rnd-southerniot/rak3112-rs485-node/docs/RUNBOOK.md

# Runbook

Operational log for `rak3112-rs485-node` firmware. Append-only.

## Phase 3 bench checklist + hardware-safety pre-flight

> Run through this **before every flash/monitor** on real hardware (project CLAUDE.md §3,
> firmware domain CLAUDE.md §6). If any item is unknown — **stop and ask**.

1. **H1 jumper INSTALLED** (series 3V3-enable header between RT6160 VOUT and the 3V3 rail).
   A removed jumper cuts 3V3 to the module → board does **not** enumerate on USB and looks
   "not detected" (easy to misdiagnose as a USB/bootloader fault). — ADR-001 EC-5b.
2. **Power:** USB-C (`USB1`) supplies logic via RT6160. Do **not** simultaneously connect the
   DC1 barrel jack and a bench supply without first verifying RT6160 input isolation (§3 #7).
3. **Strap pins:** GPIO0 (SW2/BOOT) is pulled HIGH internally → normal SPI boot; do **not**
   hold SW2 for a normal boot. GPIO45/46 are module-internal / NC — never driven. To force
   download mode (only if `idf.py flash` auto-reset fails): hold SW2, tap SW1, release SW2.
4. **No mass-erase.** `esptool erase_flash` stays gated (§3 #1). Flash is `idf.py flash` /
   `scripts/flash.sh flash` only.
5. **Target verification before flash:** `ls /dev/tty.usbmodem*` then `scripts/flash.sh chip-id`
   → expect **ESP32-S3**. Confirm before writing.

### PASS evidence to capture (quote verbatim here on a green run)

- `Found 8MB PSRAM device` within ~2 s of reset, **and**
- `Adding pool of NNNN KiB of PSRAM memory to heap allocator` in heap-init, **and**
- `rak3112-rs485-node alive: tick=N` incrementing at 1 Hz, **and**
- no bootloop, no `Brownout detector was triggered`, no spurious ROM print on UART0.

### Phase 3 attempts

#### Attempt 1 — 2026-06-20 — PASS (console finding: USB_CDC → USB_SERIAL_JTAG)

**Bench:** two boards connected. Target disambiguated by chip-id/MAC **before** every flash
(Guardrail §3 #1):
- `/dev/cu.usbmodem1301` = **ESP32-S3 (QFN56) rev v0.2, Embedded PSRAM 8MB (AP_3v3)**,
  MAC `3c:dc:75:6f:89:24` → **RAK3112** (target), on its **native USB**.
- `/dev/cu.usbserial-140` = **ESP32-P4**, MAC `30:ed:a0:e1:8e:1c` → unrelated board on a
  USB-UART bridge. Never flashed.

**Console finding (the substantive Phase 3 result).** The Phase-1 default
`CONFIG_ESP_CONSOLE_USB_CDC=y` (OTG/TinyUSB) produced **no visible console** on the RAK3112's
native USB — 0 bytes via raw read *and* via `idf.py monitor`, while the app ran fine (port
stable, no bootloop). The RAK3112 native USB (`USB_D±`) is the ESP32-S3 **USB-Serial-JTAG**
controller — the same interface esptool flashes over. Switching to
`CONFIG_ESP_CONSOLE_USB_SERIAL_JTAG=y` made the console fully visible. This supersedes the
Phase-1 USB_CDC choice in `sdkconfig.defaults`.

Also captured during the investigation: a stale/wedged USB endpoint (`errno 6 Device not
configured`) was cleared by a physical replug + carrier swap; macOS `/dev/cu.*` (call-out)
must be used for reading, not `/dev/tty.*` (dial-in, blocks on carrier).

**PASS evidence (verbatim boot log, USB-Serial-JTAG @ 115200):**

```
rst:0x15 (USB_UART_CHIP_RESET),boot:0x2a (SPI_FAST_FLASH_BOOT)
I (24) boot: ESP-IDF v5.5.4-dirty 2nd stage bootloader
I (25) boot.esp32s3: Boot SPI Speed : 80MHz   SPI Mode : DIO   SPI Flash Size : 16MB
I (73) octal_psram: vendor id    : 0x0d (AP)
I (74) octal_psram: VCC          : 0x01 (3V)
I (75) esp_psram: Found 8MB PSRAM device
I (76) esp_psram: Speed: 40MHz
I (807) esp_psram: SPI SRAM memory test OK
I (816) cpu_start: Pro cpu start user code
I (816) app_init: Project name:     rak3112_rs485_node
I (819) esp_psram: Adding pool of 8192K of PSRAM memory to heap allocator
I (832) app: reserved pins GPIO9/GPIO40 held floating (V1.2 I2C placeholder)
rak3112-rs485-node alive: tick=0
rak3112-rs485-node alive: tick=1
...
rak3112-rs485-node alive: tick=10
```

**Gate result — all PASS:**
- `Found 8MB PSRAM device` present within ~75 ms of reset ✅
- `Adding pool of 8192K of PSRAM memory to heap allocator` present ✅
- Octal mode + 3 V confirmed empirically (`octal_psram vendor id 0x0d (AP)`, `VCC 0x01 (3V)`) —
  matches ADR-001 EC-6 (ESP32-S3R8) ✅
- `SPI SRAM memory test OK` ✅
- GPIO9/GPIO40 floating-init log present ✅ (ADR-001 EC-4/EC-9 carry-forward)
- Heartbeat 1 Hz, monotonic, **no bootloop**, single `rst:0x15`, no `Brownout`/`panic`/`abort` ✅

**Carry-forward note for the contract:** Phase 3 title says "USB-CDC console"; the verified
console is **USB-Serial-JTAG** (native USB). Treat "USB-CDC" in the Phase 3 heading as
"native-USB console". `CONFIG_SPIRAM_SPEED` defaults to 40 MHz (Octal) — a deliberate
non-decision so far; pin explicitly if the 80 MHz bandwidth is ever needed (see Phase 3 review
finding on implicit SPIRAM defaults).

#### Attempt 2 — 2026-06-20 — PASS (re-validated on the CORRECT project board)

**Board correction.** Attempt 1 was flashed to an ESP32-S3R8 with MAC `3c:dc:75:6f:89:24` —
the operator subsequently identified that unit as **NOT the project board** (a second RAK3112
whose pins are not broken out). The actual project board is a *different* RAK3112,
MAC **`3c:dc:75:6f:85:dc`** (pins exposed), enumerating on the same native USB
`/dev/cu.usbmodem1301`. Lesson reinforced: chip-id alone is insufficient when multiple
same-silicon boards are on the bench — **match the MAC to the known project unit** before flash.

Re-flashed the byte-identical Phase-3 firmware (same commit, `phase-3-first-flash-green`) to the
correct board and re-captured. **All gate criteria PASS, identical to Attempt 1:**

```
rst:0x15 (USB_UART_CHIP_RESET),boot:0x28 (SPI_FAST_FLASH_BOOT)
I (73) octal_psram: vendor id    : 0x0d (AP)
I (74) octal_psram: VCC          : 0x01 (3V)
I (75) esp_psram: Found 8MB PSRAM device
I (807) esp_psram: SPI SRAM memory test OK
I (819) esp_psram: Adding pool of 8192K of PSRAM memory to heap allocator
I (832) app: reserved pins GPIO9/GPIO40 held floating (V1.2 I2C placeholder)
rak3112-rs485-node alive: tick=0 .. tick=10   (1 Hz, monotonic, no bootloop)
```

`Found 8MB PSRAM device` ✅ · `Adding pool of 8192K … heap allocator` ✅ · Octal+3V
(`vendor id 0x0d (AP)`, `VCC 0x01 (3V)`) = ESP32-S3R8 ✅ · `SPI SRAM memory test OK` ✅ ·
GPIO9/40 floating ✅ · 1 Hz heartbeat, no `Brownout`/`panic`/`abort` ✅. The Phase 3 sign-off and
tag `phase-3-first-flash-green` stand — same firmware, same PASS, now on the correct unit.

**The project board is MAC `3c:dc:75:6f:85:dc` — use this MAC as the flash-target identity from
Phase 4 onward** (the pins-exposed unit needed for RS-485 / SX1262 bring-up).

## Phase 4 — RS-485 echo: bench setup + attempts

### Bench setup (HIL)

- **Field wiring:** CN1 (3-pin) → USB-RS485 adapter: `A`↔`A`, `B`↔`B`, `GND`↔`GND`.
- **Termination:** the board has **no on-board 120 Ω** (ADR-002). Fit **120 Ω across A/B at both
  bus ends** — one at the adapter, one at the node (or, for the 9600 low-speed first pass on a
  short stub, a single 120 Ω is tolerable). At 115200 use both.
- **Fail-safe bias:** confirm idle line is quiet; if spurious RX bytes appear at idle, add bias at
  one end (A→3V3 / B→GND via ~560 Ω–1 kΩ). R38/R39 (2.2 kΩ) may already provide this — verify.
- **Logic analyzer:** Saleae Logic 2 on **GPIO21** (DE/RE) and the A/B pair; trigger on a TX burst.
- **Project board only:** flash target **MAC `3c:dc:75:6f:85:dc`** (`/dev/cu.usbmodem1301`).

### Two-pass gate (per ADR-002)

1. `RS485_ECHO_BAUD = 9600`, build+flash, loop a 256-byte pattern from the adapter → byte-identical
   echo, 0 framing errors, idle quiet.
2. Change `RS485_ECHO_BAUD = 115200` in `firmware/main/app_main.c`, re-flash, repeat.
3. Saleae: DE-assert→first-bit and last-bit→DE-release within TP8485E spec; no contention.

### Attempt 1 — 2026-06-20 — on-target bring-up PASS (HIL echo pending bench gear)

Firmware (UART1 half-duplex + inverted RTS) flashed to the project board (MAC `…85:dc`).
On-target init verified from the boot log (bus not yet connected):

```
I (837) rs485: RS-485 UART1 up: TX=43 RX=44 DE/RE=21 @ 9600 8N1 (half-duplex, RTS inverted)
I (5837) app: rs485 echo alive: 0 bytes echoed
rak3112-rs485-node alive: tick=0 / tick=1   (5 s cadence)
```

`rs485_init()` (driver install + param + set_pin + RS485 half-duplex mode + RTS invert) returned
ESP_OK — `ESP_ERROR_CHECK` did not abort. PSRAM + GPIO9/40 floating still nominal; no bootloop.
Host `ctest` (ring_buffer, 6 checks) green. **HIL echo + DE/RE turnaround (9600 → 115200) held
pending USB-RS485 adapter + Saleae on the bench.** Binary SHA-256
`8fca54c7e23908108d3a15e9f4a2144836cf097a707f5b2a519fe2fd6d3bb225`.

### Attempt 2 — 2026-06-20 — HIL echo PASS (DE/RE polarity was inverted in the spec)

**Smoke gate PASS — byte-identical echo at both bauds**, driven host-side through a USB-RS485
adapter (256-byte ramp pattern, 16-byte half-duplex bursts):

| Baud | sent | echoed | identical |
|---|---|---|---|
| 9600 8N1 | 256 | 256 | **yes** |
| 115200 8N1 | 256 | 256 | **yes** |

**Root-cause lesson — believe the instrument, not the spec; and build a ground-truth detector
early.** Bring-up burned many cycles chasing the adapter and A/B polarity (two adapters, both
A/B orientations, RTS/DTR combos, a 5V jumper) — all red herrings. The break came from a
*reliable detector*: reading the DUT's own RX counter over the (now-working) USB-Serial-JTAG
console, then a toggle diagnostic that drove GPIO21 as a plain output alternating HIGH/LOW
while listening. Result was unambiguous: **GPIO21 LOW → clean RX of the pattern; GPIO21 HIGH →
nothing.** So DE/RE is **standard** (HIGH=TX, LOW=RX), *not* inverted.

`ADR-001 EC-5a` had documented it inverted (`GPIO21 HIGH = receive`); `rs485.c` faithfully
inverted RTS to match, which **idled U9 in transmit** — the node never listened and its driver
contended with the partner (that's why earlier captures were empty or garbled). Fix:
`uart_set_line_inverse(..., UART_SIGNAL_INV_DISABLE)` (no inversion). Corrected in firmware
(ADR-002 rev2, `gpio_remap.h`, `PIN_MAP.md`) and hardware-side (ADR-001 EC-5a correction).

Adapter note: once polarity was right, **Adapter 1 (CH340)** gave byte-identical echo at both
bauds. Adapter 2 (FT232/75176) delivered no signal in this setup (separate, unresolved adapter
issue) — not on the project's critical path.

Saleae DE/RE turnaround characterization: deferred/optional — byte-identical echo at 115200
(where turnaround margin is tightest) already demonstrates correct DE assert/deassert timing.

## Phase 5 — LoRaWAN OTAA (AS923): attempts

### 5a — 2026-06-20 — SX1262 SPI bring-up PASS (pins confirmed, NO TX)

**Finding (research): ADR-001's SX1262 SPI pins were wrong.** ADR-001 labelled the module-edge
`GPIO10–13 / SPI_*` pins as the SX1262 SPI. Those are a **separate user SPI**; the radio is on a
different **module-internal** bus. Triangulated from RAK3112 datasheet + RAK forum (carlrowan
RadioLib config) + Zephyr `rak3112` DTS — all agree:

| SX1262 | GPIO | | SX1262 | GPIO |
|---|---|---|---|---|
| NSS/CS | 7 | | BUSY | 48 |
| SCK | 5 | | DIO1 (IRQ) | 47 |
| MOSI | 6 | | NRESET | 8 (open-drain) |
| MISO | 3 | | ANT_SW | 4 (active-low) |

RF switch driven by SX1262 **DIO2** (`setDio2AsRfSwitch`), TCXO by **DIO3** — both SPI-internal,
not MCU pins. (GPIO3 is a JTAG-source strap at reset but free post-boot = MISO.)

**Bench confirmation (no-TX SPI probe, no antenna — safe).** Probe: SPI2 on the pins above,
hardware reset, then GetStatus + register write/read round-trip. Console (project board MAC
`3c:dc:75:6f:85:dc`):

```
lora_probe: SX1262 probe: NSS=7 SCK=5 MOSI=6 MISO=3 RST=8 BUSY=48 DIO1=47
lora_probe: post-reset BUSY=0
lora_probe: GetStatus=0x2a  regRW[wab:rab w55:r55 w12:r12 ] => SPI OK -> pins CONFIRMED
```

`BUSY=0` after reset, `GetStatus=0x2a` (chip mode = STBY_RC, sane post-reset), and all three
register write/read pairs matched → **SPI comms confirmed, pins correct.** Zero RF emitted.
Pins locked in `gpio_remap.h`; ADR-001 SX1262 pin map corrected hw-side. **Stack = RadioLib**
(native ESP-IDF, ADR-003). **5b (OTAA join, RF TX) held pending a 50 Ω antenna/dummy load** and
go-ahead to register a test DevEUI on ChirpStack `10.10.8.140`.

### 5b-prov — 2026-06-20 — CRM provisioning COMPLETE (device registered in ChirpStack)

Provisioned the node **end-to-end through the SCOMM CRM** (system of record) per the firmware↔CRM
handoff contract — not by hitting ChirpStack directly. Tool: `tools/provision_node.py` (chains
the workflow API; reads CRM creds from `~/.config/siot/rak3112-crm.env`, DevEUI/AppKey from the
gitignored `firmware/.env`). CRM repo: `rnd-southerniot/siot-crm-review`.

- **DevEUI** `3cdc75fffe6f85dc` — derived from the ESP32-S3 MAC `3c:dc:75:6f:85:dc` (EUI-64,
  fffe-inserted) → deterministic / re-provisionable. **JoinEUI** `0000…0`. **AppKey** generated
  (16 B, in `firmware/.env`, gitignored — never logged/committed; gitleaks clean).
- CRM product `RAK3112-RS485-AS923` (`isLorawanProduct`, AS923) created + SOP template; onboarding
  task walked SCHEDULED_VISIT → REQUIREMENTS_COMPLETE → HARDWARE_PROCUREMENT_COMPLETE →
  HARDWARE_PREPARED_COMPLETE (DevEUI/AppKey in `deviceList`) → checklist → READY_FOR_INSTALLATION.
- **Result:** CRM `lorawanProvisioningStatus=COMPLETED`; `GET /chirpstack/device/3cdc75fffe6f85dc`
  → `found=true`, name `RAK3112-RS485-6F85DC`, on AS923 OTAA app `9dcd1954…` + device profile
  `80b53d57…`. Device is ready for OTAA join (ADR-004 = AS923-1).

Contract gotchas captured (vs the handoff note / agent contract): SOP-template POST needs
`productId` in the body + steps with `id/title/description/order`; READY_FOR_INSTALLATION takes
an **empty** body (whitelist rejects lat/long). Used the seeded ADMIN account (passes all role
gates). **Security flag:** the production CRM's seeded admin/role passwords are hardcoded in the
**public** `siot-crm-review` `prisma/seed.ts` — recommend rotating + moving to env (global §8).

Still pending for the actual join (RF TX): RadioLib firmware integration, **50 Ω antenna**, and
**TCXO voltage confirm** (1.6 V vs 1.8 V, ADR-003 open item).

### 5b-fw — 2026-06-20 — OTAA JOIN SUCCESS; data uplink TxDone open

RadioLib 7.7.1 integrated as a native ESP-IDF managed component (`firmware/main/idf_component.yml`)
with a vendored S3 HAL (`EspHalS3.h`) — **the bundled `EspHal.h` is ESP32-classic only and
`#error`s on S3** (it bit-bangs classic SPI registers); reimplemented on `spi_master`/`gpio`.
C++ `lora.cpp` behind a C API (`lora.h`) for `app_main.c`. Antenna attached.

- **TCXO = 1.8 V works** (first try; `radio.begin(..., 1.8f, false)`), `setDio2AsRfSwitch(true)`.
- **OTAA JOIN SUCCESS** at AS923-1 on the project board (DevEUI `3cdc75fffe6f85dc`):
  `JOINED AS923 (new session)` — RadioLib received the JoinAccept, i.e. ChirpStack
  (`10.10.8.140`) accepted our JoinRequest (AppKey valid) and downlinked the accept. **Full RF
  TX+RX round-trip + the device is live on the network.**
- **DevNonce persistence (NVS)** added and verified: first boot's join used DevNonce ~0;
  reboots without persistence failed `-1116` (no-join-accept — ChirpStack rejects reused/lower
  DevNonce). Persisting the nonces buffer after every attempt makes DevNonce climb monotonically
  → re-join succeeded on the next attempt; session is also persisted/restored
  (`session restored (no re-join)` on subsequent boots, instant).

**OPEN — data uplink `sendReceive` returns `-5 RADIOLIB_ERR_TX_TIMEOUT`** (consistent, both on a
fresh `NEW_SESSION` and on `SESSION_RESTORED`). It fails in ~190 ms — too fast for an SF9 ToA
timeout, so it's **not** data-rate/ToA (forcing DR3+ADR-off did not help), and not nonce/session
(the session is valid). The join's TX gets its TxDone, but the data-uplink TX does not — prime
suspect was the vendored `EspHalS3` DIO1 ISR path. **ISR FIXED** (proper `void(void*)` trampoline
instead of the UB function-pointer cast; ISR service installed without `ESP_INTR_FLAG_IRAM`) — a
real latent bug, but it did NOT clear the -5. **Refined root cause (from RadioLib source):**
`LoRaWANNode::transmitUplink` (LoRaWAN.cpp:1531) does NOT use the ISR — it **polls
`digitalRead(DIO1/GPIO47)`** for TxDone after `sleepDelay(ToA)`, and times out at `txEnd +
scanGuard`. The radio's TX is staged + launched without error (the `RADIOLIB_ASSERT`s pass), but
**TxDone never asserts on the data uplink** — while the join's TX (same polling path) did. So the
SetTx is accepted but the transmit doesn't complete/assert DIO1 on the data frame specifically.
Next debug step: enable `RADIOLIB_DEBUG_PROTOCOL`/`_BASIC` to capture the uplink's actual DR / ToA /
TX power / channel and where it diverges from the join, and scope GPIO47 (+ the RF) on a data TX.
Whether the frame physically goes out
(ChirpStack frame log) couldn't be checked — the CRM `/chirpstack/device` endpoint returns device
config only (no last-seen/fcnt/frames). **Phase 5 not signed off until an uplink frame lands.**

### 5c — 2026-06-22 — data uplink `-5` FIXED (100 Hz FreeRTOS tick was the root cause)

**Fix: `CONFIG_FREERTOS_HZ=1000` in `sdkconfig.defaults`.** Single change; bench-verified.

The 5b-fw "refined root cause" (TxDone never asserts on the data frame specifically) was a
misread — and so was "fails in ~190 ms, too fast for an SF9 ToA timeout, so not data-rate." The
fast failure *is* the tell. `LoRaWANNode::transmitUplink` waits with `sleepDelay(toa)` then polls
`digitalRead(DIO1)` until `millis() > txEnd + scanGuard`, and **`scanGuard = 10 ms`**
(LoRaWAN.h:990). At the ESP-IDF default **100 Hz tick (10 ms)**:

- `sleepDelay(toa)` → `vTaskDelay(pdMS_TO_TICKS(toa))` quantizes/undershoots the air-time by up
  to one tick (≈10 ms), so the poll starts *before* the real TxDone; and
- `millis()` advances in 10 ms steps and the guard is exactly **1 tick**, so `txEnd + 10 ms` is
  reached almost immediately → `-5` in ~one tick. That's why it "failed too fast" and why forcing
  DR3/ADR-off did nothing — it was never a DR/ToA problem.

At **1000 Hz**: `sleepDelay` is accurate to ~1 ms and the 10 ms guard is 10 ticks of real poll
window → DIO1 is caught every time. (The join tolerated 100 Hz because `app_main` retries the
join 5× and its longer-ToA timing occasionally aligned; the periodic data uplink had no such
retry, so it failed every cycle.) The earlier DIO1-ISR-trampoline fix (5b-fw) was a real latent
bug on the **downlink** ISR path and is kept — it just wasn't this bug.

**Bench evidence (project board, S3R8, MAC `3c:dc:75:6f:85:dc`, `/dev/cu.usbmodem1401`):**
`idf.py flash` of the 1 kHz build, then **4/4 consecutive `uplink OK (rx window=0)`** at uptimes
65 s / 128 s / 190 s / 252 s, **zero `-5`** — replacing the previously consistent `uplink failed
(-5)`. `rx window=0` = uplink sent, no downlink pending (correct for an unconfirmed uplink).
Binary SHA-256 `38105b4eaa218685a218a2505b3d2af7c5de2cc4e3b9dfd03fe926e32f9b9f9a`, `IDF_VER=v5.5.4-dirty`
(local PARLIO mod, off-compile-path, Footnote 1).

**Lesson:** RadioLib LoRaWAN on ESP-IDF needs a 1 kHz FreeRTOS tick — its TX-done guard and RX
window timing assume ~ms scheduling granularity; the 100 Hz default silently breaks sub-tick
waits.

**END-TO-END CONFIRMED (2026-06-22):** uplink frame captured in the ChirpStack frame log
(`10.10.8.140:8080` UI). `UnconfirmedDataUp`, DevAddr `01db1032`, **fPort 1**, frm_payload
**`a500245a`** (= `A5 00 24 5A`, our `{0xA5,n>>8,n,0x5A}` with n=36), **fCnt 98** (advancing,
NVS-persisted), ADR off, **SF9/BW125/CR4_5 = DR3** on **923.4 MHz**, region `as923_1`,
`CRC_OK`, RSSI −48 dBm, SNR +12.2 dB via gateway `ac1f09fffe1f340d`. Every field matches the
firmware config — the uplink path is fully working end-to-end. The CRM `/chirpstack/device`
endpoint (`:4000`) returns config only (no telemetry); frame verification must use the
ChirpStack UI/API at `:8080` directly. **Phase 5 uplink milestone: PASS.** (Remaining Phase 5
sign-off scope — ADR-003 stack / ADR-004 sub-band formal close, payload schema — tracked separately.)

## Phase 6 — Modbus RTU master: device pivot to SELEC MFM384 (2026-06-24)

**Target change.** Phase 6 bring-up retargeted from the RS-FSJT-N01 wind sensor to a **SELEC
MFM384** 3-phase multifunction meter. Rationale: the RS-FSJT bench was blocked on a sensor↔CN1
*physical* join (open conductor / no common GND in both A/B orientations — node CN1 TX path itself
proven byte-perfect in Phase 4). The firmware was never the blocker. The MFM384 is mains/aux-powered
with its own RS-485 terminals (no separate bus PSU to lose), so it sidesteps that failure mode.

**MFM384 Modbus map** (from the org's proven RAK3312 bring-up, `rnd-southerniot/rak3312-rs485-plan`
`docs/rak3312/MODBUS_MAP.md`, which reached Gate 8 live publish on this exact meter):

| Read | FC | Register (human → wire) | Type | Notes |
|---|---|---|---|---|
| Linkcheck | 0x03 | 40007 → 6 | uint16 | any reply proves the link |
| Endianness | 0x03 | 40070 → 69 | uint16 | expect `1` = ABCD word order |
| Total active energy | 0x04 | 30090..30091 → 89..90 | float32 ABCD | kWh |

Serial (org bench known-good): **9600 8N1, unit 1**. MFM384 baud/unit are front-panel configurable,
so the operator's meter may differ — the scan profile sweeps baud×parity if so.

**Firmware support added this session** (float32 + FC04, on top of the existing 6a/6b framing):
- `modbus_rtu`: pure `modbus_regs_to_f32(regs, ABCD|CDAB)` — host-tested KAT (`{0x447A,0x0000}` ABCD
  = 1000.0f). No aliasing UB (memcpy type-pun).
- Poll bring-up mode now takes a function code (FC03/FC04) and an optional float32 read (2 regs);
  scan probe register is now configurable.

**Bench bring-up sequence (operator):**
1. **Wiring:** MFM384 A/B → CN1 A/B, and a **common GND** (meter RS-485 GND ↔ CN1 GND). Confirm the
   meter is powered (front-panel lit) and in **RTU** mode at its configured baud/unit.
2. **Linkcheck first** (quick "is it alive", uint16 @ FC03 reg 6):
   ```bash
   cd firmware && . ~/esp/esp-idf-v5.5.4/export.sh
   idf.py -DSDKCONFIG_DEFAULTS="sdkconfig.defaults;sdkconfig.defaults.poll" build flash monitor
   # expect: [n] reg6 = <value> (raw, 0x....)   — a reply = link good. swap A/B if it times out.
   ```
3. **If linkcheck times out / unknown baud:** run the scanner (sweeps baud×parity×unit IDs):
   ```bash
   idf.py -DSDKCONFIG_DEFAULTS="sdkconfig.defaults;sdkconfig.defaults.scan" build flash monitor
   ```
   (Set `CONFIG_APP_MODBUS_SCAN_PROBE_REG=6` for the MFM384's known-good holding register.)
4. **Real measurand** (total active energy, float32 kWh @ FC04 reg 89..90):
   ```bash
   idf.py -DSDKCONFIG_DEFAULTS="sdkconfig.defaults;sdkconfig.defaults.mfm384" build flash monitor
   # expect: [n] reg89..90 = 0x........  = <kWh>
   ```
   If the float looks like garbage, the meter uses CDAB — set `CONFIG_APP_MODBUS_POLL_FLOAT_CDAB=y`.

The old RS-FSJT profile is preserved as `sdkconfig.defaults.poll-rsfsjt` (4800 8N1, FC03 reg 0).

**Attempt 1 — scan, MFM384 not reached (2026-06-24).** Flashed `sdkconfig.defaults.scan` to project
board MAC `3c:dc:75:6f:85:dc` (ESP32-S3R8, 8MB octal PSRAM OK, native USB `/dev/cu.usbmodem11301`).
Full sweep ran clean: 18 combos (9600/4800/19200/38400/57600/115200 × 8N1/8E1/8O1), IDs 1–10, FC03
@reg 6, 300 ms timeout → **0 devices, 0 garbage in every combo**. Firmware/board healthy (scan
executed start to finish). `0 garbage` everywhere ⇒ no malformed bytes received at any baud, i.e.
**no electrical return path or no responder** — NOT a baud/parity mismatch (that would surface as
garbage). Distinguishing causes left to the operator: (a) wiring — A/B on CN1, common GND, meter
powered + in Modbus RTU mode; (b) unit ID > 10 (sweep capped at 10; wrong-slave = silence by spec).
**Fastest disambiguation: read baud/parity/slave-ID directly off the MFM384 front-panel setup menu**
and set the poll profile to those exact values, then widen `CONFIG_APP_MODBUS_SCAN_ID_HI` if needed.

**Hardware cross-check vs proven reference (2026-06-24).** The org's `rak3312-rs485-plan`
`examples/rak3312_mfm384` (reached Gate 8 live on this exact meter) was reviewed line-by-line. Our
firmware matches it in every protocol dimension: TX=GPIO43, RX=GPIO44, DE=GPIO21, DE polarity
HIGH=TX/LOW=RX, 9600 8N1 unit 1, linkcheck FC03 reg 6, energy FC04 reg 89 qty 2 with float
`u32=(hi<<16)|lo` (= our ABCD word order). **One difference, and it does NOT apply to us:** the
RAK3312 reference drives RS-485 through a **RAK5802 module with a separate ENABLE pin on GPIO14
(WB_IO2) that must be HIGH before any Modbus traffic** — if low, that module is disabled and the bus
goes totally silent (our exact symptom). Our board has **no such enable pin**: RAK3112 + onboard
TP8485E, DE/RE on GPIO21 only, and Phase 4 echo proved that path works to a USB-RS485 adapter with
GPIO21 alone. So GPIO14 is RAK5802-specific, irrelevant here. **Net: firmware confirmed correct
(twice — Phase 4 echo + reference match); the silence is purely the MFM384↔CN1 physical link.** The
reference's own troubleshooting reduces to "confirm A/B wiring and common GND" — which is the bench
action. SELEC MFM384 RS-485 terminals may be labeled opposite to CN1 A/B → try both orientations.

**Attempt 2 — FC03 + FC04 polls, still silent (2026-06-24).** Operator confirmed meter target
9600 / unit 1 / parity none. Flashed `sdkconfig.defaults.poll` (FC03 reg 6, linkcheck) → steady
`timeout (st=-2)`, 0 bytes. Then a **second proven reference** was reviewed:
`southern-rnd/ETS-LORA-Test/.../rak3112_ets_careflow_anemometer_espidf` — **same RAK3112 + same
MFM384, ESP-IDF, tested working**. It reads the MFM384 **entirely over FC04 input registers**
(voltage-first map: V1N @ reg 0, …, Total kWh @ reg 58), float via `memcpy` of
`u32=(hi<<16)|lo` with **first register = LOW word (CDAB)** — note this conflicts with the RAK3312
gate3 map (energy @ reg 89, first register = HIGH word = ABCD); the two proven repos disagree on
both register map and word order, so when bytes finally flow we must try FC04, both maps, and both
word orders. Pins/baud/DE-polarity all match ours (TX43/RX44, 9600 8N1, HIGH=TX). DE pin differs
(ETS=GPIO34) but that's a *different carrier* (TFT/touch/RFID board); our DE=GPIO21 is Phase-4-proven
(echo 256/256 — impossible unless GPIO21 drives our TP8485E) and confirmed in this boot log
(`UART1 up: TX=43 RX=44 DE/RE=21`). Acting on the FC04 finding, flashed `sdkconfig.defaults.mfm384-volt`
(FC04 reg 0, float32) → **still `timeout (st=-2)`, 0 bytes**. **Verdict: function code is NOT the
cause; the meter returns zero bytes for both FC03 and FC04 at the swept baud/parity. Firmware
exonerated three independent ways (Phase 4 echo + RAK3312 + ETS). Blocker is purely physical /
meter-not-transmitting.** No firmware change can turn zero returned bytes into data. Next is an
electrical bench check (see below) — not more flashing.

**Electrical bench plan (operator — localizes node-TX vs meter-reply vs wiring):**
1. **Is the MFM384 actually wired to CN1 and powered right now?** It needs its aux/line supply; an
   unpowered meter is dead-silent. Three timeout flashes with proven-correct firmware most often
   means the bus isn't truly connected/powered.
2. **A/B + common GND:** MFM384 A→CN1 A, B→CN1 B (try the swap — SELEC labels may be reversed), and
   meter RS-485 GND/COM → CN1 GND. Verify each with a multimeter continuity check.
3. **Scope/Saleae** (the ground-truth detector, per the RS-FSJT lesson) on **GPIO43 (TX)**,
   **GPIO21 (DE)**, and **CN1 A/B** during a poll tick: confirm (a) a TX frame leaves on GPIO43,
   (b) DE pulses high around it, (c) the A/B differential actually swings, (d) whether the meter
   ever drives a reply. This isolates node-TX vs meter-reply vs cabling in one capture.
4. **Meter config:** confirm RS-485/Modbus output is **enabled** in the MFM384 menu (not just baud
   set) and that 9600/8N1/unit-1 are the *active* settings, not defaults shown on a spec sheet.

**Attempt 3 — proven ETS code flashed verbatim, still times out (2026-06-24).** Operator reported
power/A-B/GND/meter-config all checked OK, and asked to flash the proven `ETS-LORA-Test` code on our
board changing only DE/RE GPIO34→GPIO21. The full ETS app is a *touchscreen* app (Modbus only runs
after a TFT tap; never polls headless) and needs the Arduino+TFT_eSPI BSP — so instead a **minimal
headless port** was built (scratch `mfm_ets_test/`): their **`ModbusMaster` library verbatim**, their
exact init/read/preTransmission/postTransmission, DE=GPIO21, UART1 TX43/RX44 9600 8N1 unit 1,
auto-polling FC04 reg 0 + FC03 reg 6, logging over USB-JTAG. arduino-esp32 **3.3.10** resolved/built
clean against IDF 5.5.4. Flashed to board `3c:dc:75:6f:85:dc`. Result: **`err=0xE2`
(`ku8MBResponseTimedOut`) on every read, both FCs** — identical to our own firmware. **The proven
known-good code gets nothing back either ⇒ firmware is exonerated a 4th way (Phase 4 echo + RAK3312
+ ETS source match + ETS code run verbatim). The fault is purely physical, localized to this bench's
node↔meter link.**

**Cleanest next split (no scope needed — same method that cleared the RS-FSJT sensor): cross-check
with the USB-RS485 adapter.** Move the adapter onto the *exact* wiring going to the MFM384 (adapter
A/B/GND where CN1 connects) and run `pymodbus` from the Mac (FC04 reg 0 and FC03 reg 6, 9600 8N1
unit 1). Two outcomes:
- **Adapter ALSO can't read the meter** → fault is the **meter or its wiring/power** (not our board).
  Focus there: re-meter GND continuity, try A/B swap at the meter terminals, confirm the meter's
  RS-485 port is the right terminal pair and is enabled, consider 120 Ω termination + bias.
- **Adapter CAN read it but our board can't** → fault is **our board's CN1 / TP8485E path to this
  meter** (despite Phase 4 echo). Then scope GPIO43(TX)/GPIO21(DE)/CN1 A-B to find where the frame
  dies. (Note: Phase 4 echo used an adapter with strong internal bias/termination; a bias/termination
  difference on this meter link is a candidate — ADR-002 left 120 Ω + fail-safe bias external.)

**Attempt 4 — RESOLVED: DE/RE wiring fault; MFM384 read live (2026-06-24).** Operator found and
fixed a **DE/RE connection issue** at the bench. Re-monitored the still-flashed ETS-port test →
**immediate success**: `FC04 reg0 OK: 0x424A51EC = 50.58 (V1N)` and `FC03 reg6 OK: 350` every cycle,
zero timeouts. The DE/RE fault was the entire blocker — with the transceiver never switching
direction correctly, the meter never saw a valid frame (or the node never released to RX). **Firmware
was correct all along (proven 5 ways).** Reflashed **our** firmware (`sdkconfig.defaults.mfm384-volt`,
FC04 reg 0 float) → first attempt showed garbage floats with raw words like `0xC28F424A`; the high
word `424A` (voltage ~50 = 0x424A…) sat in the **second** register ⇒ this meter transmits **low word
first = CDAB**, not ABCD. The ETS code reads `buffer[0]` as the low word (CDAB) — correct for this
meter; the RAK3312 "ABCD" note did NOT hold here. Set `CONFIG_APP_MODBUS_POLL_FLOAT_CDAB=y` → **our
firmware reads V1N ≈ 50.5 V stable, zero timeouts** (`0xD70A4249 = 50.460` … `0x3333424A = 50.550`).
**Locked facts for this MFM384: FC04 input registers, ETS voltage-first map (reg 0 = V1N), CDAB word
order, 9600 8N1 unit 1.** Profiles updated: `.mfm384-volt` (FC04 reg 0 V1N, CDAB), `.mfm384` (FC04
reg 58 Total kWh, CDAB). **Bring-up GREEN — our node reads the meter.** Remaining = 6c (NVS register
set + ADR-005 payload + LoRaWAN uplink + ChirpStack decoder), then push/CI/merge/tag.

**Phase 6c bench — RS-FSJT real read + LoRaWAN uplink GREEN (2026-06-24, home lab).** With the
RS-FSJT-N01 on CN1: `sdkconfig.defaults.poll-rsfsjt` confirmed the sensor reads (unit 1, FC03 reg 0,
4800 8N1, zero timeouts) — still air raw 0–4, **blow test raw 33–58 ⇒ ~3.3–5.8 m/s, locking scale at
raw/10** (÷100 ruled out; `meter_read_rsfsjt` already correct). Then `sdkconfig.defaults.field-rsfsjt`
(real field app): session restored from Phase 5 NVS (no re-join), `field app: REAL Modbus`,
`[0] RS-FSJT wind=0.40 m/s -> 5 B`, **`uplink OK (rx window=0)`**, repeating each 60 s — no `-5`, no
timeouts. ADR-005 RS-FSJT payload `0102000028` (v1, dev=RS-FSJT, flags=0, wind 0x0028=40 ÷100=0.40
m/s) on fPort 1. **Real sensor → encode → LoRaWAN → ChirpStack path proven for RS-FSJT.** Decoder =
`tools/chirpstack_mfm384_decoder.js`. MFM384 not available at home → its uplink leg validates via
`sdkconfig.defaults.sim-mfm384` (same payload/decoder, simulated flag). Remaining to close Phase 6:
confirm ChirpStack decode render, run the sim-mfm384 uplink, then push/CI/merge/tag.

**Lesson (RS-485 bring-up).** A DE/RE direction-control wiring fault presents as *total silence /
0 garbage* at every baud/parity — indistinguishable at the protocol layer from an unpowered or
unwired slave. When the bus is dead-silent in all configs and the framing is known-good, suspect the
**direction pin's wiring/continuity** early, alongside A/B and GND. Running a second, independently-
proven master (the ETS `ModbusMaster` port) let us assert "firmware is not the problem" with
confidence *before* the wiring fix — and the same harness immediately confirmed the fix.

**Remaining Phase 6 (6c):** NVS register-set config, ADR-005 payload schema (compact versioned
binary + ChirpStack JS codec), encode MFM384 reads into the LoRaWAN uplink, then push/CI/merge/tag.

## Phase 7a — Resilience: task watchdog + brownout + reset-cause (2026-06-25)

**Goal (7a).** Arm the Task Watchdog on the field-app task, log the reset cause + a persistent boot
counter at startup, and keep the brownout detector enabled — so a hung loop or a sagging rail forces
a clean, *logged* reset instead of a silent wedge.

**Implementation (`app_main.c`, `Kconfig.projbuild`, `sdkconfig.defaults`).**
- `log_boot_diagnostics()` runs first in `app_main`: `esp_reset_reason()` → human label, plus an NVS
  (`faultlog/bootcnt`) counter incremented every boot (seed of the firmware §8 fault log).
- `field_wdt_arm()` reconfigures the TWDT to `CONFIG_APP_TASK_WDT_TIMEOUT_S` (panic-on-starve) and
  subscribes the field-app task; the loop calls `esp_task_wdt_reset()` at the top of each cycle.
- **Key design point — fed sleep.** The inter-sample `vTaskDelay(period)` is replaced by
  `wdt_fed_delay()`, which splits the wait into ≤ 2 s chunks and feeds the WDT each chunk. Without
  this, a 60 s sample interval would starve any sub-60 s watchdog; with it, the long intentional
  sleep keeps the dog fed while a genuine hang in the work section still trips it.
- Brownout: `CONFIG_ESP_BROWNOUT_DET=y` at the IDF S3 default level (LVL_SEL_7) — pinned explicitly,
  not raised (a too-high threshold would spuriously reset on the RT6160 rail).
- Gate aid: `CONFIG_APP_DEBUG_WDT_STARVE` stops feeding after N cycles (profile
  `sdkconfig.defaults.wdt-test`). **Never ship set.**

**HW pre-flight (passed).** Single port `/dev/cu.usbmodem1301`, ESP32-S3, MAC `3c:dc:75:6f:85:dc` =
the project board (USB enumeration also confirms H1 / 3V3 in). No second board to confuse.

**Smoke gate — both halves PASS (HIL, project board).**

*Half 1 — the watchdog fires + the reset cause is logged* (profile `wdt-test`, 10 s timeout, starve
after 2 cycles). Captured across reboots:
```
I (15904) lora: uplink OK (rx window=0)
E (15904) app: DEBUG: starving the task watchdog after 2 cycle(s) — expect a TWDT reset in ~10s (7a gate)
E (23441) task_wdt: Task watchdog got triggered. The following tasks/users did not reset the watchdog in time:
E (23441) task_wdt: Aborting.
Rebooting...
rst:0xc (RTC_SW_CPU_RST),boot:0x2b (SPI_FAST_FLASH_BOOT)
W (852) app: === boot #2 — reset reason: task-WDT (6) ===
W (853) app: previous boot ended in a WATCHDOG reset
I (896) lora: session restored (no re-join); uplink DR3 (SF9)
I (896) app: task watchdog armed: 10s timeout, panic-on-starve
```
The NVS boot counter incremented `#2 → #3 → #4` across successive WDT resets; each boot correctly
reported `reset reason: task-WDT (6)`. (Session also restored from NVS, no re-join — Phase 5 carry.)

*Half 2 — clean run, no spurious resets* (sim field app, starve OFF). A **~11.5-min bench soak**
(two captures on one uninterrupted run, ~49 uplinks at the 10 s interval): **zero `task_wdt`
triggers, zero brownout events, zero reboots.** The `esp_log` millisecond timer advanced
monotonically across the whole run (15.9 s → 215.6 s → 303 s → **690 s**, never returning to 0),
which is the proof of "no reset" — a reset would zero it.

**Result: 7a GREEN.** Both gate conditions met on the project board. `field_wdt_arm()` + the fed-sleep
pattern carry forward to 7b (light-sleep will change the feed cadence — revisit `APP_TASK_WDT_TIMEOUT_S`
and feed-during-wake then).

**Lesson.** A watchdog on a long-interval sampler is only useful if the *intended* sleep keeps it fed.
Feeding once per multi-second loop forces the timeout above the interval and blinds the dog during the
sleep; chunked feeding (≤ 2 s) keeps the timeout short while still catching real hangs.

## Phase 7d — Provisioning: NVS credentials + runtime config (2026-06-25)

**Goal (7d).** Move OTAA credentials and Modbus field config out of the compiled image and into NVS,
so a node is keyed/configured at provisioning time (not build time) — the headline being *no
compiled-in secrets*. Provision via an on-device console fed by `tools/provision_nvs.py` from
`firmware/.env` (the same source the SCOMM CRM mints).

**Design.**
- **NVS `prov` namespace** holds `deveui`/`joineui` (u64), `appkey` (16-byte blob) and Modbus
  `dev`/`baud`/`par`/`unit`/`intv`. `lora.cpp` prefers NVS creds over the compiled
  `lora_credentials.h` fallback; `lora_is_provisioned()` is false only when *both* are absent
  (empty NVS + all-zero placeholder) → the node waits instead of bogus-joining.
- **Runtime field config** (`app_main.c::load_field_cfg`): NVS `prov` overrides the Kconfig build
  defaults, and the field loop branches on `device` at **runtime** (both MFM384 and RS-FSJT paths
  compiled in) — so meter/baud/interval change with no rebuild.
- **Additive provisioning, nonces preserved.** Provisioning writes only the `prov` namespace; the
  `lorawan` namespace (DevNonce/session) is untouched — so a re-keyed/re-pointed node still does
  `session restored (no re-join)` with no DevNonce regression (the failure mode a full NVS-image
  overwrite would cause). This is why provisioning is a console (additive) rather than a
  `parttool write_partition` (whole-partition overwrite).
- **Provisioning console** (`provisioning.c`, `CONFIG_APP_PROVISIONING_CONSOLE=y`): a USB-Serial-JTAG
  REPL (`prov-lorawan` / `prov-modbus` / `prov-show` / `prov-clear` / `prov-done`) on its own task,
  available in field mode too (re-point a deployed node without erasing NVS). `tools/provision_nvs.py`
  drives it from `.env`; the AppKey is never echoed (the device runs linenoise in dumb mode → no
  echo, and the tool redacts).

**Smoke gate — all three conditions PASS (HIL, project board, factory/placeholder-creds image).**

1. *Unprovisioned waits, no bogus join.* Empty `prov` + placeholder compiled key:
   ```
   W (871) app: === boot #10 — reset reason: USB (11) ===
   I (1423) prov: provisioning console ready — prov-lorawan / prov-modbus / … ; nonces/session preserved
   prov> W (1435) app: AWAITING PROVISIONING — no LoRaWAN credentials. Run tools/provision_nvs.py …
   ```
   No `OTAA:` / `join attempt` line.

2. *NVS creds drive the join.* `tools/provision_nvs.py … --env env_rsfsjt` wrote
   `dev=1 baud=4800 unit=1 intv=20` + creds (AppKey redacted), `prov-done` restarted; next boot:
   ```
   I (1479) lora: OTAA: DevEUI=3cdc75fffe6f85dc JoinEUI=0000000000000000 [creds:NVS]
   I (1485) lora: session restored (no re-join); uplink DR3 (SF9)
   I (1491) app: field app: REAL Modbus RS-FSJT, unit 1 @ 4800 8N1, 20s interval [cfg:NVS]
   ```
   The compiled key is the all-zero placeholder, so a successful `uplink OK` *can only* be using NVS
   creds; `session restored` confirms nonces survived provisioning.

3. *Config change without rebuild.* Re-running the tool in **field mode** with `env_mfm384`
   (`dev=0 baud=9600 intv=60`) on the **same binary** → next boot:
   ```
   I (1493) app: field app: REAL Modbus MFM384, unit 1 @ 9600 8N1, 60s interval [cfg:NVS]
   ```
   Device/baud/interval all flipped (RS-FSJT/4800/20 → MFM384/9600/60) with no recompile.

**Result: 7d GREEN.** Default (real-creds) image re-flashed to leave the bench clean; it logs
`[creds:NVS]` because the NVS provisioning now takes priority over the compiled fallback — the
intended provisioned state. RS-485 reads stale-flag on the bench (no meter attached) — orthogonal
to 7d (read path proven Phase 6).

**Lessons.**
- *Provision additively.* A whole-NVS-image write (parttool/nvs_partition_gen) wipes the LoRaWAN
  nonces → DevNonce regression → ChirpStack rejects the re-join. Writing only the `prov` namespace
  via a console keeps `lorawan` intact. Worth the extra firmware over the simpler host-image route.
- *Kconfig add needs `rm sdkconfig`.* A new `config` with `default y` did not regenerate into an
  existing `sdkconfig` on an incremental build — the console silently compiled out (binary barely
  grew; `strings`/`nm` showed no `prov-*`). Deleting `sdkconfig` (or `fullclean`) forced the regen.
  Same class as the Phase-7a `SDKCONFIG_DEFAULTS` cache stale. Verify a new Kconfig option lands in
  `sdkconfig` before trusting the build.

## Phase 7c — OTA: dual-slot partitions + rollback (2026-06-25)

**Goal (7c).** Make field updates safe: a dual-slot (ota_0/ota_1) partition layout with bootloader
**app rollback**, so a bad image automatically reverts to the last good one. The headline *risk* is
the partition-table change (a destructive flash-layout edit); the network *transport*
(WiFi/HTTPS or FUOTA, OQ-10) is deferred — it's also blocked on the bench (no WiFi creds, like 7b's
current rig), so 7c exercises the rollback machinery via host-side image staging (`parttool` +
`esp_ota_set_boot_partition`), which drives the *same* esp_ota state machine a network OTA would.

**Design — no destructive erase.** `firmware/partitions.csv` keeps **nvs at the default
0x9000/0x6000**, so the 7d provisioning (`prov`) and LoRaWAN nonces (`lorawan`) survive the layout
change — `idf.py flash` rewrites bootloader + table + `ota_0` + `otadata` but leaves nvs intact.
Layout: `nvs@0x9000(24K) · otadata@0xf000(8K) · phy@0x11000(4K) · ota_0@0x20000(3M) ·
ota_1@0x320000(3M)`. `CONFIG_BOOTLOADER_APP_ROLLBACK_ENABLE=y`.

`ota.c`: logs the running slot + state + build tag at boot; `ota_mark_valid()` cancels the pending
rollback once the app reaches healthy code (no-op for a directly-flashed image); console commands
`ota-status` and `ota-activate <0|1>` (the latter calls `esp_ota_set_boot_partition` → PENDING_VERIFY,
rollback armed → restart). `CONFIG_APP_BUILD_TAG` (A/B) tells builds apart; `CONFIG_APP_DEBUG_OTA_BAD`
builds an image that `abort()`s before mark-valid (profile `sdkconfig.defaults.ota-bad`).

**Hardware safety.** Backed up `0x0..0x110000` (bootloader+table+nvs+phy+app, 1.11 MB) before the
first layout flash — restore with `esptool write_flash 0x0 <backup>`. Project board MAC
`3c:dc:75:6f:85:dc`.

**Smoke gate — all three conditions PASS (HIL, project board).**

1. *Layout flash, nvs preserved.* After flashing the OTA layout (no erase):
   ```
   W (900) ota: running slot=ota_0 state=valid tag='A'
   I (1506) lora: OTAA: DevEUI=3cdc75fffe6f85dc … [creds:NVS]
   I (1518) app: field app: REAL Modbus MFM384 … 60s interval [cfg:NVS]
   ```
   `[creds:NVS]` + `[cfg:NVS]` confirm the 7d provisioning survived the partition change.

2. *OTA to ota_1, marks valid, survives reset.* Staged build **B** into ota_1 (`parttool
   write_partition --partition-name ota_1 --input app_B.bin`), `ota-activate 1`:
   ```
   OK boot -> ota_1 (pending-verify, rollback armed) — restarting
   W (940) ota: ota_1 marked VALID (was pending-verify): ESP_OK
   W (879) ota: running slot=ota_1 state=valid tag='B'   ← after reset #1 AND #2 (persisted)
   ```

3. *Bad image rolls back.* Staged the **BAD** image (`abort()` before mark-valid) into the inactive
   ota_0, `ota-activate 0`:
   ```
   OK boot -> ota_0 (pending-verify, rollback armed) — restarting
   E (849) app: DEBUG: bad OTA image — aborting before mark-valid (7c rollback test)
   abort() was called at PC 0x42007c67 on core 0
   W (903) ota: running slot=ota_1 state=valid tag='B'   ← bootloader rolled back to the good slot
   ```
   Node fully recovered on ota_1/B: `[creds:NVS]` join + `uplink OK`; `ota-status` →
   `running=ota_1 boot=ota_1 next-slot=ota_0`.

**Result: 7c GREEN.** Dual-slot + rollback proven on hardware; nvs/provisioning preserved across the
layout change. Default (tag A) re-flashed → clean `running slot=ota_0 state=valid` production state.
Production binary SHA-256 `5d503aced11a6dba1f0572e0af414b3ac1e0c47eaf75cbf9bb3bde972ec3da11`.
**Deferred (OQ-10):** the network OTA downloader (WiFi/HTTPS, then FUOTA) — blocked on bench WiFi
creds; the partition/rollback foundation it would sit on is now in place.

**Lessons.**
- *Keep nvs put across a partition change.* Holding nvs at its existing offset/size turned a
  "forces a full erase" step into a non-destructive flash — provisioning + LoRaWAN nonces survived,
  no re-join, no re-provision. Worth designing the table around.
- *`SDKCONFIG_DEFAULTS` cache stickiness bites again.* After building with an overlay, a plain
  `idf.py build` reused the cached overlay path and silently produced a **BAD** image labelled as the
  default. Always `fullclean` (or pass `-DSDKCONFIG_DEFAULTS=` explicitly) when switching back to the
  production config, and verify `CONFIG_APP_BUILD_TAG` / `CONFIG_APP_DEBUG_OTA_BAD` before flashing.
- *linenoise eats the first command.* Over a script the REPL enters dumb mode on first contact and
  swallows the first line; send a throwaway `ota-status` to prime it before the real command.

## Phase 7b — Power: light-sleep duty-cycling (2026-06-25) · IMPLEMENTED, power-gate deferred

**Goal (7b).** Cut average current by light-sleeping between samples. Per operator decision this pass
is **functional only, no current target** (OQ-12 open) — a true average-current measurement needs the
board on DC/battery with USB removed, which wasn't set up.

**Implementation.** `CONFIG_APP_LIGHT_SLEEP` (Kconfig, **default OFF**). When on, `wdt_fed_delay()`
makes each ≤2 s chunk a manual `esp_light_sleep_start()` (timer wakeup) instead of `vTaskDelay` —
RAM is retained so the LoRaWAN session survives with no re-join. Chunking keeps the task watchdog
fed; the **idle-task watchdog is disabled when light-sleep is on** (manual light-sleep freezes idle
by design, so watching it would false-trip). `field_wdt_arm()` sets `idle_core_mask=0` in that case.

**KEY FINDING — light-sleep wedges the node on USB power (VBUS present).** On this ESP32-S3 with the
USB-Serial-JTAG console and VBUS applied, the node runs cycle 0, enters light-sleep, and then
**`esptool` itself can no longer connect** ("No serial data received") — a genuine device-level wedge,
not just a dark console. Recovery required **plug-in-while-holding SW2(BOOT)** → USB download mode →
reflash a light-sleep-OFF image. (Plain power-cycle and BOOT+RESET-then-replug were not enough; the
clean download-on-plug was.) This is why `APP_LIGHT_SLEEP` defaults OFF: **enable + verify only on a
DC/battery bench with USB disconnected** — which is also the only setup that measures true average
current (OQ-12). Field nodes run on battery (no VBUS), where light-sleep is expected to behave.

**KEY FINDING — pyserial DTR/RTS held the chip in reset.** Opening the USB-Serial-JTAG port with
pyserial's default `dtr=True/rts=True` drives BOOT/EN and **holds the ESP32-S3 in reset/download** →
"console produces 0 bytes" even on a healthy device. Fix: open with `dtr=False, rts=False`
(`serial.Serial()` then set before/after open). This cost real time masquerading as a device hang.

**What was verified (HIL, project board, light-sleep OFF baseline).** Recovered node: `boot #38`,
OTA layout intact (`ota_0` valid, tag A), `[creds:NVS]`, `session restored`, `field app: REAL Modbus
RS-FSJT … 4800 8N1, 20s [cfg:NVS]`, **two+ cycles** (`[0]`@2.0 s + uplink@4.4 s; `[1]`@24.9 s +
uplink@27.4 s) — continuous field-loop operation, uplinks, session-preservation, monotonic timer (no
reboot). This is the busy-wait baseline; light-sleep *cycling* could not be observed on USB (wedge).

**RS-FSJT real read (Phase 6 follow-up).** With the wind sensor on CN1 the read **succeeded**
pre-disturbance (`RS-FSJT wind=0.00 m/s` in still air, **no "read failed"** — contrast Phase 6's total
silence) → the real read path is closed. After the recovery power-cycles the sensor went **stale**
(`read failed`) — a bench/wiring state (re-seat + let it settle), not firmware.

**Status: 7b IMPLEMENTED; functional cycling + average-current (OQ-12) DEFERRED to a DC/battery
(no-VBUS) bench.** Default firmware is light-sleep OFF (the proven 7a/7c busy-wait behaviour);
light-sleep is opt-in for the battery bench.

**Lessons.** (1) Don't run light-sleep with the USB-Serial-JTAG console + VBUS — it wedges; verify on
battery. (2) De-assert DTR/RTS when reading a USJ port from a script. (3) Recover a wedged USJ board
with plug-in-while-holding-BOOT (download-on-plug), not just reset.

## Session park — 2026-06-28 (7b rig + stepper scan; bench not ready)

**Where we left off** (bench not set up; continuing tomorrow).

**7b current-measurement rig (parked).** Plan B for the OQ-12 average current is an **INA238**
high-side monitor read by a **Raspberry Pi** (`mcp-gateway`, 192.168.68.109, SSH key
`id_ed25519_siot_dev_m5`). Tool `tools/ina238_current.py` is on the Pi at `~/ina238_current.py`
(integrates true time-average over the duty cycle); Pi `i2c-1` enabled at runtime (**non-persistent**
— re-run `sudo dtparam i2c_arm=on` after a reboot), `i2c-tools` installed. Procedure: power the rak
via **P1 with USB unplugged** (no VBUS → light-sleep runs), INA in series, set `--rshunt` to the
board's shunt, run. **Parked because:** bench not ready + the INA238 is in use on another project.
The **light-sleep-ON** image is currently on the rak board → USB is wedge-prone; if `esptool` can't
connect, recover via **plug-in-while-holding-SW2(BOOT)** → download mode → reflash.

**Stepper motion control — MOVED OUT (2026-06-28).** The LEESN IG28ET stepper *motion control* work
(Modbus FC06/FC16 writes, jog/goto/dump bench console, and the decoded LEESN register map) now lives
in its own repo — **`rnd-southerniot/leesn-stepper-control`**. This repo (`rak3112-rs485-node`) is
**RS-485 sensor *reading* only** (FC03/FC04 for meters/sensors → LoRaWAN); the write/motion code was
reverted out (revert of `f6afb2e`). Do **not** add motor-write/jog code back here — extend the
motion-control repo instead. The shared Modbus framing was *copied* (not linked); port any framing fix
across both.

**New team tooling this session:** `docs/prompts/add-sensor-from-datasheet.md` (generate a sensor's
read/sim/payload from a datasheet + proven Arduino code — Arduino is ground-truth for wire details).
## Bench note — sim-mfm384 build/flash/monitor (2026-06-30)

Context: bench validation for SCOMM CRM Phase 2 (02-01 WebSerial/provisioning spike prep). Goal was
build → flash → monitor of the **`sim-mfm384`** profile on a real RAK3112. **No firmware source change**
— this exercised the existing `phase-6-modbus-green`-era tree.

**Toolchain note:** ESP-IDF is NOT installed locally on this machine (`~/esp/esp-idf-v5.5.4/` absent,
`idf.py` not on PATH). Built via the canonical Docker image `espressif/idf:v5.5.4` (per `Dockerfile`),
flashed/monitored host-side (Docker on macOS cannot pass through USB serial).

- **Board ID (pre-flash, §3 #1):** `esptool chip_id` → ESP32-S3, Embedded PSRAM 8MB, **MAC
  `3c:dc:75:6f:85:dc`** = the project board (matches §6 Phase 4/5/6 state). Port `/dev/cu.usbmodem1101`.
  The unrelated ESP32-P4 was not present/never touched.
- **Build:** `idf.py -DSDKCONFIG_DEFAULTS="sdkconfig.defaults;sdkconfig.defaults.sim-mfm384" build`
  in the IDF v5.5.4 container — clean. `build/rak3112_rs485_node.bin` 297712 B (app partition 72% free).
  Placeholder OTAA creds (no `lora_credentials.h` → `__has_include` falls back to the committed
  `.example`, all-zero). Throwaway bench build — NOT tagged.
- **Flash:** host `esptool` v5.2.0, `write_flash` 0x0/0x8000/0x10000 — `--after hard_reset`,
  **no `erase_flash` / `eraseAll:false`** (§3 #1 gate honored). All 3 regions "Hash of data verified".
- **Boot evidence (115200, USB-Serial-JTAG):** `esp_psram: SPI SRAM memory test OK` + `Adding pool of
  8192K of PSRAM`; app `rak3112_rs485_node`, ESP-IDF v5.5.4, compile time `Jun 30 2026 11:23:08`;
  `lora: SX1262 up (AS923, TCXO, DIO2 RF-switch)`; `main_task: Calling app_main()`.
- **FINDING — sim telemetry is join-gated:** with placeholder all-zero creds the OTAA join fails
  (`join failed (-1116)`) on all 5 attempts; `app_main` (app_main.c:263-267) then logs
  `OTAA join failed after retries — halting` and idles forever. `run_field_app()` — the only caller of
  `meter_sim_mfm384()` (the synthesized 230V/5kW/50Hz/0.95PF dataset) — is reached **only after a
  successful join** (comment: "Assumes lora is already joined"). So the simulated MFM384 telemetry
  cannot be observed on a bench without real creds + a gateway in range + ChirpStack registration. The
  sim-mfm384 leg itself is already proven end-to-end (§6 Phase 6: ChirpStack fCnt 440, `simulated:true`).
- **Disposition:** build/flash/boot/monitor pipeline **PASS**; live sim-data observation deferred (no
  creds/gateway on this bench, by operator decision "stop here — pipeline proven"). No `erase_flash`
  issued; no secrets entered the tree.

## Phase 7 provisioning console (2026-06-30)

**Context:** CRM Phase 2 de-risk spike (02-01). Adds a USB-Serial-JTAG REPL console to the
firmware so that the WebSerial flasher (plan 02-08) can inject per-device OTAA credentials
and Modbus config into NVS after flashing the binary.

### What was implemented

- `firmware/main/prov_console.cpp` + `.h`: `esp_console` REPL, prompt `"esp> "`, commands:
  - `prov modbus <baud> <parity> <stopBits> <slaveId>` → NVS ns:`"modbus"` keys `modbus_baud/parity/stop/slave`
  - `prov creds <devEui> <joinEui> <appKey>` → NVS ns:`"lorawan"` keys `lorawan_deveui/joineui/appkey`
  - `prov show` → prints all NVS state; **appKey ALWAYS redacted** (T-02-02)
- `lora.cpp` patched: `lora_join()` reads `lorawan_deveui/joineui/appkey` from NVS first;
  falls back to compiled `lora_credentials.h` placeholder. Logs `[creds:NVS]` when from NVS.
- `app_main.c` patched: reads `modbus_baud/parity/stop/slave` from NVS (`"modbus"` ns) at boot;
  logs `[modbus]` boot marker; calls `prov_console_init()` after `lora_init()`.
- Tag: **`phase-7-provisioning-green`** (commit `c687aa7`)

### Build record (2026-06-30)

| Item | Value |
|---|---|
| Toolchain | `espressif/idf:v5.5.4` (Docker, no local IDF) |
| Target | `esp32s3` |
| Binary | `firmware/build/rak3112_rs485_node.bin` |
| Binary size | 0x58110 bytes (357 kB; 66% of app partition free) |
| Build exit | 0 (PASS) |
| gitleaks | Unavailable in this environment — manual secret scan: CLEAN |
| Secrets in tree | None — appKey injected at runtime into NVS |

**A1 RESOLVED — flash offset: `0x10000`** (app-only binary; from `firmware/build/flasher_args.json`).
The firmware service ships `rak3112_rs485_node.bin` which is the app binary only (not a merged
bootloader+ptable+app). Flash it at offset `0x10000`. Bootloader at `0x0` and partition table
at `0x8000` remain untouched.

### Boot-verify markers (post-provisioning boot)

The WebSerial flasher reads the boot log for these three strings to confirm successful provisioning:

| Marker | Source | Condition |
|---|---|---|
| `[creds:NVS]` | `lora.cpp` | NVS contains valid devEui + joinEui + appKey (16+16+32 hex) |
| `PSRAM` | ESP-IDF bootloader | Always present on ESP32-S3R8 (`Found 8MB PSRAM device`) |
| `modbus` | `app_main.c` | Always present (`[modbus] NVS:` or `[modbus] compiled defaults:`) |

### Cluster image rebuild (OPERATOR GATE — deferred)

The firmware-service Docker image must be rebuilt to bake the `phase-7-provisioning-green` binary.
This requires registry access and cluster rollout — deferred to the operator.

```bash
# On the build machine (parent repo root):
rsync -avz --exclude='.git' --exclude='node_modules' --exclude='data' \
  ~/southern-iot/ root@10.10.8.140:/root/southern-iot/

# On VM or CI — rebuild with new FIRMWARE_TAG:
ssh siot-new "cd /root/southern-iot && \
  docker compose build --no-cache firmware-service && \
  docker compose up -d --force-recreate firmware-service"

# Verify (replace TOKEN with real API token):
curl -H "Authorization: Bearer TOKEN" \
  http://10.10.8.171:30060/v1/builds/phase-7-provisioning-green
# Expected: HTTP 200 with non-empty binaryUrl and binarySha256
# (if build-at-image-time was successful)
```

**k8s cluster deploy:**
```bash
# Update firmware-service-env secret with new FIRMWARE_TAG:
kubectl patch secret firmware-service-env -n firmware \
  --type='json' -p='[{"op":"replace","path":"/data/FIRMWARE_TAG","value":"'$(echo -n 'phase-7-provisioning-green' | base64)'"}]'
kubectl rollout restart deployment/firmware-service -n firmware
kubectl rollout status deployment/firmware-service -n firmware
```

---

## Phase 7 spike findings — HARDWARE VALIDATED (CLI, 2026-07-01)

Validated on the project RAK3112 (MAC `3c:dc:75:6f:85:dc`, Guardrail §3 #1 board-confirm:
ESP32-S3 QFN56 rev v0.2, 8 MB PSRAM) via **esptool + pyserial CLI** — not the Chrome
esptool-js spike. Flash: `esptool write_flash 0x10000 rak3112_rs485_node.bin` (app-only,
**NO erase** — NVS preserved, `eraseAll:false` honored); hash verified.

**Hardware results:**
- prov console live — `help` lists `help` + `prov` (modbus|creds|show).
- `prov creds 3CDC75FFFE6F85DC 0000000000000000 <appKey>` → `OK ... appKey=<redacted 32 hex>`.
- `prov show` → devEui set, `appKey: <redacted>` (never echoed — T-02-02 holds on-device).
- Reboot boot log: **`[creds:NVS] DevEUI=3cdc75fffe6f85dc JoinEUI=0000…`**, `PSRAM 8192K`,
  `[modbus] compiled defaults`, `prov console ready` → lora.cpp NVS-first boot PROVEN.
- OTAA join with NVS creds → `join failed (-1116)` — expected on bench (test appKey not
  registered in ChirpStack, no gateway).
- **NOTE:** built binary `git describe` = `phase-6-modbus-green-16-g226d50` (build predated the
  phase-7 tag) — functionally phase-7 (prov console present). Gate A firmware-service rebuild
  MUST build FROM the `phase-7-provisioning-green` tag so version + served artifact match.

02-08 (WebSerial flasher) reads these values. Browser-specific items (A2 esptool-js API,
A5 Chrome SerialPort survival) still need in-Chrome confirmation.

### Gate A — firmware-service cluster rebuild: CLOSED (2026-07-01)

Rebuilt the in-cluster firmware-service image FROM the `phase-7-provisioning-green` tag
(detached checkout `c687aa7`; `firmware/` proven byte-identical to `main` HEAD via
`git diff --stat tag..HEAD -- firmware/` = empty, so the served `.bin` is the same
artifact hardware-validated above). Built `linux/amd64` via `docker buildx --push` →
`fahim0173/rak3112-firmware-service:phase-7-provisioning-green` (index
`sha256:dafa1eed57a97474d7b92546b730ecad25a35001c0b530335f5711ebe1ab7c6e`, amd64 manifest
`sha256:c61e119304c561fc78e6ce2b484ddaadf44e5dd8ca3a868f30b756cf4650c1a8`). NOTE: the
Dockerfile `COPY firmware/ …` brings no `.git`, so the earlier `git describe` concern is
moot for the artifact — the build-arg `FIRMWARE_TAG` + k8s secret set the reported tag.

Rolled out in ns `firmware` (entry `root@10.10.8.168`; legacy VM 10.10.8.140 untouched):
patched secret `firmware-service-env` `FIRMWARE_TAG`→phase-7, `kubectl set image`→phase-7,
`rollout status` clean (maxUnavailable:0). New pod `firmware-service-c58884cd7-xp2rt`.

Verified in-pod (`kubectl exec -i … -- python -`; `API_TOKEN` never left the pod):
`POST /v1/build`→200 warmed the MinIO cache; `GET /v1/builds/phase-7-provisioning-green`→200
`status:ready`, served-binary **SHA-256
`8dcedba85093d37d3be88072d2cb296ce8126dbe71d0cb0cf7fc1ac0c951d47b`**, presigned `binaryUrl`
via external MinIO NodePort `10.10.8.171:30900` (browser-reachable for the 02-08 flasher).
Regression: `/v1/sensors` = 4 sensors / 2 flashable (mfm384, rsfsjt), unchanged from phase-6.

02-01 is now fully complete (code + hardware + Gate A). 02-08 can pull the served phase-7 binary.

### A1 — Flash offset: RESOLVED

| | |
|---|---|
| **Value** | `0x10000` |
| **Source** | `firmware/build/flasher_args.json` (app offset from ESP-IDF build) |
| **Type** | App-only binary (no merged bootloader) |
| **Implication** | `FlashOptions.fileArray[0].address = 0x10000` |

### A2 — MAC read call in esptool-js 0.6.0: PARTIAL (chip MAC readable via CLI; esptool-js API pending 02-08)
CLI `esptool read-mac` returns `3c:dc:75:6f:85:dc` (EUI-48, colon-hex). Capability proven; the exact
esptool-js browser call (`chip.readMac` vs `readMac`) still needs in-Chrome confirmation in 02-08.

| | |
|---|---|
| **Status** | UNRESOLVED — requires Chrome + RAK3112 |
| **Question** | Exact API to read EUI-48 MAC from ESPLoader after `.main()` |
| **Proposed** | `esploader.chip.readMac(esploader)` — most likely; spike probes both `chip.readMac()` and `esploader.readMac()` |
| **Probe** | `spike.mjs` tries both calls, logs `[A2-PROBE]` output — record which succeeded |
| **Record here** | MAC read call: `_____________` Return type: `_____________` Format: `_____________` |

### A3 — Line terminator for prov commands: RESOLVED = `\r\n`
Commands accepted with `\r\n` over USB-Serial-JTAG; `prov show`/`prov creds` echoed + acted.

| | |
|---|---|
| **Status** | UNRESOLVED — requires hardware echo |
| **Question** | Does `esp_console` accept `\r\n` or `\n`? |
| **Proposed** | `\r\n` (standard VT100 terminal; spike uses `\r\n` first — `[A3-PROBE]`) |
| **Record here** | Working terminator: `_____________` (if commands ignored, change to `\n`) |

### A4 — Reboot command vs RTS pulse: RESOLVED = NO console reboot cmd → reset line / physical
CORRECTION to the proposed answer: `restart` is NOT registered (`help` shows only `help` + `prov`);
`restart` → "Unrecognized command". The flasher MUST reboot via `port.setSignals()` (DTR/RTS → EN
pulse, as esptool does) or physical RST. There is no `esp_restart` console command either.

| | |
|---|---|
| **Status** | UNRESOLVED — requires hardware test |
| **Question** | Does `esp_console` have a `restart` command? Or should boot-verify use RTS? |
| **Proposed** | `restart` built-in command (ESP-IDF console registers it by default); spike tries `restart` then `esp_restart` |
| **Record here** | Working reboot mechanism: `_____________` |

### A5 — Port re-enumeration after reset: CONFIRMED (USB-JTAG re-enumerates; Chrome SerialPort survival pending 02-08)
On reset the USB-Serial-JTAG device drops + re-adds — an already-open handle goes deaf (a monitor
had to reopen the port to catch the boot log; port timestamp changed). So after reboot the flasher
MUST reacquire the port. Whether Chrome's `SerialPort` object survives (`port.open()`) or needs
`navigator.serial.getPorts()` re-select is the remaining browser-specific detail for 02-08.

| | |
|---|---|
| **Status** | UNRESOLVED — requires macOS + Chrome + USB |
| **Question** | After `hard_reset`, can original `SerialPort` be re-opened with `port.open()`, or must `navigator.serial.getPorts()` re-select? |
| **Proposed** | `port.open()` on original object survives re-enumeration on macOS (spike tests `[A5-PROBE]`, falls back to `getPorts()`) |
| **Record here** | Working path: `getPorts()` re-select (0x1001) after re-enum; open succeeds. Delay: ~500 ms after re-enum |

### A1–A5 + console read-back: FULLY RESOLVED in-browser (WebSerial spike, 2026-07-01)

Confirmed on the project RAK3112 (`3c:dc:75:6f:85:dc`) via the `tools/webserial-spike` page in
Chrome against a local mock firmware-service (served the phase-7 `.bin` + `/v1` endpoints on
`localhost`, same origin → Web Serial secure context, no cluster/token needed).

| # | Value (resolved) |
|---|---|
| **A1** flash offset | `0x10000`, `eraseAll:false`, SHA-256 verified before write (205 KB compressed, ~2.9 s) |
| **A2** MAC read | `await esploader.chip.readMac(esploader)` → **colon-hex string** `"3c:dc:75:6f:85:dc"` (NOT an array) |
| **A3** line terminator | `\r\n` — `prov show`/`prov creds` accepted |
| **A4** reboot | **No console reboot command.** Reset via `port.setSignals()` RTS-pulse (below) |
| **A5** re-enumeration | USB-JTAG drops+re-adds on reset; `navigator.serial.getPorts()` re-selects the granted PID `0x1001` port; `port.open()` on it succeeds |

**THE KEY FINDING — reset-first, every phase (never leave the board latched).** A bare read of a
reopened WebSerial port returns **0 bytes** (the CDC console is silent when the board is latched /
DTR deasserted). Four attempts failed until the board was reset *in-session* first. Proven recipe:

```js
// after port.open({baudRate:115200}) and reader = port.readable.getReader():
await port.setSignals({ requestToSend: true,  dataTerminalReady: false }); // EN low  = reset asserted
await sleep(150);
await port.setSignals({ requestToSend: false, dataTerminalReady: false }); // release EN -> boot
await sleep(50);
await port.setSignals({ dataTerminalReady: true, requestToSend: false });  // DTR asserted = terminal present
// now the boot log flows: [creds:NVS] DevEUI=..., "Found 8MB PSRAM", modbus, "provisioning console ready", "esp> "
// send commands with \r\n AFTER the console-ready line; the REPL answers prov show (NVS state).
```

- Attach the **reader before** the reset so the earliest boot lines (`[creds:NVS]`) are captured.
- Wait for `provisioning console ready` before sending `prov *` (the app fires LoRa join at boot; give the REPL a ~800 ms settle).
- CLI cross-check (pyserial): `dtr=True,rts=False` + a real command reads; opening with `dtr=False` triggers a reset. Same DTR/EN semantics as the WebSerial `setSignals` recipe.
- **esptool-js is fine** — flash + `readMac` worked from the first run; the blocker was raw WebSerial signal handling (outside esptool-js). No need for esp-web-tools.

02-08 NVS phase design: flash → (esptool `hard_reset`) → `getPorts()` re-acquire → **reset-first setSignals** → read boot log for verify markers → send `prov modbus`/`prov creds` → reset again → read boot log for `[creds:NVS]` with the new DevEUI (boot-verify).

### Spike validation checklist (complete on hardware)

- [x] Board MAC matches expected (`3c:dc:75:6f:85:dc`) — T-02-04
- [x] Flash at 0x10000 completes, `eraseAll:false` confirmed — T-02-01 (esptool write_flash, no erase)
- [x] Device boots after flash (not bricked, no erase_flash issued)
- [x] `prov creds` accepted (appKey not echoed) — T-02-02  · [ ] `prov modbus` NOT exercised (creds path only)
- [x] `prov show` prints devEui + `<redacted>` for appKey
- [x] Boot log after reboot contains `[creds:NVS]` + `PSRAM` + `modbus`
- [x] A2, A3, A4, A5 values recorded above (A2/A5 browser-API detail deferred to 02-08)
- [x] No secrets leaked in serial output (appKey redacted in `prov creds` OK + `prov show`) — browser DevTools check is 02-08

---

## Post-sign-off note — ADR-001 `<TBD>` hygiene (2026-06-20)

After Phase 2 sign-off, a code-review pass found a residual `<TBD>` placeholder in the
signed-off `ADR-001-pin-map.md`: a **duplicate** "## H1 header purpose (EC-5b)" stub still
showing `> Status: <TBD> — pending EC-5 execution` directly below the canonical, fully-resolved
EC-5b section. The firmware EC-9 precondition required the ADR be "free of `<TBD>` markers", so
this was a technical violation rolled forward from the sign-off commit.

Fixed in hardware repo `main` (merge `3cce0c6`, fix `65ddab0`) — the duplicate stub was removed;
the binding decision (H1 = 3V3-enable / current-measurement jumper) was unchanged and already
present in the canonical section. The `adr-001-locked` tag was **not** moved (it is pushed; the
decision did not change), so the firmware `HARDWARE_REV.md` pin (`a0b002ca…8295`) remains valid.
No firmware behavior is affected.

## Phase 2 attempts

### EC-1 — 2026-05-01 — PASS (vendored IAD only; PARLIO held back)

**Patch dispositions per rev5 §5 EC-1:**

| Patch | Disposition | Rationale |
|---|---|---|
| `usb_types_ch9.h` (`USB_IAD_DESC_SIZE` 9 → 8) | **Vendored** as `firmware/esp-idf-patches/0001-fix-iad-desc-size.patch` | Verifiable correct against USB 2.0 ECN "Interface Association Descriptors" (May 2003). v5.5.4 + release/v5.5 branch tip both ship `9`; ESP-IDF master has refactored away from this path so the bug is implicitly fixed there. No upstream PR exists. |
| `esp_lcd_panel_io_parl.c` (`sample_edge` POS → NEG) | **Not vendored.** Stays in `~/esp/esp-idf-v5.5.4/` as personal modification | Author intent could not be recovered (neither chat-side nor user-side instance has access to the operator's keystroke memory; no commit on the local IDF tree captures the rationale). Per rev5 EC-1: "If intent cannot be determined, the patch is NOT vendored." Plausibility of the change does not satisfy the rule. |

**Plausible-but-undocumented theory for the PARLIO mod (recorded as theory, not as confirmed reason):**

- v5.5.4 default: `.sample_edge = PARLIO_SAMPLE_EDGE_POS`
- ESP-IDF master: field renamed to `shift_edge` with `PARLIO_SHIFT_EDGE_NEG` as the default
- The local mod's POS → NEG flip aligns with master's default behaviour
- This *suggests* the mod was a real fix, but the contract requires documented author intent — alignment with master is post-hoc reasoning, not provenance

**Asymmetric outcome accepted (Footnote 1):**

- Local builds on `siot-dev-m5` will produce `v5.5.4-dirty` (PARLIO mod still present in `~/esp/esp-idf-v5.5.4/` working tree, off-compile-path for this firmware).
- CI builds (clean clone + `apply-patches.sh`) will produce clean `v5.5.4` with IAD patch applied.
- §3 #6 single-canonical-build-path invariant **NOT violated**: same ESP-IDF version, same target, same `sdkconfig.defaults`, only an extra incidental working-tree mod on local that doesn't affect the heartbeat compile path.

**EC-1 fresh-clone verification (per the rev5 verification routine):**

| Step | Result |
|---|---|
| `git clone --depth 1 --branch v5.5.4 espressif/esp-idf` | OK |
| `git submodule update --init --recursive --depth 1` | OK |
| Pre-patch sanity grep | `#define USB_IAD_DESC_SIZE 9` ← upstream wrong |
| `apply-patches.sh` (IDF_PATH = temp clone) | `Applied: 0001-fix-iad-desc-size.patch` |
| Post-patch sanity grep | `#define USB_IAD_DESC_SIZE 8` ← corrected |
| `idf.py build` (output to `firmware/build-verify/`) | `Project build complete.` |
| Cleanup of temp ESP-IDF clone + `build-verify/` | OK |
| Phase 1 baseline `firmware/build/` | preserved untouched |

**Build-timestamp finding (worth flagging in advance for Phase 5+):**

- Phase 1 baseline binary SHA-256: `a2f3d6044f9458aa38a492cad531c53071b2f829a33f5fd2635db72271fe5116` (built against pristine v5.5.4, no IAD patch)
- Phase 2 EC-1 verification binary SHA-256: `d47500e3906766219cd466a475d85f18bdd6fd056386cfa3a4e568d35cb4b7a7` (built against pristine v5.5.4 + IAD patch)
- The SHAs differ even though the IAD constant is off-compile-path for the heartbeat (no USB host stack, no `usb_iad_desc_t` instantiation, no `static_assert` activation).
- Cause: ESP-IDF embeds build timestamps + source-path strings in the app descriptor and debug info. Without `CONFIG_APP_REPRODUCIBLE_BUILD=y` enabled, every rebuild has a different timestamp by design.
- **Implication for §3 #6 reproducibility guarantee:** the contract wording "functionally identical (modulo embedded timestamp / git-describe strings)" is exactly on point — timestamp is the `modulo`. SHA inequality between rebuilds at different wall-clock times is expected and does not violate the invariant.
- **Phase 5+ consideration:** if byte-identical builds become valuable (e.g., for over-the-air update integrity, or for reproducible-build CI verification), enable `CONFIG_APP_REPRODUCIBLE_BUILD=y` then. Not enabling now keeps timestamps useful for forensic correlation.

**Deferred task — file upstream PR for IAD fix.**

The `0001-fix-iad-desc-size.patch` is a verifiable bug fix in ESP-IDF's `release/v5.5` branch. Worth filing upstream as a PR against `espressif/esp-idf`'s `release/v5.5` branch. Not blocking for Phase 2 / hardware-side work. Logged here; will be moved into `ADR-001-pin-map.md` appendix when that doc exists, or stay here as a "deferred upstream contributions" entry.

Suggested PR title: `fix(usb): USB_IAD_DESC_SIZE is 8 bytes per USB 2.0 ECN, not 9 (release/v5.5)`

---

## Phase 1 attempts

### Attempt 2 — 2026-05-01 — FAIL on smoke-gate step 3 (PlatformIO + ESP-IDF version mismatch)

**Branch:** `fix/p1-pio-srcdir`. P1-FIX-1 (src_dir fix + gate-execution discipline) committed and applied.

**Smoke-gate trail.**

| Step | Status | Evidence |
|---|---|---|
| 1. `pre-commit run --all-files` | ✅ PASS | All 6 hooks Passed |
| 2. `idf.py build` (ESP-IDF v5.5.4 pristine) | ✅ PASS | Ninja near-no-op rebuild; `firmware/build/rak3112_rs485_node.bin` 183 328 bytes — **byte-identical to Attempt 1**, confirming pristine-v5.5.4 reproducibility |
| 3. `pio run -e esp32-s3-devkitc-1` (bare, no pipes) | ❌ **FAIL** | Exit 1 after 2.36 s. `CMake Error at CMakeLists.txt:1 (cmake_minimum_required): CMake 3.20 or higher is required. You are running version 3.16.4` |
| 4. `gitleaks detect --no-banner --redact` | ✅ PASS | 8 commits scanned, 223.7 KB, no leaks |
| 5. layout check | ✅ PASS | `tests/host/CMakeLists.txt` present |

**Root cause analysis — substantive.**

The `[platformio] src_dir = main` fix was correct and worked: PlatformIO this time entered the build phase rather than aborting at the directory check. The new failure surfaced a deeper issue: **the dual-build invariant in §3 #6 has been silently using two different ESP-IDF versions all along.**

| Build path | ESP-IDF version | CMake version |
|---|---|---|
| `idf.py build` (local) | v5.5.4 (system, `~/esp/esp-idf-v5.5.4/`) | system or ESP-IDF-bundled, ≥ 3.20 |
| `pio run` (local) | **v5.2.1 (PlatformIO-bundled in `platform = espressif32 @ ~6.7.0`)** | **3.16.4 (PlatformIO-bundled)** |
| `idf.py` (CI, `espressif/esp-idf-ci-action@v1` pinned to v5.5.4) | v5.5.4 | matched |

Our `firmware/CMakeLists.txt` says `cmake_minimum_required(VERSION 3.20)` because that's the floor mandated by ESP-IDF v5.5.x. PlatformIO's bundled CMake 3.16.4 (matching its bundled ESP-IDF v5.2.1) cannot satisfy this. ESP-IDF v5.5 raised the CMake floor from 3.16 → 3.20 between v5.2 and v5.5.

**This means the rev3 contract's "dual-build invariant" is unfulfillable with the current pin choices.** The two builds were never building the same thing — they shared source but compiled it against materially different ESP-IDF and CMake versions. Phase 1 Attempt 1 happened to pass step 2 and *fail at step 3 for an unrelated reason*; if the src_dir issue hadn't masked it, this CMake-version mismatch would have surfaced anyway in any subsequent attempt.

**Strategic options (require user decision — not auto-applicable):**

1. **Bump platform-espressif32 pin to a version that bundles ESP-IDF v5.5+.** As of this date, mainline platform-espressif32 ≤ 6.10.x bundles v5.4.x at best; v5.5 may require the Pioarduino community fork (`platform = https://github.com/pioarduino/platform-espressif32.git`) or waiting for upstream. If a release exists that bundles v5.5.x, pin to it and re-run; otherwise (3) below.

2. **Lower the contract's ESP-IDF pin to v5.3.x or v5.4.x to match what PlatformIO can offer.** Forfeits being on the latest stable, but preserves the dual-build invariant.

3. **Drop PlatformIO from the local smoke-gate.** Use `idf.py` only locally; PlatformIO retained for CI **only** with whatever ESP-IDF version platform-espressif32 currently bundles, treating PIO as a separate "smoke build" job rather than a dual-build mirror. Downgrades the dual-build invariant from "byte-equivalent" to "both-frameworks-compile". This is the path of least resistance and matches what most ESP-IDF + PIO projects do in practice.

4. **Replace PlatformIO entirely** with a docker-pinned ESP-IDF v5.5.4 image for CI parity. Cleanest for reproducibility but adds a dependency.

**Recovery state.**

- ESP-IDF stash restored: `git stash pop` clean apply, two expected files modified, `idf.py --version` back to `v5.5.4-dirty`. Shared `~/esp/esp-idf-v5.5.4/` is unperturbed.
- Repo on branch `fix/p1-pio-srcdir`, P1-FIX-1 committed (src_dir fix + gate-execution discipline + audit). No tag.
- ESP-IDF Attempt-2 build artefacts in `firmware/build/` (byte-identical to Attempt 1 — 183 328 bytes, IDF_VER=v5.5.4 clean).
- PlatformIO partial state in `firmware/.pio/` (no firmware.bin produced).

**Action plan (awaiting user direction on options 1–4 above).** No further work on this branch until the strategic choice is made. The platformio.ini / CLAUDE.md edits in P1-FIX-1 remain valid regardless of which option is chosen — they were a real fix, just not the only one needed.

**Full PIO log:** `/tmp/p1-attempt2-pio.log`. ESP-IDF log: `/tmp/p1-attempt2-idf.log`.

---

### Attempt 1 — 2026-05-01 — FAIL on smoke-gate step 3 (PlatformIO build)

**Smoke-gate trail.**

| Step | Status | Evidence |
|---|---|---|
| 1. `pre-commit run --all-files` | ✅ PASS | All 6 hooks Passed (end-of-file-fixer, trailing-whitespace, check-yaml [multi-doc], check-merge-conflict, gitleaks, clang-format) |
| 2. `idf.py build` (ESP-IDF v5.5.4 pristine via stash) | ✅ PASS | `Project build complete.` · binary `firmware/build/rak3112_rs485_node.bin` 183 328 bytes · `IDF_VER` baked in = `v5.5.4` (no `-dirty`) · bootloader 36% free · app partition 83% free |
| 3. `pio run -e esp32-s3-devkitc-1` | ❌ **FAIL** | Exit `[FAILED]` after 303.43 s. PlatformIO downloaded espressif32 platform + bundled `~/.platformio/penv/.espidf-5.2.1/` toolchain successfully, then errored with: `Error: Missing the 'src' folder with project sources.` No `firmware.bin` produced. |
| 4. `gitleaks detect` | ✅ PASS | 6 commits scanned, 217.7 KB, no leaks |
| 5. layout check | ✅ PASS | `tests/host/CMakeLists.txt` present |

**Root cause analysis.**

PlatformIO `framework = espidf` defaults to expecting source code under `src/` (PlatformIO convention) but the ESP-IDF native layout uses `main/` (with `idf_component_register` in `main/CMakeLists.txt`). PlatformIO's espidf framework supports both, but only when explicitly told that `main/` is the source dir. Without `src_dir = main`, PlatformIO falls back to looking for `src/` and aborts.

Note: the bash invocation `pio run … | tee … | tail -3` masked the failure exit code because `tee` succeeded. This is **also a smoke-gate definition issue** — the gate must check `pio run`'s real exit code, not tee's. To be addressed in the fix.

**Proposed fix (one line in `firmware/platformio.ini`):**
```ini
[platformio]
src_dir = main

[env:esp32-s3-devkitc-1]
platform = espressif32 @ ~6.7.0
framework = espidf
... (unchanged)
```

The `[platformio] src_dir = main` line redirects PlatformIO's source-directory expectation onto the ESP-IDF `main/` directory, while ESP-IDF's own CMake build still finds `main/` via `idf_component_register`. Both build systems then operate against the same source tree as intended by §1's "single source of truth" + §3 #6 dual-build invariant.

Smoke-gate command also needs hardening: capture `pio run`'s exit code directly (no `tee` between command and gate decision).

**Recovery state.**

- ESP-IDF stash restored: `git stash pop` clean apply, two expected files modified, `idf.py --version` back to `v5.5.4-dirty` baseline. Shared `~/esp/esp-idf-v5.5.4/` is unperturbed.
- `~/Developer/projects/firmware/rak3112-rs485-node/` 6 commits on `main`, no `phase-1-scaffold-green` tag (gate did not pass).
- ESP-IDF build artefacts in `firmware/build/` retained for forensic reference; PlatformIO partial build in `firmware/.pio/build/esp32-s3-devkitc-1/` (no firmware.bin).

**Action plan (awaiting user approval).**

1. Create `fix/p1-pio-srcdir` branch off `main`.
2. Apply the `src_dir = main` fix to `platformio.ini`.
3. Harden the smoke-gate command in `CLAUDE.md` to not rely on tee.
4. Re-run from the pre-scaffold isolation step (re-stash ESP-IDF patches), execute full smoke gate.
5. If green, merge `fix/p1-pio-srcdir` back to `main`, tag `phase-1-scaffold-green`.

**Full PlatformIO log:** `/tmp/p1-pio-build.log` (303.43 s, 7 MB). Will be moved into the repo as `docs/logs/p1-attempt1-pio.log` if the user wants it durable; not committed by default.

---

## Gate design principles (2026-05-01, lesson from Phase 1 Attempt 1)

Smoke-gate commands MUST have unambiguous exit codes.

- ❌ **NEVER** pipe gate commands through `tee` / `tail` / `head` / `grep` / `awk` / `sed`. Pipes mask the upstream exit code unless explicit `set -o pipefail` + `${PIPESTATUS[@]}` handling is used. Even then, the cognitive overhead defeats the purpose of a "smoke gate".
- ✅ Run gate commands **bare**. Exit code is the gate.
- ✅ If forensic logging is needed, capture it **outside** the gate, in the on-failure procedure below. Not every run needs a log on disk; failures do, and those are captured deliberately.

**Audit (2026-05-01):** The contract `CLAUDE.md` smoke-gate definitions in §5 were already pipe-clean. The masking in Attempt 1 came from the **operator** wrapping `pio run` in `… | tee /tmp/p1-pio-build.log | tail -3` at execution time to keep chat output short. Lesson: the contract is sound by construction, but operator discipline at runtime is the second line of defence — and it was the line that failed. Codified as Guardrail §3 #9 in `CLAUDE.md` rev3+.

### On-failure forensic-capture procedure

When a gate fails:
1. Capture the offending command's output deliberately, with timestamp:
   ```bash
   <gate-command> 2>&1 | tee /tmp/p<phase>-<step>-$(date +%s).log
   ```
2. Tail the relevant section into the RUNBOOK attempt entry as evidence.
3. Optionally promote the full log into `docs/logs/` if the failure mode is novel and worth durable retention.

This is the *only* place where pipes are sanctioned, and only after the gate has already failed.

---

## Pin discipline (2026-05-01, lesson from Phase 1 Attempt 2)

**When pinning two toolchains that must agree on a downstream property** (version, CMake floor, compiler version, std lib), **the pins are not independent.** Verify the agreement at pin time, not at build time.

❌ **Anti-example.** Rev3 of this contract pinned:

```
ESP-IDF                         v5.5.4
PlatformIO platform-espressif32 ~6.7.0    # bundles ESP-IDF v5.2.1 + CMake 3.16
```

Each pin was locally valid (real, released versions). They were **jointly inconsistent**: ESP-IDF v5.5 raised the CMake floor to 3.20, but PlatformIO's bundled CMake was 3.16. The mismatch was invisible until the second build path actually ran. Phase 1 Attempt 2 surfaced it; Attempt 1 only avoided it because PIO failed earlier on `src_dir`.

✅ **Rule.** Any time a contract pins two tools that share a transitive dependency, **document the shared dep explicitly** and **verify agreement at the pin-introduction commit**, not at first build. Concretely, the rev3 review should have included a step like:

```bash
# Cross-pin sanity: do both build paths agree on CMake floor?
grep cmake_minimum_required firmware/CMakeLists.txt
# -> 3.20 (because ESP-IDF v5.5)
# Does platform-espressif32 ~6.7.0 ship CMake >= 3.20?
# -> No. ~6.7.0 ships v5.2.1 + CMake 3.16. Pin REJECTED.
```

The rule generalises beyond ESP-IDF/PlatformIO. It applies to: Python + pip-tools, Node + pnpm, Docker base images + bundled language runtimes, Yocto + meta-layers, anything where two pins resolve a shared transitive dependency.

**Reference incident:** Phase 1 Attempt 2, 2026-05-01. Resolution: PlatformIO dropped entirely (rev4); single canonical build path = ESP-IDF.

**Self-critique recorded for the next review:** the chat-side Claude that approved rev2/rev3 toolchain pins checked each pin individually, not jointly. Same blind spot the operator (Arif) flagged on themselves. Codified here so the next review surface adopts the joint-consistency check.

---

## Aesthetic vs. functional preference (2026-05-01, lessons from rev3 R3, rev5 push-back 1, and SHA-truncation pattern)

When a review choice reduces to **"less visible state vs. more visible state"**, default to MORE visible state if the visible state is functionally correct.

- Empty-but-tagged remote > drafting in temporary location
- Logged §15 entry > argument from chat-side memory
- Verbose State block with all attempts > squashed-clean tag
- Full SHA in tag annotations and reports > truncated SHA "for readability"

Aesthetic preferences for "clean" or "minimal" should not override functional reasons for explicit state. The visible state is the durable forensic record. **The cost of verbosity is real but bounded; the cost of erased state is unbounded.**

**Reference incidents:**

- **Phase 1 review rev3 R3 (gateway IP, memory vs. §15).** Operator argued for replacing the dated `192.168.20.150` (per global CLAUDE.md §11+§15) with `192.168.15.150` based on a memory snippet. Resolution: the dated State block §15 entry is authoritative; memory snippets that contradict logged state are wrong by default. Aesthetic argument: "single IP claim feels cleaner than relocation history". Functional cost: writing wrong infrastructure into a production-grade contract.
- **Phase 2 review rev5 push-back 1 (hardware repo timing).** Operator initially preferred deferring hardware-repo creation to Phase 2 *exit* ("avoid empty remote during research work"). Resolution: hardware repo at Phase 2 *entry*, with V1.0 archive tag. Aesthetic argument: "empty remote feels untidy". Functional cost: drafting ADR-001 in the wrong repo, then migrating at exit — a copy-paste boundary that violates single-canonical-source.
- **Throughout Phase 1 reports (SHA truncation).** Chat-side Claude truncated `a2f3d6044f9458aa38a492cad531c53071b2f829a33f5fd2635db72271fe5116` to `a2f3d604…fe5116` in chat reports "for readability". Caught at near-miss stage — the tag annotation itself had the full hash; only the chat summary was truncated. Aesthetic argument: "shorter is more readable". Functional cost: forensic forward-compatibility (verifying a tag's annotated SHA against the actual binary requires the full hash).

**Promotion candidate.** Like the "single canonical source" lesson, this rule generalises beyond build systems: it applies to any review surface where "tidy" competes with "explicit". Worth promoting from project-RUNBOOK to global CLAUDE.md when the operator next does a global doc-discipline pass. Not actioning the global edit unilaterally — same standing rule as the Phase 1 lesson promotions.

---

## Silicon-vendor abstraction layer (2026-05-01, lesson from Phase 2 EC-6)

**When the two-sources rule comes back silent on a hardware spec, check the silicon vendor's part-number nomenclature / comparison table before deferring.**

Module manufacturers (RAK, Seeed, Adafruit, etc.) frequently underdocument the underlying silicon variant — they specify "8 MB PSRAM" without distinguishing Quad/Octal mode, "ESP32-S3" without enumerating which R-variant. But the silicon vendor (Espressif, Nordic, ST, etc.) enumerates *all* SKUs definitively in their family-level datasheets. **The authoritative source for "what's inside this module" is often one layer of abstraction below the module datasheet.**

❌ **Anti-example.** Phase 2 EC-6 ran the prescribed two-sources-rule:

- RAK3112 datasheet (RAKwireless): "8 MB PSRAM" with no mode disclosure
- `rnd-southerniot/rak3112-dynamic-sensor` (operator's parallel project): `# CONFIG_SPIRAM is not set` (PSRAM disabled, mode never determined)

Both sources silent. The chat-side disposition leaned toward **option C (defer with rev8 amendment)** because "two sources beat one, and two sources unable to confirm = defer." This was wrong — the search hadn't gone deep enough.

✅ **Correct resolution.** Operator went one layer down to the **silicon-vendor datasheet**:

> *Espressif ESP32-S3 Series Datasheet v2.2, §1.2 (Comparison), Table 1-1 (page 13). All 8 MB PSRAM ESP32-S3 variants ship Octal SPI: ESP32-S3R8 (3.3 V, current production) and ESP32-S3R8V (1.8 V, EOL). No 8 MB Quad SKU exists. RAK3112 with "8 MB PSRAM" silicon must be ESP32-S3R8 (current) or ESP32-S3R8V (legacy stock). Either way, mode = Octal.*

The silicon vendor's SKU enumeration eliminated the ambiguity that the module-vendor datasheet preserved. Two RAKwireless-side sources (datasheet + RAK's own reference firmware) couldn't disambiguate. One Espressif-side source did.

✅ **Generalised rule for review surfaces.** When a hardware spec is missing from module-vendor sources:

1. **Identify the silicon underneath** (chip-level: ESP32-S3; module-level: RAK3112 above it).
2. **Check the silicon-vendor's family datasheet** — specifically the part-number-nomenclature / SKU-comparison table. These tables enumerate every variant the vendor sells.
3. **Map the module's published spec** ("8 MB PSRAM") **to the silicon SKU** (ESP32-S3R8 / ESP32-S3R8V — both Octal). If the spec uniquely identifies the silicon, the silicon's properties resolve the question.
4. **If still ambiguous** (e.g., spec matches multiple silicon SKUs that differ on the relevant axis), then defer / reach out to the module vendor.

Module vendors abstract over silicon vendors. When the abstraction layer is opaque on a technical detail, lift it. The silicon vendor's documentation is one layer down but often more comprehensive on technical detail than the module-level layer.

**Reference incident:** Phase 2 EC-6, 2026-05-01. Resolution: PSRAM mode = Octal SPI per ESP32-S3 Series Datasheet v2.2 Table 1-1. Disposition A accepted, no rev8 amendment needed.

**Cross-project applicability.** `rnd-southerniot/rak3112-dynamic-sensor` should also enable Octal PSRAM when its use case requires PSRAM. Same silicon, same answer. Documented here as a shared lesson; that project's CLAUDE.md / sdkconfig update is out of scope for this repo's commits but tracked as a deferred cross-project note.

**Promotion candidate** for global CLAUDE.md when the operator next does a global doc-discipline pass.

---

## Pre-commit hook side-effects on checksums (2026-05-02, lesson from Phase 2 EC-9 pre-flight)

**When a pre-commit hook modifies a file, any checksums computed *before* the hook run are stale.** The committed checksum file ends up referencing the pre-hook bytes; the on-disk file has post-hook bytes; `sha256sum -c CHECKSUMS.txt` fails until someone re-runs the gate.

❌ **Anti-example (hw repo, Phase 2 EC-2 commit `970cdf0`).** Sequence:

1. `shasum -a 256 *.pdf *.epro *.json page-*.png > CHECKSUMS.txt` — captures pre-hook hashes.
2. `git add -A`.
3. `pre-commit run --all-files` → end-of-file-fixer modifies `esch-pin-labels.json` (adds trailing newline).
4. `git add -A` (re-stages the modified JSON; CHECKSUMS.txt unchanged).
5. `git commit` → CHECKSUMS.txt records pre-fixer JSON hash; JSON file has post-fixer bytes.

The EC-2 smoke gate (`sha256sum -c CHECKSUMS.txt`) appeared to pass at commit time because pre-commit ran on a self-consistent staged tree. But the **committed** CHECKSUMS.txt was computed before the eof-fixer modification; the **committed** JSON was modified by the eof-fixer afterwards. Mismatch ran silently from EC-2 (2026-05-01) through EC-7 close (2026-05-02). Detected at Phase 2 EC-9 pre-flight when SHA-256s were re-computed for the `adr-001-locked` tag annotation; fixed by regenerating CHECKSUMS.txt against the post-hook tree and bundling the fix into the sign-off commit.

✅ **Generalised rule.** When a checksum file is committed alongside the files it references, the checksum **must** be computed *after* the pre-commit hook chain has stabilised. Three viable patterns:

- (a) **Manual sequence:** run `pre-commit run --all-files` first, let hooks modify whatever they will, *then* compute checksums on the post-hook tree.
- (b) **CHECKSUMS regeneration as a pre-commit hook:** add a hook that runs after the file-modifying hooks (eof-fixer, trailing-whitespace, formatters) and rewrites CHECKSUMS.txt from the post-hook tree.
- (c) **Self-verification hook:** add a hook that fails the commit if `sha256sum -c CHECKSUMS.txt` doesn't match the staged tree. Forces the operator to regenerate before commit.

For this project, pattern (a) is sufficient at the current scale. Future Phase 3+ work that adds host tests with binary fixtures may benefit from (b) or (c) if checksum drift becomes a recurring failure mode.

**Reference incident:** EC-2 (2026-05-01) committed stale CHECKSUMS.txt for `esch-pin-labels.json`. Detected at EC-9 pre-flight (2026-05-02). No data corruption, no contract violation rolled forward downstream — but the EC-2 gate was technically failing during EC-3..EC-7. Worth a small audit of the EC-3..EC-7 commits if any depended on `sha256sum -c` passing.

**Promotion candidate** for global CLAUDE.md (joining the four prior lessons — five total now).

## CRM WebSerial E2E — provisioning-protocol contract + flash-flow lessons (2026-07-13)

Hit while driving the careflow `rak3212-rs485` (board MAC `3C:DC:75:6F:85:DC`) through the SCOMM CRM UI on VM 141.

**ROOT CAUSE — provisioning-protocol placeholder must match the flasher's context key.** The WebSerial
flasher (`scomm-web-prod`) renders each protocol command by `syntax.replace(/<(\w+)>/g, (_,name)=>ctx[name])`
against a camelCase context map `{devEui, joinEui, appKey, baud, parity, stopBits, slaveId, blobHex}` (devEui
← board boot log; joinEui/appKey ← mint; baud/… ← sensor modbus cfg; **blobHex ← `profile-blob …?taskId&nodeId`
`.blobHex`**). `_CMD_PROFILE` in `api/routers/builds.py` advertised `prov-profile <hexblob>` (C6 change), but
`hexblob` ≠ `blobHex` → `renderProvisioningCommands: no context value for <hexblob>` → **every careflow flash
failed**. Every other placeholder already matched. **Fix = `<hexblob>`→`<blobHex>`** in all 3 copies (this
repo `api/`, `siot-node-firmware-automation`, deployed hub `siot-firmware-automation` PR #8). Lesson: the
`<placeholder>` names inside `syntax` are a HARD CRM↔hub contract — mirror the flasher's keys exactly. This
was contract drift exposed when the CRM was rebuilt on VM 141.

**Flash-flow traps (all CRM/flasher UX, not firmware):**
- **Editing a product recreates its productNode with a new id** → orphans an open flash page (profile-blob/
  protocol 404 → hexblob error). Configure profiles before flashing; **hard-reload after any product edit**.
- **A FAILED flash blocks retry via the D-14 over-flash gate** — the `device_provisionings` row
  (`nvsStatus=FAILED`, no `devEui`) still counts against `expected N = hardware_procurements.quantity`. Delete
  the failed row to retry. (CRM bug: a FAILED provisioning should not count / Re-run should reuse it.)
- **A "deleted device that reappears" in the flash modal = stale client-side modal state**, not a backend/
  contract bug (`GET /provisioning/task/<id>/devices` is the source of truth). Reload clears it.
- **WebSerial needs Chrome/Edge + a secure context** — `ssh -L 8090:localhost:8090 siot-ops` → open
  `http://localhost:8090`; the raw IP `:8090` is an insecure context and is blocked even in Chrome.

**Decode + fan-out verified independently:** deployed ChirpStack fleet codec decodes RS-FSJT `0102000028` →
`{device:"RS-FSJT-N01", wind:0.4}`; Node-RED → InfluxDB + HA-discovery + Mattermost are wired and client-scoped
off ChirpStack `tenantName` (per-client tenant; gateway tenant `52f14cd4` non-private → shared gateway serves
cross-tenant joins).
