rnd-southerniot/rak3112-rs485-node/docs/adr/ADR-006-profile-driven-runtime.md

# ADR-006 — Profile-driven runtime (generic Modbus reader + scan-for-ID)

- **Status:** Proposed (increments 1–4 done; **3 + 4 HW-validated on real MFM384**; increment 5 gated)
- **Date:** 2026-06-24
- **Relates to:** `device-profiles/` (the profile library), ADR-005 (payload schema),
  `docs/PROVISIONING_API_CONTRACT.md` (NVS plane), `docs/CRM_FIRMWARE_AGENT_GUIDE.md`

## Context

Today each field device is a hand-written matched set in firmware (`meter_read_<dev>` +
`payload_encode_<dev>` + a compiled device-type byte). Adding a device = a firmware PR. The CRM now
serves machine-readable **device profiles** (`device-profiles/`) carrying the full register map +
scaling + ADR-005 payload mapping, minus the slave ID. To let the CRM provision **any** profiled
device with **no firmware rebuild**, the firmware must consume a profile at runtime.

## Decision

Make the field path **data-driven**: a `device_profile_t` (bus params + measurand table + payload
table) drives one **generic Modbus reader** and one **generic ADR-005 encoder**. The profile is
stored in NVS, written by the CRM (extends the Plane-B provisioning console), and the **slave ID is
auto-discovered by a bus scan at commissioning** (the profile omits it). One firmware image serves
all profiled devices.

The existing compiled readers (`meter_*.c`) stay as (a) the proven oracle for host tests and (b) a
compile-time fallback; they are not the growth path.

## Architecture

```
CRM profile (JSON)  --provision-->  NVS blob  --load-->  device_profile_t
                                                              │
   scan-for-ID (modbus_master_scan) ── unit ID ──────────────┤
                                                              ▼
   generic reader: for each measurand -> modbus_master_read -> dp_decode() -> values[]
                                                              ▼
   dp_encode_payload(profile, values, flags) -> ADR-005 frame -> lora_send
```

Numeric model (the pure core, this increment):
- `dp_decode(regs, type, word, scale, offset)` — decode `u16/i16/u32/i32/float32` with word order
  `ABCD/CDAB/BADC/DCBA` → engineering float. Generalises `modbus_regs_to_f32`.
- `dp_encode_payload(profile, values[], flags, out)` — 3-byte ADR-005 header + walk the payload
  field table (per-field `u8/i8/u16/i16/u32/i32` + scale, saturating, big-endian).

## Increment plan (gated)

| # | Scope | Gate |
|---|---|---|
| 1 ✅ | **Pure core** `components/device_profile` (`dp_decode`/`dp_encode_payload`) + host tests | done — host ctest green; KATs per type/word-order + full-frame encode matches Phase 6c MFM384 bytes |
| 2 ✅ | NVS profile blob codec (`dp_serialize`/`dp_deserialize`, versioned+CRC) + `prov-profile` console + `profile_store` (NVS) + `device-profiles/profile_to_blob.py` (CRM writer) | done — host ctest (round-trip + rejects + **C↔Python byte-identical cross-check**); on-target build green. **Bench-verify** (flash + `prov-profile <hex>` + `prov-show` survives reboot) pending with increment 3 |
| 3 ✅ | On-target generic reader (`meter_read_profile`) + app wiring (runtime auto-detect: NVS profile → generic path, else compiled) | **done — HW-validated 2026-06-24** on board `3c:dc:75:6f:85:dc`: MFM384 profile (452 B blob via `prov-profile`) drove a live read — `PROFILE-DRIVEN device_byte=0x01, 23 measurands`, V1N=54.67 V (sane, == compiled FC04/CDAB decode), 39 B frame, `uplink OK`, no stale. RS-FSJT profile authored byte-identical to the compiled path (pending sensor power). **Caveat:** the 39 B MFM384 profile frame needs its matching ChirpStack decoder (firmware decoder is the 19 B Phase-6c layout) — CRM-side decoder-from-profile is a follow-up |
| 4 ✅ | Auto-scan-for-ID (`meter_scan_for_unit`; probe configured unit first, else scan 1..`APP_FIELD_SCAN_ID_HI`, persist) | **done — HW-validated 2026-06-24**: configured unit set wrong (9) → `configured unit 9 silent — scanning bus...` → `persisted discovered unit 1` → read MFM384 (V1N 53.5 V), `uplink OK`. Probe match = CRC-valid reply OR Modbus exception |
| 5 (partial) | Validate all 4 profiles + soak. **`dp_simulate()`** (pure, host-tested) drives a **profile-driven simulator** — with `CONFIG_APP_FIELD_SIMULATE` + a provisioned profile, the field app skips the bus/scan, joins, and uplinks synthesized per-profile data (SIMULATED flag), so EEM400/DSE (no meter on hand) validate the blob→encode→fleet-decoder path over LoRaWAN. | each profile decodes sane in ChirpStack; budgets green. **Software half done** (host `dp_simulate` KAT + builds); the ChirpStack decode of a sim EEM400/DSE uplink + a soak are the bench-gated remainder |

## Consequences

- **+** New device or client = profile data, no firmware rebuild; EEM400/DSE become flashable without
  porting C. One image to test/OTA/certify.
- **−** A runtime interpreter (bounded: DSE's 21 measurands is the worst case) + an NVS blob (versioned;
  size bounded ~ a few hundred bytes). Slightly larger `.text` and per-sample cost than compiled — fine
  off the hot path.
- Schema/firmware coupling handled by a `profile_blob_version` byte; firmware rejects unknown versions.

## Risks / mitigations

- **Wrong map bricks a silent read** → the profile is validated (`validate_profiles.py`) before the CRM
  serves it; the node logs decoded values on first uplink for operator sanity-check.
- **NVS blob corruption** → versioned + CRC; fall back to the compiled default + STALE flag.
- **Bus-scan picks the wrong unit on a shared bus** → scan match rule + optional CRM-pinned unit override.
