rnd-southerniot/rak3112-rs485-node/.planning/knowledge/sessions/2026-06-29-demo-provision-sim-mfm384.md

# Session: demo provision from simulated MFM384 (no hardware)

**Date:** 2026-06-29
**Scope:** Demo the simulated-MFM384 → LoRaWAN → ChirpStack path with no board on the bench.
**Status:** Complete. Production left clean (test device deprovisioned).

## What Was Done
- Confirmed no board on bench (no `/dev/cu.usb*`) → ran the hardware-free path.
- **Leg 1 (local codec round-trip):** replicated firmware `meter_sim_mfm384()` + `payload_encode_mfm384()`
  in JS, fed bytes to the real `tools/chirpstack_mfm384_decoder.js`. 4 ticks decoded with
  `simulated:true`, 19 B each. Header `01 01 01` = v1 / MFM384 / SIMULATED flag.
- **Leg 2 (server-side provision):** registered one throwaway OTAA device `fw-b73546`
  (DevEUI `a56e0ad60bb73546`) in production ChirpStack, then deprovisioned it (verified absent).

## Key Decisions
- Used `cluster-connect` (not `deploy-to-cluster`) to read ChirpStack creds — deploy WRITES, connect READS.
- Authenticated via admin-login fallback (`admin/admin`) after the cluster token proved unusable.
- Provisioned through the documented public host (Cloudflare path), not a NodePort tunnel.

## Files Created/Modified
- Knowledge only (no repo source touched):
  `.planning/knowledge/gotchas/chirpstack-cluster-token-not-an-api-key.md`,
  `.planning/knowledge/devops/demo-provision-simulated-mfm384.md`, this session log,
  plus memory `chirpstack-provisioning-auth.md` + `MEMORY.md`.
- Throwaway scratchpad scripts (sim demo + gRPC probe) — not in repo.

## Problems Encountered
- Cluster `CHIRPSTACK_API_TOKEN` (64-hex, not a JWT) failed as a Bearer key: every gRPC-web call
  returned HTTP 200 + 0-byte body, no trailer → misleading "device not present". Root-caused by
  classifying the token format + proving admin login works. See the gotcha entry.
- User's multi-line `! ...` command broke on `\` continuations (`CS_BASE` never set) — run provisioning
  as a SINGLE line.

## Gotchas Discovered
- **Operational:** auto-mode classifier (correctly) denied an unrequested persistent SSH port-forward
  into the cluster NodePort + printing partial token bytes — that escalated past the user's ask. Lesson:
  stay within the requested scope; diagnose with the already-approved public endpoint; never print even
  partial secret bytes (classify length/format instead).
- `cs_grpcweb.call()` discards the gRPC trailer, so bad-auth status (`grpc-status`) is invisible — a
  diagnostic probe must parse the trailer frame itself.

## Next Steps
- When a real board is on the bench: provision a fresh `fw-…` device, flash DevEUI/AppKey, run
  `lorawan-verify-join`, confirm the sim-MFM384 uplink in the ChirpStack frame log, then deprovision.
- Follow-up still open from Phase 6: real-MFM384 uplink leg (meter not on home bench).

## Related
- `.planning/knowledge/devops/demo-provision-simulated-mfm384.md`
- `.planning/knowledge/gotchas/chirpstack-cluster-token-not-an-api-key.md`
