rnd-southerniot/rak3112-rs485-node/hardware/schematic/v1.1/RAK3112 + RS485 P2P Node V1.1 Schematic.pdf

# USB_D+GND

# GNDGPIO³⁸

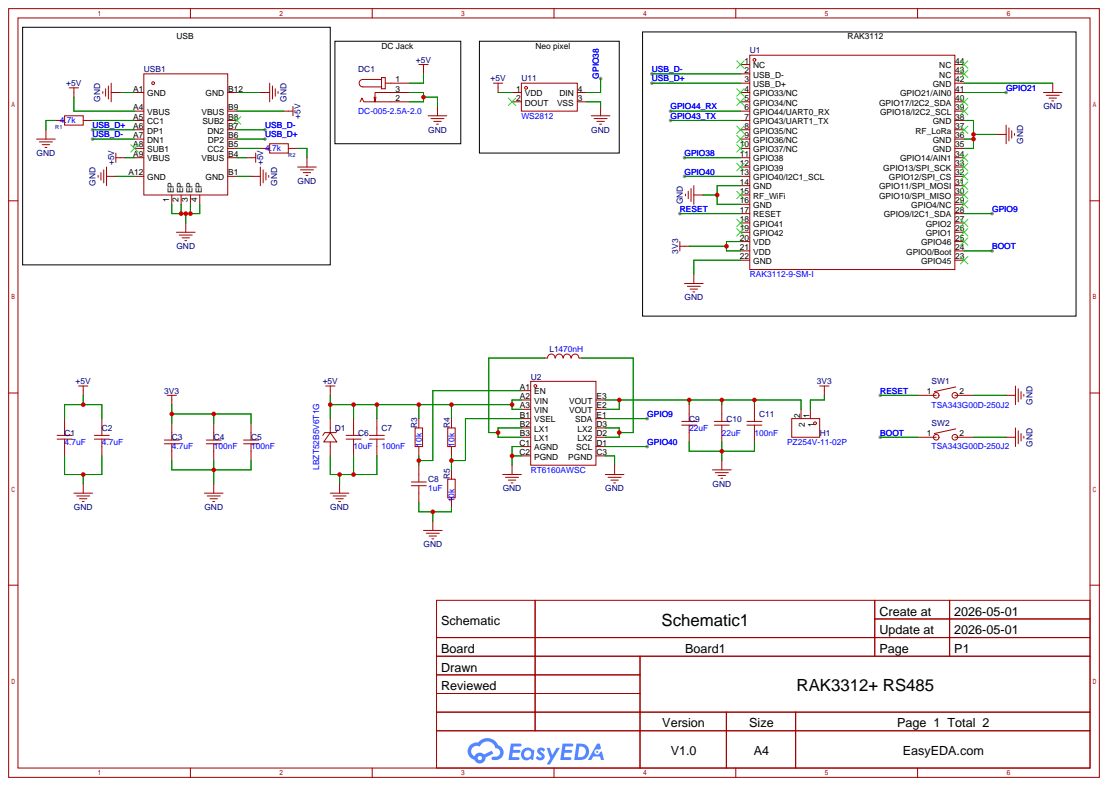
[picture p1: page 1]

Schematic | Schematic1 | Create at | 2026-05-01

Update at | 2026-05-01

Board | Board1 | Page | P1
Drawn | | RAK3312+ RS485
Reviewed

Version | Size | Page 1 Total 2
V1.0 | A4 | EasyEDA.com

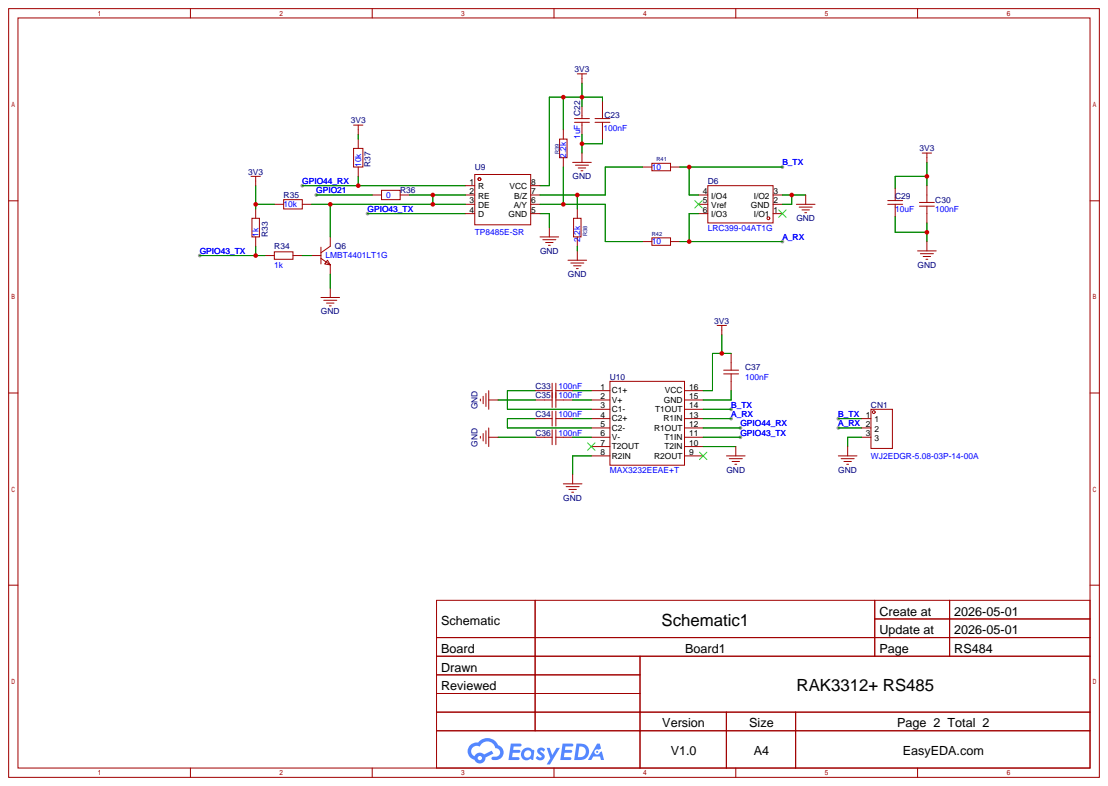
[picture p2: page 2]

Schematic | Schematic1 | Create at | 2026-05-01

Update at | 2026-05-01

Board | Board1 | Page | RS484
Drawn | | RAK3312+ RS485
Reviewed

Version | Size | Page 2 Total 2
V1.0 | A4 | EasyEDA.com
