rnd-southerniot/rak3112-rs485-node/(list of files, drawings)

Other design files:
hardware/schematic/v1.1/RAK3112 + RS485 P2P Node V1.1.epro
