rnd-southerniot/rak3112-rs485-node/firmware/main/provisioning.c

#include "provisioning.h"

#include <stdint.h>
#include <stdio.h>
#include <stdlib.h>
#include <string.h>

#include "esp_console.h"
#include "esp_log.h"
#include "esp_system.h"
#include "freertos/FreeRTOS.h"
#include "freertos/task.h"
#include "nvs.h"

#include "profile_store.h"

static const char *TAG = "prov";
#define PROV_NS "prov"

static bool parse_hex_bytes(const char *s, uint8_t *out, size_t nbytes)
{
    if (strlen(s) != nbytes * 2) {
        return false;
    }
    for (size_t i = 0; i < nbytes; ++i) {
        char b[3] = {s[2 * i], s[2 * i + 1], 0};
        char *end = NULL;
        long v = strtol(b, &end, 16);
        if (end != b + 2 || v < 0 || v > 0xff) {
            return false;
        }
        out[i] = (uint8_t)v;
    }
    return true;
}

/* prov-lorawan <deveui16hex> <joineui16hex> <appkey32hex> */
static int cmd_lorawan(int argc, char **argv)
{
    if (argc != 4 || strlen(argv[1]) != 16 || strlen(argv[2]) != 16 || strlen(argv[3]) != 32) {
        printf("ERR usage: prov-lorawan <deveui16hex> <joineui16hex> <appkey32hex>\n");
        return 1;
    }
    uint8_t appkey[16];
    if (!parse_hex_bytes(argv[3], appkey, sizeof(appkey))) {
        printf("ERR appkey not 32 hex chars\n");
        return 1;
    }
    const uint64_t de = strtoull(argv[1], NULL, 16);
    const uint64_t je = strtoull(argv[2], NULL, 16);
    nvs_handle_t h;
    if (nvs_open(PROV_NS, NVS_READWRITE, &h) != ESP_OK) {
        printf("ERR nvs open\n");
        return 1;
    }
    nvs_set_u64(h, "deveui", de);
    nvs_set_u64(h, "joineui", je);
    nvs_set_blob(h, "appkey", appkey, sizeof(appkey));
    esp_err_t err = nvs_commit(h);
    nvs_close(h);
    printf(err == ESP_OK ? "OK lorawan deveui=%016llx joineui=%016llx appkey=<redacted>\n"
                         : "ERR nvs commit\n",
           (unsigned long long)de, (unsigned long long)je);
    return err == ESP_OK ? 0 : 1;
}

/* prov-modbus <dev 0|1> <baud> <parity 0|1|2> <unit> <interval_s> */
static int cmd_modbus(int argc, char **argv)
{
    if (argc != 6) {
        printf("ERR usage: prov-modbus <dev 0=MFM384|1=RSFSJT> <baud> <par 0=N|1=E|2=O> <unit> "
               "<interval_s>\n");
        return 1;
    }
    nvs_handle_t h;
    if (nvs_open(PROV_NS, NVS_READWRITE, &h) != ESP_OK) {
        printf("ERR nvs open\n");
        return 1;
    }
    nvs_set_u8(h, "dev", (uint8_t)atoi(argv[1]));
    nvs_set_u32(h, "baud", (uint32_t)strtoul(argv[2], NULL, 10));
    nvs_set_u8(h, "par", (uint8_t)atoi(argv[3]));
    nvs_set_u8(h, "unit", (uint8_t)atoi(argv[4]));
    nvs_set_u32(h, "intv", (uint32_t)strtoul(argv[5], NULL, 10));
    esp_err_t err = nvs_commit(h);
    nvs_close(h);
    if (err != ESP_OK) {
        printf("ERR nvs commit\n");
        return 1;
    }
    printf("OK modbus dev=%s baud=%s par=%s unit=%s intv=%s\n", argv[1], argv[2], argv[3], argv[4],
           argv[5]);
    return 0;
}

/* prov-profile <hexblob> — store a dp_serialize() device-profile blob (validated before persist).
 */
static int cmd_profile(int argc, char **argv)
{
    if (argc != 2) {
        printf("ERR usage: prov-profile <hexblob>\n");
        return 1;
    }
    const size_t hexlen = strlen(argv[1]);
    if (hexlen < 2 || (hexlen % 2) != 0 || (hexlen / 2) > PROFILE_BLOB_MAX) {
        printf("ERR blob hex length %u invalid (max %u bytes)\n", (unsigned)hexlen,
               (unsigned)PROFILE_BLOB_MAX);
        return 1;
    }
    static uint8_t blob[PROFILE_BLOB_MAX];
    const size_t nbytes = hexlen / 2;
    if (!parse_hex_bytes(argv[1], blob, nbytes)) {
        printf("ERR blob not valid hex\n");
        return 1;
    }
    if (!profile_store_save(blob, nbytes)) {
        printf("ERR profile rejected (bad version/CRC/bounds) or NVS error\n");
        return 1;
    }
    printf("OK profile stored (%u B)\n", (unsigned)nbytes);
    return 0;
}

static int cmd_show(int argc, char **argv)
{
    (void)argc;
    (void)argv;
    nvs_handle_t h;
    if (nvs_open(PROV_NS, NVS_READONLY, &h) != ESP_OK) {
        printf("prov: (empty)\n");
        return 0;
    }
    uint64_t de = 0, je = 0;
    nvs_get_u64(h, "deveui", &de);
    nvs_get_u64(h, "joineui", &je);
    uint8_t ak[16];
    size_t n = sizeof(ak);
    const bool hasak = (nvs_get_blob(h, "appkey", ak, &n) == ESP_OK && n == sizeof(ak));
    uint8_t dev = 0, par = 0, unit = 0;
    uint32_t baud = 0, intv = 0;
    nvs_get_u8(h, "dev", &dev);
    nvs_get_u32(h, "baud", &baud);
    nvs_get_u8(h, "par", &par);
    nvs_get_u8(h, "unit", &unit);
    nvs_get_u32(h, "intv", &intv);
    nvs_close(h);
    uint8_t pdev = 0, pmeas = 0;
    const bool hasprofile = profile_store_present(&pdev, &pmeas);
    printf("prov: deveui=%016llx joineui=%016llx appkey=%s | dev=%u baud=%lu par=%u unit=%u "
           "intv=%lu | profile=%s",
           (unsigned long long)de, (unsigned long long)je, hasak ? "set" : "unset", (unsigned)dev,
           (unsigned long)baud, (unsigned)par, (unsigned)unit, (unsigned long)intv,
           hasprofile ? "" : "none\n");
    if (hasprofile) {
        printf("device_byte=0x%02X,%u measurands\n", (unsigned)pdev, (unsigned)pmeas);
    }
    return 0;
}

static int cmd_clear(int argc, char **argv)
{
    (void)argc;
    (void)argv;
    nvs_handle_t h;
    if (nvs_open(PROV_NS, NVS_READWRITE, &h) == ESP_OK) {
        nvs_erase_all(h);
        nvs_commit(h);
        nvs_close(h);
    }
    printf("OK cleared\n");
    return 0;
}

static int cmd_done(int argc, char **argv)
{
    (void)argc;
    (void)argv;
    printf("OK restarting into field mode\n");
    fflush(stdout);
    vTaskDelay(pdMS_TO_TICKS(200));
    esp_restart();
    return 0;
}

/* Register the prov-* commands onto the REPL created + owned by prov_console_init(). */
void provisioning_register_commands(void)
{
    const esp_console_cmd_t cmds[] = {
        {.command = "prov-lorawan",
         .help = "<deveui16> <joineui16> <appkey32> — set OTAA credentials",
         .func = cmd_lorawan},
        {.command = "prov-modbus",
         .help = "<dev 0|1> <baud> <par 0|1|2> <unit> <interval_s> — set field config",
         .func = cmd_modbus},
        {.command = "prov-profile",
         .help = "<hexblob> — store a device-profile blob (validated)",
         .func = cmd_profile},
        {.command = "prov-show",
         .help = "print current provisioning (appkey redacted)",
         .func = cmd_show},
        {.command = "prov-clear", .help = "erase the provisioning namespace", .func = cmd_clear},
        {.command = "prov-done", .help = "commit + restart into field mode", .func = cmd_done},
    };
    for (size_t i = 0; i < sizeof(cmds) / sizeof(cmds[0]); ++i) {
        ESP_ERROR_CHECK(esp_console_cmd_register(&cmds[i]));
    }
    ESP_LOGI(TAG, "prov-* commands registered (prov-lorawan/-modbus/-profile/-show/-clear/-done; "
                  "or tools/provision_nvs.py); nonces/session preserved");
}
