rnd-southerniot/rak3112-rs485-node/pi-scanner/app/main.py

"""FastAPI entrypoint — REST + WebSocket for the kiosk UI, static web/ mount.

Run: ``uvicorn app.main:app --host 127.0.0.1 --port 8080`` (a systemd unit boots this; Chromium kiosk
points at localhost). One global Orchestrator/session — a station scans one device at a time.
"""

from __future__ import annotations

import asyncio
import json
import os
from contextlib import asynccontextmanager

from fastapi import FastAPI, WebSocket, WebSocketDisconnect
from fastapi.responses import JSONResponse
from fastapi.staticfiles import StaticFiles

from .config import CONFIG
from .events import EventBus
from .orchestrator import Orchestrator

bus = EventBus()
orch = Orchestrator(bus, CONFIG)

_WEB_DIR = os.path.join(os.path.dirname(__file__), "..", "web")


@asynccontextmanager
async def lifespan(_app: "FastAPI"):
    bus.bind_loop(asyncio.get_running_loop())
    yield


app = FastAPI(title="Careflow RS-485 Scanner Station", lifespan=lifespan)


@app.middleware("http")
async def _no_cache(request, call_next):
    # The kiosk is updated in place (rsync); never let Chromium serve a stale UI from disk cache.
    resp = await call_next(request)
    resp.headers["Cache-Control"] = "no-store"
    return resp


@app.get("/api/ports")
def list_ports() -> dict:
    ports = ["mock"]
    try:
        from serial.tools import list_ports as lp

        ports += [p.device for p in lp.comports()]
    except Exception:
        pass
    return {"ports": ports}


@app.get("/api/session")
def get_session() -> dict:
    return orch.snapshot()


@app.post("/api/session/start")
async def start(body: dict) -> JSONResponse:
    port = (body or {}).get("port") or CONFIG.node_port
    try:
        orch.start_search(port)
    except RuntimeError as exc:
        return JSONResponse({"error": str(exc)}, status_code=409)
    return JSONResponse({"ok": True, "port": port}, status_code=202)


@app.post("/api/session/operator-input")
async def operator_input(body: dict) -> dict:
    return orch.update_operator_input(body or {})


@app.post("/api/session/confirm")
async def confirm() -> JSONResponse:
    try:
        orch.confirm()
    except RuntimeError as exc:
        return JSONResponse({"error": str(exc)}, status_code=409)
    return JSONResponse({"ok": True}, status_code=202)


@app.post("/api/session/retry")
async def retry() -> dict:
    orch.retry()
    return {"ok": True}


@app.post("/api/session/reset")
async def reset() -> dict:
    orch.reset()
    return {"ok": True}


_OSK_DEST = "sm.puri.OSK0"  # squeekboard's D-Bus name / object / interface
_OSK_PATH = "/sm/puri/OSK0"


@app.post("/api/kiosk/keyboard")
async def kiosk_keyboard(body: dict) -> dict:
    """Show/hide the on-screen keyboard for touch-only kiosks.

    Drives Raspberry Pi's squeekboard via D-Bus (sm.puri.OSK0.SetVisible). squeekboard types into
    the focused Chromium field through the Wayland input-method protocol and also auto-shows on focus;
    this endpoint lets the ⌨ button force it. (wvkbd was dropped: its virtual-keyboard key injection
    didn't land in the field, and its wlr-layer surface is hidden behind the kiosk window anyway.)

    ``{"toggle": true}`` flips visibility; ``{"show": bool}`` forces a state. No-op if squeekboard
    isn't running. NOTE: the systemd unit must expose the user session bus to reach it —
    ``DBUS_SESSION_BUS_ADDRESS`` / ``XDG_RUNTIME_DIR`` are set in careflow-scanner.service.
    """
    import subprocess

    body = body or {}

    def _visible() -> bool:
        r = subprocess.run(
            ["busctl", "--user", "get-property", _OSK_DEST, _OSK_PATH, _OSK_DEST, "Visible"],
            capture_output=True, text=True,
        )
        return "true" in r.stdout

    try:
        show = (not _visible()) if body.get("toggle") else bool(body.get("show", True))
        subprocess.run(
            ["busctl", "--user", "call", _OSK_DEST, _OSK_PATH, _OSK_DEST,
             "SetVisible", "b", "true" if show else "false"],
            capture_output=True,
        )
        return {"ok": True, "shown": show}
    except Exception:
        return {"ok": True, "shown": False}


@app.post("/api/kiosk/exit")
async def kiosk_exit() -> dict:
    """Close the kiosk browser -> back to the desktop (touch-friendly exit; no keyboard needed)."""
    import subprocess

    try:
        subprocess.Popen(["pkill", "-f", "chromium"])
    except Exception:
        pass
    return {"ok": True}


@app.websocket("/ws")
async def ws(sock: WebSocket) -> None:
    await sock.accept()
    q = bus.subscribe()
    # send the current snapshot so a late-joining UI is immediately consistent
    await sock.send_text(json.dumps({"type": "snapshot", "data": orch.snapshot()}))
    try:
        while True:
            ev = await q.get()
            await sock.send_text(json.dumps({"type": ev.type, "data": ev.data}))
    except WebSocketDisconnect:
        pass
    finally:
        bus.unsubscribe(q)


# Static kiosk UI last, so /api and /ws win. html=True serves index.html at /.
if os.path.isdir(_WEB_DIR):
    app.mount("/", StaticFiles(directory=_WEB_DIR, html=True), name="web")
