rnd-southerniot/rak3112-rs485-node/(commit log)

2026-05-01 chore(repo): initialize execution contract and project skeleton
    P1-01. Initial commit. Establishes:
    - CLAUDE.md (rev3): split-repo firmware contract, version-pinned toolchain
    (ESP-IDF v5.5.4, PlatformIO espressif32 ~6.7.0, gitleaks v8.30.x,
    clang-format LLVM 18, pre-commit >= 3.x), guardrails (strap-pin
    discipline, region lock, dual-build invariant), Phase 1 plan with
    pre-scaffold ESP-IDF stash for pristine v5.5.4 build, OQ-1..OQ-8.
    - README.md (entry point), HARDWARE_REV.md (cross-repo SHA pin placeholder).
    - .gitignore (ESP-IDF + PlatformIO + macOS + secrets).
    - .gitleaks.toml, .clang-format (LLVM style, IndentWidth 4, ColumnLimit 100).
    - .env.example (provisioning placeholders for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
2026-05-01 chore(hardware): import schematic v1.1 snapshot (read-only)
    P1-03. Snapshot of EasyEDA Pro project from
    ~/Developer/projects/pcb-design/rs485-node/ captured 2026-05-01:
    - RAK3112 + RS485 P2P Node V1.1 Schematic.pdf
    - RAK3112 + RS485 P2P Node V1.1.epro
    Read-only mirror. Canonical edits happen in
    rnd-southerniot/rak3112-rs485-node-hw (planned). The earlier
    ProPrj_RAK3312+...epro filename (with the RAK3312 typo) was
    superseded between Phase 0 discovery and Phase 1 scaffold.
    OQ-8 raised: schematic title "RS485 P2P Node V1.1" needs Phase 2
    clarification - LoRa P2P vs LoRaWAN. Affects Phase 5 stack choice.
    [RAK3112 + RS485 P2P Node V1.1.epro]
2026-05-01 feat(scaffold): ESP-IDF + PlatformIO baseline (heartbeat printf only)
    P1-04. Dual-build firmware skeleton:
    - firmware/CMakeLists.txt: project rak3112_rs485_node, IDF_PATH-based
    - firmware/main/CMakeLists.txt: idf_component_register, app_main.c
    - firmware/main/app_main.c: 1Hz printf heartbeat, no GPIO/peripherals
    - firmware/sdkconfig.defaults: target esp32s3, 16MB flash, PSRAM=n,
    USB-CDC console (CONFIG_ESP_CONSOLE_USB_CDC=y on Serial-JTAG peripheral
    - does not engage TinyUSB stack, so OQ-7 patches are off-compile-path)
    - firmware/platformio.ini: platform = espressif32 @ ~6.7.0,
    framework = espidf (mirrors sdkconfig.defaults), no Arduino
    framework settings, no custom partition table (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
2026-05-01 ci: GitHub Actions matrix - pre-commit, idf-build, pio-build, gitleaks, host-tests
    P1-06. Five-job CI workflow with version-pinned tools:
    - pre-commit (macOS runner, llvm@18 + pre-commit via brew/pipx)
    - idf-build (espressif/esp-idf-ci-action@v1, esp_idf_version v5.5.4,
    target esp32s3 - clones pristine v5.5.4 from upstream)
    - pio-build (Python 3.12 + platformio>=6.1.13,<7)
    - gitleaks (v8.30.1 from upstream tarball)
    - host-tests (layout-only check; ctest activation in Phase 4)
    Triggers on push to main / phase/ ** / feat/ ** / fix/ ** and PRs to main.
2026-05-01 fix(scaffold): drop PlatformIO entirely, single canonical build path (rev4)
    P1-FIX-2 (after P1-FAIL-2 strategic decision: option 3 reframed).
    Contract changes (CLAUDE.md rev3 -> rev4):
    - §0 status: rev4
    - §1: removed PlatformIO row from toolchain table; added footnote 2
    recording that PIO was considered and dropped, with rationale
    - §1 environment: removed "PlatformIO via pipx"
    - §3 #6: rewritten - "Single canonical build path" with functional-
    equivalence reproducibility guarantee (was already the contract's
    real promise; the byte-equivalent framing in earlier reviews was
    operator-introduced and not load-bearing)
    - §4 CI matrix: 4 jobs (pre-commit, idf-build, gitleaks, host-te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
2026-05-01 docs(state): Phase 1 sign-off recorded; OQ-8 closed (LoRaWAN/AS923)
    Post-sign-off contract update — no code changes, no scaffold changes.
    §7 OQ-8: CLOSED 2026-05-01. Resolution recorded: LoRaWAN, Class A,
    AS923, OTAA join to existing CRM ChirpStack at 10.10.8.140. Reasoning
    attached to the entry. OQ-3 default (RadioLib) confirmed by user at
    sign-off; formal close still tracks via ADR-003 in Phase 5. OQ-4
    (AS923 sub-band) remains open until Phase 5.
    §6 State block: Attempt 3 row updated to PASS · signed off. Full
    SHA-256 of binary now stored verbatim in the row (rev4-era truncation
    was a chat-summary artefact, not a tag-annotation defect — tag itself
    already had the full hash).
    Trai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
2026-05-01 docs(contract): rev5 — Phase 2 entry criteria locked (EC-1..EC-9)
    Replaces the rev4 Phase 2 stub in §5 with a fully-specified entry-
    criteria block. All EC-N have bare smoke gates (per Guardrail §3 #9).
    Cross-repo gates verify *the coupling*, not the other repo's content
    (per new Footnote 3).
    Rev2 -> rev5 progression:
    rev2: original draft, monorepo direction reversed mid-review
    rev3: pin bumps + R3 gateway IP correction (memory vs §15 lesson)
    rev4: PlatformIO dropped, single canonical build path
    (joint-pin inconsistency lesson)
    rev5: Phase 2 EC-1..EC-9 locked, split-repo coupling discipline
    (aesthetic vs functional preference lesson)
    Each revision resolved a re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
2026-05-01 docs(contract): rev6 — correct hardware-repo gate paths (drop "hardware/" prefix)
    Rev5 §5 EC-2..EC-9 "Smoke gate (hardware repo):" code blocks and body
    content references inadvertently carried the firmware-repo's `hardware/`
    prefix into hardware-repo gate paths. The hardware repo's actual layout
    puts `schematic/`, `adr/`, `photos/` at root — there's no `hardware/`
    top-level directory there. The prefix only exists inside the firmware
    repo, where it identifies the read-only snapshot of canonical hardware
    content (firmware §2 layout block).
    Concrete impact pre-rev6: literal execution of EC-2..EC-9 smoke gates
    would have failed at the path-existence checks because the gate strings
    referen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
2026-05-01 docs(contract): rev7 — align schematic version label V1.0 → V1.1 across the contract
    EC-2 file inspection during Phase 2 execution surfaced three separate
    version labels for the same content (filename V1.1, .esch internal
    attribute V1.0, firmware-repo Phase 1 mirror dir v1.1/). The operator
    re-exported from EasyEDA Pro on 2026-05-01 with @Version updated to
    V1.1, so the .esch internal label is now consistent. Rev5/rev6 had
    the firmware contract using `schematic/v1.0/` for Phase 2 paths,
    inconsistent with everything else.
    Rev7 aligns the contract to V1.1 across the board.
    Path / tag changes:
    - schematic/v1.0/ → schematic/v1.1/ (12 occurrences across §2, §5)
    - v1.0-archive →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
2026-05-01 feat(sdkconfig): EC-6 — enable Octal SPI PSRAM (OQ-2 resolved)
    Phase 2 EC-6 PASS. OQ-2 (PSRAM mode) closes with Octal SPI per the
    silicon-vendor datasheet (Espressif ESP32-S3 Series Datasheet v2.2
    §1.2 Table 1-1, page 13).
    sdkconfig.defaults change:
    CONFIG_SPIRAM=n -> CONFIG_SPIRAM=y
    + new: CONFIG_SPIRAM_MODE_OCT=y
    Verification:
    idf.py build exit 0
    Binary size: 190080 bytes (was 183328 with PSRAM=n; +6752 bytes
    is PSRAM init code, expected).
    Method (the part worth recording — see RUNBOOK lesson below):
    Two-sources rule (per rev6/rev7 EC-6) returned silent.
    RAK3112 datasheet: "8 MB PSRAM" with no mode disclosure.
    rnd-southerniot/rak3112-dynamic-sensor: # C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
2026-05-01 feat(coupling): EC-8b — HARDWARE_REV.md interim pin to hw-repo main tip
    Phase 2 EC-8b (publish step 10) — pin the firmware repo to the
    hardware repo's current main-tip SHA as an interim coupling.
    Pin:
    pinned_sha: 8554115b8dadee593b615d9b47baad67d8ac66d6
    pinned_tag: (interim — replaced by adr-001-locked at EC-9)
    pinned_date: 2026-05-02
    The pinned_sha (full 40-char hex, no truncation per "aesthetic vs
    functional preference" lesson) is the hw repo's main tip after the
    EC-8b publish — i.e., the commit "docs(adr): pre-populate Decision/
    Consequences/Alternatives drafts (EC-9 sign-off prep)" on hw repo.
    Format: HARDWARE_REV.md now has BOTH a machine-parseable section
    (matching t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
2026-05-01 chore(coupling+state): pin HARDWARE_REV.md to adr-001-locked + Phase 2 close
    Phase 2 EC-9 post-sign-off sequence (firmware side, after hw repo
    ADR-001 sign-off at a0b002c on rak3112-rs485-node-hw main).
    HARDWARE_REV.md:
    - pinned_sha: 8554115b8d... -> a0b002ca709598ddd44aca7e8f5e829348da8295
    - pinned_tag: (interim) -> adr-001-locked
    - pinned_date: 2026-05-02
    - Previous interim main-tip pin recorded as superseded for traceability
    CLAUDE.md §6 State block:
    - New row: Phase 2 PASS · signed off, full EC closure summary
    with all commit SHAs (full hex, no truncation per the
    aesthetic-vs-functional lesson)
    - Carries-forward to Phase 3: GPIO9 + GPIO40 deliberate-floating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
2026-06-20 feat(pins): gpio_remap.h single source of truth + PIN_MAP.md mirror
    P3-01. Seed board pin map from hardware ADR-001 (adr-001-locked / a0b002c):
    RS-485 (GPIO21 DE/RE inverted, GPIO43 TX, GPIO44 RX), WS2812 (GPIO38),
    reserved V1.2 I2C nets (GPIO9/GPIO40), strap pins marked DO-NOT-DRIVE.
    Add main/include to component INCLUDE_DIRS; docs/PIN_MAP.md mirrors the header.
    [gpio_remap.h]
2026-06-20 feat(boot): hold GPIO9/GPIO40 deliberate-floating at boot
    P3-02. ADR-001 EC-4/EC-9 carry-forward: V1.2-reserved I2C nets are
    routed-but-unterminated on V1.1. Configure both high-Z (mode disabled,
    no internal pull, no drive) before the heartbeat loop to avoid undefined
    power draw / spurious ULP wakeup. Heartbeat printf preserved.
    [app_main.c]
2026-06-20 docs(runbook+state): Phase 3 bench checklist + ADR-001 <TBD> hygiene note
    P3-04. RUNBOOK gains the Phase 3 hardware-safety pre-flight (H1 jumper,
    power, strap pins, no mass-erase, chip-id check) + PASS-evidence template.
    Records the post-sign-off ADR-001 <TBD> hygiene fix (hw merge 3cce0c6) —
    adr-001-locked tag unmoved, HARDWARE_REV.md pin still valid. State annotated.
2026-06-20 fix(console): USB_CDC -> USB_SERIAL_JTAG (Phase 3 first-flash finding)
    P3-05. RAK3112 native USB is the ESP32-S3 USB-Serial-JTAG controller; the
    Phase-1 USB_CDC (OTG/TinyUSB) console produced no visible output on the bench
    board. Switching to USB_SERIAL_JTAG yields a full, correct console. Phase 3
    smoke gate PASS: Found 8MB PSRAM device + Adding pool of 8192K PSRAM to heap +
    GPIO9/40 floating + 1 Hz heartbeat, no bootloop/brownout. Boot log in RUNBOOK.
2026-06-20 docs(state): Phase 3 first-flash PASS (awaiting sign-off)
    P3-06. Record Phase 3 Attempt 1 PASS in State block: PSRAM Octal init verified
    on real ESP32-S3R8 (boot log evidence), GPIO9/40 floating, 1 Hz heartbeat,
    console = USB-Serial-JTAG. Tag + main-merge + Phase 4 held for sign-off.
2026-06-20 docs(p3): correct project board identity (MAC ...85:dc), re-validated PASS
    Phase 3 Attempt 1 was flashed to a non-project RAK3112 (MAC 3c:dc:75:6f:89:24,
    pins not exposed). The actual project board is MAC 3c:dc:75:6f:85:dc (pins
    exposed). Re-flashed byte-identical phase-3-first-flash-green firmware to the
    correct board; identical full PASS (PSRAM Octal+3V, heap pool 8192K, GPIO9/40
    floating, 1 Hz heartbeat, no bootloop). Tag + sign-off stand. RUNBOOK Attempt 2
    + State note record the correction; project flash-target MAC fixed for Phase 4+.
2026-06-20 docs(adr): ADR-002 RS-485 bus electrical + DE/RE control strategy
    P4-01. UART1 half-duplex + inverted RTS on GPIO21 (matches Q6 inverter, ADR-001
    EC-5a). Bus electrical from V1.1 BOM: no on-board 120ohm termination (external at
    bus ends); R41/R42=10ohm A/B series protection (corrects ADR-001's bias guess);
    R38/R39=2.2k candidate fail-safe bias. Cites adr-001-locked.
2026-06-20 feat(rs485): half-duplex RS-485 driver (UART1, inverted-RTS DE/RE)
    P4-03. UART_MODE_RS485_HALF_DUPLEX + uart_set_line_inverse(RTS) for Q6 inverter
    (ADR-002 / ADR-001 EC-5a). DE/RE tied => no self-RX echo.
    [rs485.c, rs485.h]
2026-06-20 feat(app): RS-485 echo task staged through ring buffer
    P4-04. app_main inits rs485 (9600 default; re-flash 115200 for 2nd pass) + echo
    task staging RX through the host-tested ring buffer. Heartbeat slowed to 5 s.
2026-06-20 docs(runbook): Phase 4 bench setup + on-target bring-up PASS
    P4-05. RS-485 bench procedure (CN1 wiring, external 120ohm termination, bias,
    Saleae). Attempt 1: rs485_init verified on board MAC ...85:dc; HIL echo/turnaround
    held for bench gear (USB-RS485 adapter + Saleae).
2026-06-20 fix(rs485): DE/RE is STANDARD polarity, not inverted — HIL echo PASS
    P4-06. Bench bring-up proved ADR-001 EC-5a's DE/RE polarity wrong. A toggle
    diagnostic (GPIO21 as plain output, alternating while listening) showed
    GPIO21 LOW = clean RX, HIGH = nothing => standard polarity (HIGH=TX, LOW=RX).
    The rev1 inverted-RTS firmware idled U9 in transmit, so the node never received
    (empty/garbled captures during bring-up).
    Fix: uart_set_line_inverse(..., UART_SIGNAL_INV_DISABLE). Result: byte-identical
    echo at 9600 AND 115200 via the RS-485 adapter. Corrected gpio_remap.h, PIN_MAP.md,
    rs485.h, ADR-002 (rev2), RUNBOOK Phase 4 Attempt 2. Hardware ADR-001 EC-5a
    correction filed separately in the hw re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
    [gpio_remap.h, rs485.c, rs485.h]
2026-06-20 feat(lora): Phase 5a — SX1262 pins confirmed on bench + ADR-003 (RadioLib)
    SX1262 SPI bring-up probe (no TX) confirmed the module-internal radio pins on the
    project board: NSS=7 SCK=5 MOSI=6 MISO=3 NRESET=8 BUSY=48 DIO1=47 (GetStatus=0x2a,
    register R/W round-trip all matched). ADR-001's GPIO10-13 SX1262-SPI labels were
    WRONG (those are a separate user SPI) — corrected hw-side separately.
    Locked pins in gpio_remap.h + PIN_MAP.md; RUNBOOK Phase 5a PASS recorded. Stack
    decision ADR-003 = RadioLib (native ESP-IDF component, EspHal, SX1262+AS923+OTAA),
    retires OQ-3. 5b (OTAA join, RF TX) held for antenna + TCXO-voltage confirm.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
    [gpio_remap.h]
2026-06-20 feat(provisioning): CRM-driven LoRaWAN provisioning + ADR-004 (AS923-1)
    Phase 5b provisioning: tools/provision_node.py walks the SCOMM CRM onboarding
    workflow (siot-crm-review) to register the node in ChirpStack (AS923 OTAA) — CRM
    is the system of record, not direct ChirpStack. DevEUI 3cdc75fffe6f85dc (MAC-
    derived), AppKey in gitignored firmware/.env. Device confirmed registered in
    ChirpStack (lorawanProvisioningStatus=COMPLETED, found=true). ADR-004 = AS923-1
    (retires OQ-4). RUNBOOK 5b-prov record + contract gotchas + CRM seed-cred security flag.
2026-06-20 feat(lora): RadioLib SX1262 OTAA — AS923 JOIN works; data uplink TxDone WIP
    Phase 5b firmware. RadioLib 7.7.1 native ESP-IDF managed component + vendored S3
    HAL (EspHalS3.h; bundled EspHal is ESP32-classic-only). C++ lora.cpp behind a C API.
    Creds from gitignored firmware/.env -> generated lora_credentials.h.
    OTAA JOIN SUCCESS at AS923-1 (TCXO 1.8V, DIO2 RF switch): ChirpStack 10.10.8.140
    accepted the JoinRequest + downlinked accept (full RF round-trip; device live). NVS
    DevNonce/session persistence added + verified (fixes -1116 re-join). OPEN: data
    uplink -> -5 TX_TIMEOUT (suspect EspHalS3 DIO1 ISR). RUNBOOK Phase 5 5b-fw.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
    [app_main.c]
2026-06-20 fix(lora): proper DIO1 ISR trampoline (UB cast removed); refine uplink -5 diagnosis
    EspHalS3 attachInterrupt now routes through a void(void*) trampoline instead of
    casting RadioLib's void(void) cb to gpio_isr_t (UB); ISR service installed without
    ESP_INTR_FLAG_IRAM (RadioLib cb is flash-resident). Real latent bug fixed, but it does
    NOT clear the data-uplink -5: LoRaWANNode::transmitUplink POLLS digitalRead(DIO1), not
    the ISR. Refined root cause in RUNBOOK 5b-fw: SetTx staged+launched OK but TxDone never
    asserts on the data uplink (join's TX on the same path works). Next: RADIOLIB_DEBUG + scope.
2026-06-22 chore(mcp): attach siot-mcp-gateway + firmware-knowledge tooling
    Project-scoped MCP wiring for the SIOT gateway (10.10.8.113), discovered to be
    an MCP *proxy* (mcp-proxy.service), not a CRM/ChirpStack device API:
    - .mcp.json: attach siot-mcp-gateway at project scope (Bearer via
    ${SIOT_MCP_GATEWAY_TOKEN} env indirection — no secret in tree)
    - docs/MCP_GATEWAY.md: proxy model, upstreams, call_upstream_tool convention,
    token recovery procedure
    - .claude/skills/mcp-gateway-health: pre-flight health + auth + upstream list
    - .claude/skills/rak-lorawan-knowledge: query firmware-knowledge upstream
    (RAK LoRaWAN OTAA AS923-1 + provisioning KB) for Phase 5 join/uplink debug
    Fit = firmware-kno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
2026-06-22 fix(lora): 1 kHz FreeRTOS tick clears data-uplink -5 TX_TIMEOUT
    P5. Root cause: at the ESP-IDF default 100 Hz tick (10 ms), RadioLib's
    LoRaWANNode::transmitUplink waits with sleepDelay(toa) then polls digitalRead(DIO1)
    for only scanGuard=10 ms (= 1 tick). vTaskDelay quantization undershoots the air-time
    and millis() advances in 10 ms steps, so the guard expires before TxDone is read ->
    RADIOLIB_ERR_TX_TIMEOUT (-5). Not a DR/ToA issue (forcing DR3/ADR-off never helped);
    the prior DIO1-ISR-trampoline fix addressed only the downlink path.
    Fix: CONFIG_FREERTOS_HZ=1000 -> sleepDelay accurate to ~1 ms, 10 ms guard = 10 ticks,
    RX1/RX2 windows tighten too.
    Bench-verified on project board (S3R8, MA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
2026-06-22 docs(lora): confirm Phase 5 uplink end-to-end in ChirpStack frame log
    P5. Captured the uplink in the ChirpStack frame log (10.10.8.140:8080):
    UnconfirmedDataUp, fPort 1, frm_payload a500245a, fCnt 98, ADR off,
    SF9/BW125/CR4_5 (=DR3) @ 923.4 MHz, as923_1, CRC_OK, RSSI -48 / SNR +12.2
    via gw ac1f09fffe1f340d. All fields match firmware config — the -5 fix is
    validated end-to-end. RUNBOOK 5c updated; uplink milestone PASS.
2026-06-22 docs(state): Phase 5 signed off + merged (LoRaWAN OTAA AS923 uplink)
    P5. §6 State block entry: OTAA join + data uplink working end-to-end, -5
    TX_TIMEOUT fixed (CONFIG_FREERTOS_HZ=1000), confirmed in ChirpStack frame log.
    CI green (run 27961398800), merged ed799c3, tagged phase-5-lorawan-green.
2026-06-22 feat(modbus): Phase 6a — RTU master framing core + host tests
    P6. Custom Modbus RTU master (reuse Phase 4 rs485 transport; framing kept as
    pure host-testable logic) instead of esp-modbus.
    components/modbus/modbus_rtu.{c,h} (pure, no SDK):
    - modbus_crc16 (CRC-16/MODBUS, poly 0xA001)
    - modbus_build_read (FC03/FC04 request ADU, CRC low-byte-first)
    - modbus_parse_read_response (length/CRC/slave/func checks, exception decode,
    big-endian register extraction)
    tests/host/test_modbus_rtu.c — wired into the ctest suite: CRC known-answer
    ("123456789" -> 0x4B37), request build + bad-args, parse OK, parse exception,
    parse error paths (CRC/short/slave/func/bytecount/arg). 2/2 host tests pass,
    -Wal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
    [modbus_rtu.c, modbus_rtu.h]
2026-06-22 feat(modbus): Phase 6b — RTU master + bus-scan bring-up tool
    P6. On-target Modbus master over the Phase 4 rs485 transport, plus a device
    discovery scanner (bench bring-up; CONFIG_APP_MODBUS_SCAN_ON_BOOT, default off).
    - components/modbus/modbus_master.{c,h}: read transaction + probe (present =
    valid reply OR Modbus exception; timeout = absent) + scan over unit IDs.
    - rs485 transport: add parity to rs485_config_t (8N1 default / 8E1 / 8O1).
    - app_main scan mode: sweep baud x {8N1,8E1,8O1} x ids, quiet on absent, stop
    at first responder. Build via sdkconfig.defaults.scan.
    Status: scanner verified working on the project board (node TX/RX proven in
    Phase 4; clean deterministic timeouts).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
2026-06-23 feat(modbus): Phase 6b — live single-register poll bring-up mode
    P6. Adds CONFIG_APP_MODBUS_POLL_ON_BOOT: reads one FC03 holding register from a
    fixed unit at 1 Hz (8N1), logging value/timeout/exception. Live A/B-swap + wiring
    trial-and-error aid against a known device; build via sdkconfig.defaults.poll
    (defaults to RS-FSJT: unit 1, 4800 8N1, reg 0). Default off; normal build unaffected.
    [app_main.c]
2026-06-24 feat(modbus): Phase 6 — pivot bring-up to SELEC MFM384 (FC04 + float32)
    P6. Retarget the Modbus bring-up from the RS-FSJT-N01 wind sensor (blocked on a
    sensor<->CN1 physical join, not firmware) to a SELEC MFM384 multifunction meter.
    - modbus_rtu: pure modbus_regs_to_f32(regs, ABCD|CDAB) for 32-bit IEEE-754 floats
    spanning 2 registers (MFM384 measurands). memcpy type-pun, no aliasing UB.
    Host KAT: {0x447A,0x0000} ABCD = 1000.0f. ctest 2/2 green.
    - poll bring-up mode: configurable function code (FC03 holding / FC04 input) and
    optional float32 read (2 regs, ABCD/CDAB word order).
    - scan: probe register now configurable (MFM384 known-good linkcheck = reg 6).
    - profiles: sdkconfig.defaul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
2026-06-24 docs(runbook): Phase 6 MFM384 scan Attempt 1 — 0 found/0 garbage (no responder)
    P6. Full baud x parity x id sweep ran clean on board 3c:dc:75:6f:85:dc but the
    MFM384 did not answer in any combo. 0 garbage everywhere => no electrical return
    path / no responder, not a baud mismatch. Next: read comms config off the meter
    front panel + verify A/B/GND/power, widen ID range.
2026-06-24 docs(runbook): Phase 6 — HW cross-check vs proven rak3312_mfm384 reference
    P6. Reviewed org example examples/rak3312_mfm384 (Gate-8 live on this meter).
    Our framing/pins/DE-polarity/float-decode match it byte-for-byte. Their only
    extra is a RAK5802 ENABLE pin on GPIO14 (must be HIGH) — N/A to our board
    (TP8485E, DE/RE on GPIO21, no enable; Phase 4 proved it). Conclusion: firmware
    correct; silence is the MFM384<->CN1 physical link (A/B + common GND).
2026-06-24 docs(runbook): Phase 6 — FC04 also silent; firmware exonerated (ETS same-HW ref)
    P6. Cross-checked southern-rnd/ETS-LORA-Test rak3112_ets_careflow (same RAK3112
    + same MFM384, tested working): reads meter via FC04 input registers, voltage-
    first map (V1N@reg0), float memcpy. Acted on it — added .mfm384-volt profile
    (FC04 reg0 float32) and flashed. Still timeout/0 bytes, same as FC03. Function
    code is not the cause. Pins/baud/DE-polarity match ours; ETS DE=GPIO34 is a
    different carrier, ours GPIO21 is Phase-4-proven. Blocker is physical/meter-not-
    transmitting. Logged electrical bench plan (power, A/B+GND, Saleae on TX/DE/A-B).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
2026-06-24 docs(runbook): Phase 6 — proven ETS ModbusMaster code also times out (0xE2)
    P6. Built a headless port of southern-rnd/ETS-LORA-Test's proven MFM384 path
    (their ModbusMaster lib verbatim, DE GPIO34->21, auto-poll FC04 reg0 + FC03
    reg6). arduino-esp32 3.3.10 built clean on IDF 5.5.4. On board 3c:dc:75:6f:85:dc
    it returns ku8MBResponseTimedOut (0xE2) every read — identical to our firmware.
    Firmware exonerated a 4th way; fault is purely physical (node<->meter link).
    Next: USB-RS485 adapter cross-check on the meter wiring to split board vs meter.
2026-06-24 feat(modbus): Phase 6 MFM384 bring-up GREEN — DE/RE wiring fixed, CDAB confirmed
    P6. Operator fixed a DE/RE connection fault — the entire blocker. Our firmware
    now reads the MFM384 live: FC04 reg0 = V1N ~50.5V, stable, zero timeouts.
    Locked facts (real HW): FC04 input registers, ETS voltage-first map (reg0=V1N),
    word order CDAB (not ABCD — RAK3312 note didn't hold for this meter), 9600 8N1
    unit1. Profiles set to CDAB: .mfm384-volt (reg0 V1N), .mfm384 (reg58 Total kWh).
    Firmware was correct all along (proven 5 ways incl. ETS ModbusMaster run verbatim).
    RUNBOOK Attempt 4 + RS-485 DE/RE silence lesson. Next = 6c (payload + uplink).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
2026-06-24 feat(modbus): Phase 6c — telemetry pipeline (register map, sim, ADR-005 payload, uplink)
    P6c. Sample a Modbus field device (or simulate) -> compact ADR-005 payload -> LoRaWAN uplink.
    Hardware read is verified (Attempt 4), so this is buildable/testable with no meter present.
    - components/payload (pure, host-tested): telemetry.h carries the full ETS-proven MFM384
    register map + sample structs; payload.c encodes a compact versioned binary (3-byte header
    + fixed-point scaled fields), saturating not wrapping. test_payload: exact-byte + signed +
    saturation cases, ctest 3/3 green.
    - components/meter: real reads (MFM384 FC04 CDAB 7 measurands; RS-FSJT FC03 reg0 /10) +
    deterministic simula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
    [app_main.c, meter.c, meter.h]
2026-06-24 docs(modbus): Phase 6c — confirm RS-FSJT scale raw/10 on bench
    P6c. RS-FSJT-N01 sensor verified live on CN1 (unit 1, FC03 reg0, 4800 8N1, zero
    timeouts). Blow test: raw ~33-58 => ~3.3-5.8 m/s confirms raw/10 = m/s (MODBUS_MAP),
    ruling out the /100 variant from one reference. meter_read_rsfsjt already correct;
    locked the finding in code comment + ADR-005.
    [meter.c]
2026-06-24 docs(runbook): Phase 6c — RS-FSJT real read + LoRaWAN uplink GREEN
    P6c. Home lab: RS-FSJT verified on CN1 (4800 8N1 unit1 FC03 reg0); scale locked
    raw/10 via blow test. field-rsfsjt build: session restored, real read 0.40 m/s,
    uplink OK each 60s (no -5). ADR-005 payload 0102000028 on fPort1. Real sensor ->
    encode -> LoRaWAN -> ChirpStack proven for RS-FSJT. MFM384 leg validates via
    sim-mfm384. Next: confirm ChirpStack decode, sim-mfm384 uplink, push/CI/merge/tag.
2026-06-24 docs(state): Phase 6 signed off + merged (Modbus → MFM384/RS-FSJT telemetry → LoRaWAN)
    Records Phase 6 PASS in the §6 State block: PR #1, CI run 28111619969, merge 4a52614,
    tag phase-6-modbus-green, user sign-off 2026-06-24.
2026-06-25 docs(contract): Phase 7 production-hardening plan (rev8)
    Expand the Phase 7 stub into a gated plan on phase/p7-production-hardening:
    entry criteria + sub-phases 7a-7e (watchdog/brownout, light-sleep current gate,
    dual-slot OTA + rollback, NVS-provisioned creds/config, integration soak), each
    with a HIL smoke gate and on-PASS/FAIL/rollback. Adds Phase-7 guardrails
    (watchdog-feed-in-main-loop-only, no-compiled-secrets-after-7d, OTA-partition-
    change = full-erase, gated + image backup), opens OQ-9..12, reserves ADR-006/
    007/008, and logs a PLAN row in the State block. No firmware written or flashed;
    execution held per sub-phase readiness.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
2026-06-25 feat(resilience): Phase 7a — task watchdog + brownout + reset-cause log
    P7a. Field-app task subscribes to the Task Watchdog (panic-on-starve) and feeds
    it via a fed-sleep that splits the inter-sample delay into <=2 s chunks, so the
    long interval never starves the dog while a real hang still trips it. Boot logs
    the reset reason (esp_reset_reason) + a persistent NVS boot counter (faultlog/
    bootcnt). Brownout detector pinned enabled at the IDF ESP32-S3 default level.
    Kconfig: APP_TASK_WDT_TIMEOUT_S (def 15) + debug APP_DEBUG_WDT_STARVE(_AFTER)
    gate aid; repro profile sdkconfig.defaults.wdt-test. CMakeLists requires esp_system.
    HIL gate PASS on project board (MAC 3c:dc:75:6f:85:dc), both hal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
    [app_main.c]
2026-06-25 feat(provisioning): Phase 7d — NVS credentials + runtime config
    P7d. No compiled-in secrets: OTAA creds (DevEUI/JoinEUI/AppKey) and Modbus field
    config (device/baud/parity/unit/interval) move to the NVS 'prov' namespace, which
    takes priority over the compiled lora_credentials.h fallback. lora_is_provisioned()
    gates the join — an unprovisioned node (empty NVS + placeholder key) waits instead
    of bogus-joining. The field loop branches on device at runtime (both meters built).
    Provisioning is an on-device USB-Serial-JTAG console (provisioning.c, console
    component, CONFIG_APP_PROVISIONING_CONSOLE) with prov-* commands that write only the
    'prov' namespace — the 'lorawan' nonces/session are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
2026-06-25 feat(ota): Phase 7c — dual-slot partitions + bootloader rollback
    P7c. Field-safe updates: a dual-slot partition table (ota_0/ota_1 + otadata) with
    CONFIG_BOOTLOADER_APP_ROLLBACK_ENABLE. partitions.csv keeps nvs at the default
    0x9000/0x6000 so the 7d provisioning + LoRaWAN nonces survive the layout change —
    no full erase. ota.c logs the running slot, marks the image valid once healthy
    (cancels a pending rollback), and adds ota-status / ota-activate <0|1> console
    commands (esp_ota_set_boot_partition -> PENDING_VERIFY). APP_BUILD_TAG tells builds
    apart; APP_DEBUG_OTA_BAD (profile sdkconfig.defaults.ota-bad) aborts before
    mark-valid to exercise rollback.
    HIL gate all 3 PASS (project board;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
    [partitions.csv]
2026-06-25 feat(power): Phase 7b — light-sleep duty-cycle (opt-in, default off)
    P7b. CONFIG_APP_LIGHT_SLEEP (default OFF): wdt_fed_delay() turns each <=2 s chunk
    into a manual esp_light_sleep_start() (timer wake) instead of vTaskDelay. RAM is
    retained so the LoRaWAN session survives with no re-join; chunking keeps the task
    watchdog fed; the idle-task watchdog is disabled while sleeping (manual light-sleep
    freezes idle by design, idle_core_mask=0).
    Functional-only this pass per operator (no current target; OQ-12 open). KEY FINDING:
    light-sleep wedges the node on USB power (VBUS + USB-Serial-JTAG) — after cycle 0
    esptool itself can't connect; recovery is plug-in-while-holding-BOOT into download
    mode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
2026-06-27 chore(bench): session park — 7b INA238/Pi rig, IG28ET scan profile, sensor prompt
    End-of-day save (bench not ready; continuing tomorrow).
    - tools/ina238_current.py: Raspberry-Pi INA238 high-side current meter for the 7b
    OQ-12 average-current measurement (true time-average integration). Deployed on the
    Pi (mcp-gateway); parked — bench not ready + INA238 in use elsewhere.
    - firmware/sdkconfig.defaults.scan-stepper: Modbus bus-scan profile tuned for a LEESN
    IG28ET / Leadshine iEM-RS-class integrated stepper (probe FC03 0x0191, IDs 1-31).
    Built green; not yet flashed/wired.
    - docs/RUNBOOK.md: "Session park 2026-06-28" — 7b rig state, IG28ET register map
    (Leadshine iEM-RS convent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
2026-06-28 feat(bench): WS2812 'alive' heartbeat image (CONFIG_APP_LED_HEARTBEAT)
    Standalone bench mode: breathe the onboard WS2812 (GPIO38) cycling colours, with
    no LoRa/Modbus/provisioning/light-sleep — a visible "board is powered & running"
    indicator on ANY supply (DC1 barrel / USB-C / power bank) without a USB host.
    Adds espressif/led_strip (~2.5.5) and profile sdkconfig.defaults.led-heartbeat.
    HIL: flashed to the project board; LED confirmed breathing on a power bank with
    USB unplugged — proves external power works (the earlier "dead on external power"
    was just no visible indicator; the USB-Serial-JTAG wedge is host-only). Also
    confirms U11 WS2812 is populated and usable (was untested "option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
2026-06-28 feat(modbus): FC06/FC16 writes + LEESN IG28ET motion-control bench harness
    Bench tooling (side-quest off Phase 7): drive a Modbus RTU motor over CN1 RS-485.
    - modbus_rtu/master: add FC06 write-single and FC16 write-multiple (build+parse),
    host-tested with golden vectors incl. the LEESN manual frame
    `01 10 00 D0 00 02 04 27 10 00 00 F5 82` (ctest 3/3).
    - app_main JOG console (APP_MODBUS_JOG_CONSOLE): mot-read / mot-enable / mot-disable /
    jog-fwd / jog-rev / jog-stop / goto <pulses>. Boots idle; motion only on a typed,
    bounded, auto-stopping command; goto move capped (IG_GOTO_MAX_COUNTS).
    - Register-discovery dump (APP_MODBUS_DUMP_ON_BOOT): read-only FC03 sweep of non-zero regs.
    - Ver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
2026-06-28 Revert "feat(modbus): FC06/FC16 writes + LEESN IG28ET motion-control bench harness"
    This reverts commit f6afb2e7355dc4b5d946dcddc8d2779ca858fa95.
    [app_main.c, modbus_master.c, modbus_master.h, modbus_rtu.c, modbus_rtu.h]
2026-06-28 chore: complete split — workspace is RS-485 reading only
    Follow-up to the revert of f6afb2e. Removes the last stepper-specific bits so this repo
    is purely RS-485 sensor reading (FC03/FC04 -> LoRaWAN):
    - remove firmware/sdkconfig.defaults.scan-stepper (stepper bench overlay)
    - RUNBOOK: replace the stepper side-quest notes with a pointer to the new repo
    rnd-southerniot/leesn-stepper-control (which now owns Modbus writes + jog/goto +
    the decoded LEESN register map)
2026-06-28 feat(skills): shared ChirpStack gRPC-web client for lorawan-* skills
    _shared/cs_grpcweb.py — minimal gRPC-web client (chirpstack.siot.solutions exposes gRPC-web
    only behind Cloudflare; no REST). call() frames one protobuf request; auth() prefers CS_API_TOKEN.
    Env-driven, no secrets.
2026-06-28 feat(skills): lorawan provision / verify / deprovision skills
    Three self-contained CC skills to register/verify/remove a LoRaWAN device in Southern IoT's
    production ChirpStack (AS923, OTAA 1.0.3) during firmware bring-up, via gRPC-web:
    - lorawan-provision-device: DeviceService.Create + CreateKeys (random DevEUI/AppKey unless
    provided), name fw-<tail>, prints creds; idempotent (ignores ALREADY_EXISTS, reads stored key back).
    - lorawan-verify-join: DeviceService.Get + GetActivation — presence, last_seen, DevAddr.
    - lorawan-deprovision: DeviceService.Delete + List confirm.
    Each SKILL.md: trigger-rich frontmatter, env prereqs, exact commands, PASS/FAIL smoke test,
    cleanup note. UNAUTHENTIC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
2026-06-28 docs(lorawan): provisioning guide + .env.example ChirpStack vars
    - docs/LORAWAN_PROVISIONING.md: the 3 skills, env vars, the gRPC-web/Cloudflare/AS923/OTAA facts,
    end-to-end flow, and a RAK3172 AT-command cheatsheet (DevEUI/AppEUI/AppKey/BAND -> +EVT:JOINED;
    Invalid MIC = wrong AppKey).
    - .env.example: append CS_BASE/UA/CS_API_TOKEN (empty) + known production tenant/app/device-profile
    IDs as non-secret defaults. No real values committed.
2026-06-29 feat(device-profiles): add Modbus device-profile library (MFM384/EEM400/DSE)
    Machine-readable device profiles for CRM auto-provisioning + table-driven firmware.
    Each profile carries bus params + register map + scaling + ADR-005 payload mapping,
    but NOT the Modbus slave ID — that is discovered by the node bus-scan at commissioning
    (same device, different unit ID per client site).
    - schema.json — JSON Schema (draft 2020-12) for a profile.
    - profiles/{selec-mfm384,honeywell-eem400,deepsea-dse}.json — derived VERBATIM from the
    team's proven Arduino/ESP-IDF readers (wire wins; conflict logs preserved per profile).
    Unified device-type registry: MFM384=0x01, RS-FSJT=0x02 (firmware), EEM4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
2026-06-29 docs(crm): CRM-developer guide — driving a Claude agent to build+flash node firmware
    Instruction doc for the crm.siot.solutions developer: how to prompt a Claude agent
    to build the pinned firmware, safety-gated flash (confirm board MAC), 2-plane
    provision (ChirpStack + NVS), and verify uplink — using this repo + device-profiles.
    Corrects the 'regenerate firmware per device' assumption: one image, differentiate
    by DATA (profile + creds via NVS). Includes copy-paste agent prompt, inputs table,
    HW-safety gates, secrets rules, structured result, failure/rollback, and the device
    support matrix (MFM384/RS-FSJT flashable now; EEM400/DSE need reader integration;
    profile-driven generic reader +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
2026-06-29 feat(device_profile): ADR-006 increment 1 — pure profile-driven core
    Foundation for the data-driven runtime: one generic Modbus decoder + one generic
    ADR-005 encoder driven by a device_profile_t (bus + measurand table + payload table),
    so the CRM can provision any profiled device with no firmware rebuild.
    - components/device_profile (pure, host-tested):
    - dp_decode(regs,type,word,scale,offset) — u16/i16/u32/i32/float32 with ABCD/CDAB/
    BADC/DCBA word order; generalises modbus_regs_to_f32. memcpy float, no aliasing UB.
    - dp_encode_payload(profile,values,flags,out) — 3-byte ADR-005 header + table-walked
    fixed-point body (u8/i8/u16/i16/u32/i32), saturating, big-endian, bounds-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
2026-06-29 feat(device_profile): ADR-006 increment 2a — NVS profile blob codec
    Versioned, CRC-checked, endianness-independent (de)serialization of a device_profile_t
    so the CRM can push a full register map to the node's NVS (no firmware rebuild per device).
    - dp_serialize / dp_deserialize + dp_blob_size: big-endian blob (header + measurand recs +
    field recs + CRC-16/MODBUS trailer); floats stored via bit-pattern (host-endian-safe).
    dp_profile_storage_t holds backing arrays the loaded device_profile_t points into
    (DP_MAX_MEAS/FIELDS = 40; DSE's 21 is the worst case today).
    - Self-contained CRC (no modbus dep) keeps the pure core dependency-free.
    - test_device_profile: round-trip (incl. re-encod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
2026-06-29 feat(device_profile): ADR-006 increment 2b — NVS profile store + prov-profile + CRM writer
    Persist a CRM-pushed device-profile blob on the node, so increment 3's generic reader can load it.
    - profile_store (main): NVS 'prov'/'profile' blob read/write. profile_store_save() validates via
    dp_deserialize before persisting (never stores a bad blob); profile_store_load() for the reader;
    profile_store_present() for prov-show.
    - provisioning console: new `prov-profile <hexblob>` command (validates + stores); prov-show now
    reports the stored profile (device_byte + measurand count); REPL line limit 200 -> 1100 (a full
    profile blob is ~900 hex chars).
    - device-profiles/profile_to_blob.py: CR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
2026-06-29 feat(device_profile): ADR-006 increment 3 — on-target generic profile-driven reader
    The field path now consumes a provisioned profile: if NVS holds a valid device-profile blob, the
    generic reader drives the bus (any device, no firmware rebuild); else the compiled path. Runtime
    auto-detect (no Kconfig flag) so the bench can A/B by provisioning/clearing the profile.
    - components/meter: meter_read_profile(port,unit,p,values,n) — walk p->meas, modbus_master_read
    each (fc/qty per type) + dp_decode -> engineering values[]; ESP_FAIL on any miss (caller STALE).
    - app_main run_field_app: load profile via profile_store_load; override bus baud/parity from it;
    per-tick branch -> meter_read_prof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
2026-06-29 docs(adr-006): increment 3 HW-validated on real MFM384
    Profile-driven generic reader proven on board 3c:dc:75:6f:85:dc: MFM384 profile (452 B blob
    via prov-profile) drove a live 23-measurand read with zero compiled MFM384 code in the path —
    PROFILE-DRIVEN device_byte=0x01, V1N=54.67 V (== compiled FC04/CDAB decode), 39 B frame,
    uplink OK, no stale. Data-driven runtime thesis confirmed end-to-end.
    Caveat: 39 B MFM384 profile frame needs a matching ChirpStack decoder (firmware ships the 19 B
    Phase-6c layout) — decoder-from-profile is a CRM-side follow-up.
2026-06-29 feat(device_profile): ADR-006 increment 4 — auto-scan-for-ID (HW-validated MFM384)
    The profile omits the Modbus slave ID (varies per client site); the node discovers it at
    commissioning. meter_scan_for_unit() probes IDs with the profile's scan_fc/scan_reg/scan_qty
    (CRC-valid reply OR exception = present). run_field_app: probe the configured unit first (fast),
    else scan 1..CONFIG_APP_FIELD_SCAN_ID_HI (default 32), then persist the discovered unit to NVS so
    the next boot skips the scan.
    Bench (board 3c:dc:75:6f:85:dc, real MFM384): configured unit deliberately mis-set to 9 ->
    "configured unit 9 silent — scanning bus 1..32" -> "persisted discovered unit 1" -> read V1N 53.5 V,
    uplink OK. Au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
    [app_main.c, meter.c, meter.h]
2026-06-29 feat(device-profiles): decoder-from-profile generator + fleet ChirpStack codec
    Symmetric partner to profile_to_blob.py: profile_to_decoder.py emits a ChirpStack v4 codec straight
    from the profiles, so the ADR-005 frames profile-driven nodes send decode to engineering units in the
    CRM. One combined decoder branches on the payload device byte across all 4 profiles; decode math
    mirrors each payload field (offset+encoding+scale), keys/units from the measurands.
    Closes the loop on the increment-3 caveat (the 39 B MFM384 profile frame had no matching decoder —
    firmware ships only the 19 B Phase-6c one). Generated chirpstack_fleet_decoder.js committed.
    node-validated: RS-FSJT 0102000028 -> wind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
2026-06-29 feat(01-01): frozen-contract models, Settings, and bearer auth
    - requirements.txt: pinned audited deps (fastapi==0.138.1, uvicorn==0.49.0, minio==7.2.20, pydantic==2.12.5, pydantic-settings==2.14.2)
    - requirements-dev.txt: pytest>=8,<9, httpx, pytest-asyncio
    - api/__init__.py: empty package init
    - api/models.py: frozen Pydantic v2 shapes (ModbusParams, Sensor, Build, BuildRequest, ErrorDetail, ErrorResponse)
    - api/config.py: pydantic-settings Settings with lru_cache get_settings() for Depends() + test override
    - api/auth.py: verify_bearer FastAPI dependency via HTTPBearer; raises 401 with error.code=unauthorized on mismatch
    [config.py, models.py]
2026-06-29 feat(01-01): pytest scaffold — conftest fixtures + RED tests (Nyquist Wave 0)
    - tests/__init__.py, tests/unit/__init__.py, tests/integration/__init__.py: package inits
    - tests/conftest.py: settings_override, compiled_readers (["mfm384","rsfsjt"]), profiles_dir (4 JSONs), fake_firmware_bin, minio_mock (S3Error-raising), client (lazy api.main import)
    - tests/unit/test_sensors.py: test_flashable_flag, test_sensor_shape, test_flashable_filter (RED — api.services.profiles absent)
    - tests/unit/test_builds.py: test_get_build_not_found (RED — api.main absent)
    - tests/unit/test_auth.py: test_no_token_rejected (RED — api.main absent)
    - tests/integration/test_builds.py: test_post_build_idempote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
    [config.py]
2026-06-29 feat(01-02): author four device-profiles/*.json metadata files
    - selec-mfm384.json: deviceByte 1, FC04, CDAB, 9600 8N1, payloadBytes 19, isActive true
    - rs-fsjt-n01.json: deviceByte 2, FC03, AB, 4800 8N1, payloadBytes 5, isActive true
    - honeywell-eem400.json: deviceByte 3, isActive false (reader not compiled in)
    - deepsea-dse.json: deviceByte 4, isActive false (reader not compiled in)
    - No flashable key in any file; computed at runtime from compiled_readers.json (D-01)
2026-06-29 feat(01-02): profiles service + GET /v1/sensors router (REQ-sensors-api)
    - api/services/profiles.py: READER_SUFFIX_TO_BYTE map + load_sensors() with
    injectable paths; flashable computed from compiled_readers.json, never from
    profile JSON (D-01 enforcement)
    - api/routers/sensors.py: GET /v1/sensors with ?flashable filter, bearer auth
    guard (T-01-01), fallback to load_sensors() when app.state.sensors unset
    - api/main.py: minimal FastAPI app mounting sensors router (lifespan in 01-05)
    - compiled_readers.json: local dev artifact ["mfm384","rsfsjt"] for test runner
    - pytest tests/unit/test_sensors.py: 3/3 GREEN
2026-06-29 feat(01-03): MinIO dual-client stateless build cache (storage service)
    - Dual Minio clients: internal (stat/fput) + external (presigned URLs)
    - ensure_built: asyncio Lock + double-checked locking, sha256, fput_object
    - get_cached_build: cache-check only, returns None on miss (drives 404)
    - Typed S3Error handling (NoSuchKey/NoSuchBucket/NotFound) — Pitfall 2
    - Presigned URLs from EXTERNAL client with PRESIGNED_EXPIRY_HOURS — Pitfall 4
    - No DB, no queue (D-04 superseded v2)
2026-06-29 feat(01-03): builds router — POST /v1/build, GET /v1/builds/{tag}, GET /v1/provisioning-protocol
    - APIRouter(prefix='/v1', dependencies=[Depends(verify_bearer)]) — T-01-01
    - POST /build: accepts BuildRequest | None, validates tag == FIRMWARE_TAG
    (unknown tag -> 422 unknown_tag, D-06), delegates to ensure_built()
    - GET /builds/{tag}: getattr state fallback -> 404 when MinIO not configured;
    delegates to get_cached_build(), 404 not_found if result is None
    - GET /provisioning-protocol: advisory NVS command set for Phase A flasher;
    appKey flagged secret, no live value (T-01-09, D-07)
    - Reads minio_internal/external + firmware_path from app.state (set at
    lifespan in Plan 01-05); test m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
2026-06-29 feat(01-04): add private k8s manifests + deploy descriptor
    - k8s/namespace.yaml: firmware namespace
    - k8s/deployment.yaml: firmware-service (ClusterIP, port 8000, tcpSocket probe, secretRef firmware-service-env)
    - k8s/service.yaml: ClusterIP-only service — no public exposure (D6)
    - k8s/secret.example.yaml: keys-only template (API_TOKEN, MINIO_*, FIRMWARE_TAG)
    - deploy/cluster.yaml: deploy-to-cluster descriptor (private, no hostname)
2026-06-29 feat(01-05): FastAPI app assembly — lifespan, dual routers, error handlers, /healthz
    - Full lifespan: loads sensor cache + dual MinIO clients + firmware_path at startup
    - Mounts both sensors (Plan 02) and builds (Plan 03) routers under /v1 with auth
    - HTTPException handler unwraps {error:{code,message}} detail to top-level shape
    - RequestValidationError handler emits 422 in frozen {error:{code,message}} shape
    - Generic 500 handler for unhandled exceptions (no internal detail to clients)
    - Unauthenticated GET /healthz for k8s liveness/readiness probe
    - Added FIRMWARE_PATH setting (default /app/firmware/rak3112_rs485_node.bin)
    - tests/integration/conftest.py: client fixture override injects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
    [config.py, main.py]
2026-06-29 feat(01-06): multi-stage Dockerfile + .dockerignore for firmware service
    - Stage 1 (espressif/idf:v5.5.4 AS builder): runs idf.py build for ESP32-S3;
    copies lora_credentials.h.example OVER real creds file (D-07 enforcement);
    generates compiled_readers.json from meter.h regex (D-01 flashable signal)
    - Stage 2 (python:3.12-slim AS runtime): copies firmware.bin + compiled_readers.json
    from builder; installs pinned requirements.txt; mounts api/ + device-profiles/;
    exposes port 8000; CMD runs uvicorn api.main:app
    - ARG/ENV FIRMWARE_TAG surfaces the pinned tag (phase-6-modbus-green) in the runtime
    - .dockerignore excludes .v/, firmware/build/, .git/, .planning/, tests/, tools/,
    hardware/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
2026-06-30 fix(01-06): make idf.py build work in Docker builder stage
    The espressif/idf image only puts idf.py on PATH after sourcing
    $IDF_PATH/export.sh, and under /bin/sh (dash) that script cannot
    auto-detect IDF_PATH from its own location — it requires
    IDF_PATH_FORCE=1 to trust the image's preset IDF_PATH (/opt/esp/idf).
    Bare `RUN idf.py ...` failed `idf.py: not found` (127); sourcing alone
    failed `Could not automatically detect IDF_PATH` (1). Fix:
    `RUN export IDF_PATH_FORCE=1 && . "$IDF_PATH/export.sh" && idf.py ...`.
    Surfaced during the 01-07 cluster deploy build.
    Claude-Session: https://claude.ai/code/session_01Lekki6Cn1wy5oe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
2026-06-30 feat(prov): NVS provisioning console
    Phase 7 de-risk spike (02-01). Adds a USB-Serial-JTAG REPL console
    implementing the frozen /v1/provisioning-protocol contract:
    prov modbus <baud> <parity> <stopBits> <slaveId>
    -> NVS ns:"modbus" keys: modbus_baud/parity/stop/slave
    prov creds <devEui> <joinEui> <appKey>
    -> NVS ns:"lorawan" keys: lorawan_deveui/joineui/appkey
    prov show
    -> prints all NVS state; appKey ALWAYS redacted (T-02-02)
    Prompt string: "esp> " (per frozen protocol spec).
    Console: CONFIG_ESP_CONSOLE_USB_SERIAL_JTAG (Phase 3 finding).
    lora.cpp: lora_join() now reads lorawan_deveui/joineui/appkey from NVS
    (lorawan namespace) before falling back to compiled lora_crede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
2026-06-30 feat(prov): pin phase-7-provisioning-green tag; reconcile provision_node.py
    api/config.py: bump FIRMWARE_TAG default from phase-6-modbus-green to
    phase-7-provisioning-green (the new tag with the NVS console firmware).
    k8s/secret.example.yaml: same FIRMWARE_TAG bump.
    tools/provision_node.py: remove Plane-A ChirpStack auto-register at
    READY_FOR_INSTALLATION (step 7). Per D-11 design decision, ChirpStack
    registration moves to the factory QR scan (POST /provisioning/scan).
    The script now advances to READY_FOR_INSTALLATION and documents the
    new scan-gated registration path. Plane-B (NVS creds) unchanged.
    OPERATOR GATE: firmware-service cluster image rebuild with the new tag
    is deferre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
2026-06-30 feat(spike): WebSerial flash+NVS round-trip prototype + Phase 7 RUNBOOK
    tools/webserial-spike/index.html: browser UI for the two-phase flash spike.
    Serve: python3 -m http.server 8099 (localhost = Web Serial allowed).
    tools/webserial-spike/spike.mjs: esptool-js 0.6.0 (CDN, Espressif-official)
    Phase 1: requestPort -> ESPLoader.main() -> [A2-PROBE] readMac ->
    MAC confirm gate -> fetch binary from firmware service ->
    writeFlash(eraseAll:false, address:0x10000) -> hard_reset
    -> transport.disconnect()
    Phase 2: port.open(@115200) -> waitForLine("esp> ") ->
    prov modbus ... -> prov creds (appKey:T-02-02 never logged) ->
    [A4-PROBE] restart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
2026-07-01 docs(prov): Phase-7 hardware validation (CLI) — A1-A5 resolved, [creds:NVS] confirmed
    Validated on project RAK3112 (MAC 3c:dc:75:6f:85:dc) via esptool + pyserial.
    Flash 0x10000 app-only (no erase, NVS preserved). prov console live; prov creds
    writes NVS (appKey redacted); reboot boot log shows [creds:NVS] DevEUI=3cdc75fffe6f85dc
    + PSRAM + modbus (lora.cpp NVS-first boot proven). A3=\r\n; A4=no reboot cmd (use reset
    line/physical); A5=USB-JTAG re-enumerates on reset; A2 chip MAC readable (esptool-js API
    + Chrome SerialPort survival deferred to 02-08). Built binary predates phase-7 tag —
    Gate A must rebuild from the tag.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
2026-07-01 docs(spike): WebSerial A1-A5 + console read-back RESOLVED (reset-first recipe)
    Confirmed in-browser on RAK3112 3c:dc:75:6f:85:dc via webserial-spike + local
    mock. Key finding: reset-first every phase (setSignals RTS-pulse -> DTR assert)
    or the reopened CDC console reads 0 bytes. A2 = esploader.chip.readMac(esploader)
    returns colon-hex string. esptool-js is fine; blocker was raw WebSerial signals.
    Added getPorts() re-acquire, DTR-assert, and a no-pick Test Console button.
    Claude-Session: https://claude.ai/code/session_01TFoEdKRPuMWCBALo24YbPa
2026-07-01 feat(device-profiles): single source of truth — generate CRM catalog from profiles/
    Resolves the two-representation drift found after the careflow merge: the FastAPI globs the
    top-level device-profiles/*.json (summary catalog) while profile_to_blob/decoder use
    device-profiles/profiles/*.json (full wire profiles) — and they disagreed (MFM384 payloadBytes
    19 vs 39; rs-fsjt-n01 vs rsfsjt-n01 filename).
    - profiles/ is now canonical; profiles_to_catalog.py GENERATES the top-level catalog (exact
    api/models.py Sensor fields; --check mode for CI). payloadBytes now reflects the profile-driven
    layout (MFM384 39, EEM400 43, DSE 47, RS-FSJT 5). flashable stays API-computed (D-01).
    - Moved the p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
2026-07-01 ci: add device-profiles (validate + catalog freshness) and api-tests jobs
    - device-profiles: validate_profiles.py (+jsonschema) + profiles_to_catalog.py --check, so the
    top-level CRM catalog the FastAPI serves can't drift from device-profiles/profiles/ (ADR-006).
    - api-tests: pytest tests/unit + tests/integration for the careflow CRM firmware-build service
    (self-contained — integration mocks MinIO). Locally: 8 passed.
    CI matrix now 6 jobs; CLAUDE.md §4 updated.
2026-07-01 feat(app): factory→field workflow — scan-before-join, idle-if-no-sensor, MAC-derived DevEUI
    Two coupled changes to match the CRM factory→field provisioning workflow.
    Boot flow reorder (run_field_app + app_main):
    - The field app now SCANS the RS-485 bus for the profile's Modbus ID FIRST and idles until a
    sensor answers — it does NOT OTAA-join or uplink without a sensor (the factory idle state; the
    slave ID isn't known until the sensor is wired). Order is now scan → join (once) → read+uplink.
    - If the sensor goes silent for 3 cycles, it drops back and re-scans (session preserved, no re-join).
    - The task watchdog is armed ONLY for the steady-state read loop — never during dis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
2026-07-01 docs(crm): factory→field provisioning workflow for the CRM developer/agent
    New docs/CRM_PROVISIONING_WORKFLOW.md — the authoritative order of operations aligned to the current
    firmware: factory (build with profile compiled in → flash → read MAC-derived DevEUI → CRM mints
    AppKey → prov creds to NVS → QR) then field (wire sensor → scan Modbus ID → QR scan triggers
    ChirpStack registration (D-11) → OTAA join → uplink). Documents the firmware contract points
    (DevEUI-from-MAC boot line, esp> prov console, scan-before-join, idle-if-no-sensor, persist+re-scan),
    the DevEUI-vs-AppKey identity model, and the compiled-per-build profile (pending).
    Calls out the required field-firmw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
2026-07-01 fix(app): retry OTAA join indefinitely with backoff (never halt)
    CRM_PROVISIONING_WORKFLOW §5. A board can power on before the field QR-scan
    registers it in ChirpStack, so early joins are rejected. The field app halted
    after 5 attempts (~50 s) and never joined. Now it retries indefinitely with
    10 -> 30 -> 60 s capped backoff, so the very next attempt after ChirpStack
    registration succeeds — no reboot, no operator action. WDT stays unarmed until
    after join (contract #7); vTaskDelay yields to idle so the long waits are
    reset-safe. Docker-IDF v5.5.4 build green (esp32s3).
    Claude-Session: https://claude.ai/code/session_01Au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
    [app_main.c]
2026-07-01 docs: QR encodes opaque deviceSerial only (QRSEC-01)
    - §0 one-paragraph version, §1 mermaid + step 6, and §3 AppKey bullet
    corrected to state the QR carries only the opaque deviceSerial
    - Removed all credential-bearing-QR wording; backend resolves creds
    from the serial at scan time, matching provisioning.service.ts
    recordFlashResult (QR generated from device.deviceSerial only)
2026-07-02 feat(firmware-service): serve full dual-OTA flash set (bootloader/parttable/otadata/app)
    GET /v1/flash-manifest (name/offset/size/sha256 per region) +
    GET /v1/flash-part/{name} streaming from /app/firmware. Bearer-protected like
    the rest of the API. Lets the CRM WebSerial flasher install the dual-OTA
    partition layout instead of the legacy single-app 0x10000 write, which left
    boards booting the residual old image.
    Claude-Session: https://claude.ai/code/session_013T2SA74hDuxN5zrZjfoaaH
2026-07-02 feat(firmware-service): factory-reset flash set + profile-blob endpoint
    - flash manifest gains nvs-blank (0x9000, 0x6000 of 0xFF): a factory flash now
    wipes stale NVS (old creds, profile, LoRaWAN session/nonces). A stale session
    made a re-provisioned board skip OTAA re-join and uplink on keys ChirpStack
    no longer knew — frames silently dropped, never self-healing. Fresh nonces
    are safe at factory: every flash pairs with a fresh mint + fresh ChirpStack
    registration at QR scan (ADR-007 preserve-nvs protects FIELD OTA, a
    different lifecycle stage).
    - GET /v1/profile-blob/{key}: serialize device-profiles/profiles/<key>.json via
    profile_to_blob.py (same module the C host test cros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
    [main.py]
2026-07-02 feat(sim): profile-driven simulator — validate any device profile over LoRaWAN without a meter (#10)
    ADR-006 increment 5 (software half). Adds a pure `dp_simulate(tick, profile, values, n)`
    that synthesizes deterministic, non-saturating, time-varying engineering values for a
    profile's carried measurands (each sized from its payload field encoding+scale, gentle
    per-field sinusoid). Wired into run_field_app: with CONFIG_APP_FIELD_SIMULATE + a
    provisioned profile, the field app loads the profile, skips the RS-485 bus/scan, joins,
    and uplinks per-profile synthesized telemetry with TELEMETRY_FLAG_SIMULATED set — so
    EEM400/DSE/MFM384 (no meter on hand) exercise the blob->encode->fleet-decoder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
    [app_main.c]
2026-07-05 feat(firmware-service): multi-product support — serve senseflow alongside careflow (P5.1)
    The firmware-service was single-product (careflow RS-485/Modbus). This adds a second product
    (senseflow e-ink / I2C) additively, without touching the FROZEN v1 contracts (api/models.py). Default
    product = careflow, so every existing v1 call is byte-identical and all prior tests pass unchanged.
    Registry & sourcing:
    - api/products.py (new): product registry (careflow always; senseflow when SENSEFLOW_ROOT set). Each
    Product carries firmware tag/binary/flash dir, reader manifest + device-byte map, prov command set,
    boot markers, and catalog/serializer paths. Cross-repo sourcing = "model B" (pre-built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
2026-07-06 chore(k8s): pin firmware-service image to immutable sha tag b60ea9d
    Deployed 2026-07-06: P5.1 multi-product + dual-OTA boot artifacts baked
    by the Dockerfile (no more manual runtime-image trick). FIRMWARE_TAG in
    firmware-service-env bumped in lockstep (MinIO build-cache key).
    imagePullPolicy Always -> IfNotPresent: sha tags are immutable.
    Claude-Session: https://claude.ai/code/session_01SshwPNe78Y9KMt91kaXGBP
2026-07-06 feat(p5.2): product-aware flasher contract + reference flasher + provisioning tooling
    Repo-side of P5.2 (serving/tooling; stack-agnostic). Makes the flash + provisioning path product-aware
    for careflow (Modbus) and senseflow (I2C), and closes the Codex P2 finding on PR #11.
    Firmware-service (Codex P2 fix):
    - flash.py: /v1/flash-manifest now echoes `product` and gives each part a product-qualified `path`
    (/v1/flash-part/{name}?product=<p>). A flasher that follows `path` verbatim can't drop the product
    and fetch careflow bytes for a senseflow manifest (flash-part defaults a missing ?product= to
    careflow). Present for every product so the contract is unambiguous. +2 tests (senseflow + ca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
    [provision_node.py, provision_nvs.py, provtemplate.py]
2026-07-06 feat(p5.2): tools/install_decoder.py — install a product's ChirpStack JS codec on its device-profile
    P5.2 Plane-A: senseflow uplinks need the senseflow decoder on a senseflow-specific device-profile (not
    the shared/careflow one — don't clobber its Modbus codec). Idempotent find-or-create device-profile +
    install JS codec + optional device repoint, over gRPC-web (reuses the lorawan-provision-device skill's
    cs_grpcweb client + chirpstack-api). Targets whatever CS_BASE points at — set to DEV 10.10.8.140 for
    the dev-only Plane-A; production is Fahim's and must not be written from here.
    - Decoder verified correct offline: 0110000a7d26eb → temp_C 26.85 / pressure_hPa 996.3 (matches the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
    [install_decoder.py]
2026-07-07 feat(p7): consume shared siot-lorawan-node component for the LoRaWAN stack
    Remove the byte-identical LoRaWAN radio path (lora.cpp/.h, EspHalS3.h, ota.c/.h,
    lora_credentials.h.example) from main/ and pull it from the shared component
    rnd-southerniot/siot-lorawan-node (git v0.1.0), which both careflow and senseflow now share (P7).
    jgromes/radiolib comes in transitively. Builds green (rak3112_rs485_node.bin, 87% app-partition free).
    Product-specific code (Modbus/RS-485, provisioning-console, device_profile) stays in this repo; the
    device_profile v1->v2 unification with the shared provisioning is deferred (separate migration).
2026-07-07 docs(p7): three-layer topology note (CLAUDE.md/README) + operator skills
    - CLAUDE.md + README: P7 topology — LoRaWAN stack now the shared siot-lorawan-node component (git dep);
    CRM automation canonically in the siot-node-firmware-automation hub (deployed source here until
    cutover); device-profiles stay v1 (v1→v2 deferred).
    - .claude/skills/provision-node: end-to-end node bring-up (build→safety-gated flash→Plane A/B→verify),
    product-aware, two-stack prompt.
    - .claude/skills/install-chirpstack-decoder: install a product's JS codec on its ChirpStack
    device-profile (idempotent, gRPC-web, never clobbers another product's codec).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
2026-07-08 feat: WS2812 node-status indicator (onboard GPIO38) (#15)
    status_led.{c,h}: drives the onboard WS2812 (PIN_WS2812_DIN / GPIO38) as a node-status indicator on
    its own low-priority animation task — independent of the LoRa/Modbus path (unlike the bench-only
    APP_LED_HEARTBEAT). States: BOOT (dim white), SENSOR_WAIT (red slow breathe), JOINING (amber pulse),
    IDLE (dim green breathe = healthy), SENSOR_FAULT (red fast blink), plus a one-shot bright-green flash
    on each successful uplink.
    Wired into run_field_app at the state transitions: sensor-wait before discovery, joining before OTAA,
    idle+green-flash on a good read/uplink, red-blink on a stale/failed read. led_strip added to the main
    componen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
    [app_main.c, status_led.c, status_led.h]
2026-07-08 feat(scanner): Pi 5 RS-485 scanner/profiling station (#16)
    * feat(scanner): P0 — additive RS-485 scan-* discovery console (Pi scanner station)
    New firmware/main/scan_console.c/.h: read-only diagnostic REPL commands the Pi 5 scanner
    drives over the esp> console to discover an unknown Modbus device's registers —
    scan-cfg / scan-probe / scan-ids / scan-read / scan-sweep. Each wraps only the existing
    modbus_master_read/_probe + rs485_init; machine-parseable OK/ERR output, hex register words.
    Additive + safe: gated by CONFIG_APP_SCAN_CONSOLE (default n; whole TU compiles out when off),
    registered ONLY from the unprovisioned idle branch in app_main (UART1 free, no field app on the
    bus, SX126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
2026-07-08 feat(device-profiles): honeywell-eem400-scanned (Pi scanner-discovered) (#17)
    * feat(device-profiles): add honeywell-eem400-scanned (Pi scanner-discovered)
    The Honeywell EEM400-D-MO profiled end-to-end by the Pi RS-485 scanner station in a blind two-board
    bench test (discovered at 9600/N/unit3, swept all 52 FC03 registers, inferred u16, operator-labeled
    from the datasheet). type_byte 5; 9 measurands (3-phase V/I, total active/reactive power, + tariff-1
    energy as a u32 ABCD accumulator); 23-byte payload. Regenerates the fleet decoder + catalog.
    Distinct from the hand-authored honeywell-eem400 (type_byte 3) — a worked example of the scanner
    producing a reusable profile so the same model on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
2026-07-08 feat(scanner): touch-only kiosk controls (on-screen keyboard + exit) (#18)
    * feat(scanner): touch-only kiosk controls (on-screen keyboard + exit button)
    The Pi kiosk has no physical keyboard, so the Alt+F4/Ctrl+Alt+Q exit and text entry were unusable.
    Add on-screen controls to the UI:
    - ⌨ keyboard button + auto-show on field focus → toggles squeekboard (Wayland OSK) via its DBus
    interface sm.puri.OSK0 (POST /api/kiosk/keyboard).
    - ⏻ Exit button → closes the kiosk browser back to the desktop (POST /api/kiosk/exit → pkill chromium),
    with a confirm.
    Both endpoints are no-ops off a squeekboard/Chromium kiosk. deploy/careflow-scanner.service gains the
    session-bus env (XDG_RUNTIME_D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
2026-07-09 docs: deployment kickoff + architecture handoff + session handoff (#19)
    Three handoff docs for the firmware-service deployment (Arif + Fahim, 2026-07-09) and continuity:
    - FAHIM_HANDOFF.md — full architecture + production CRM/ChirpStack flow for both node products
    (careflow RS-485/Modbus + senseflow I2C/e-ink): three-layer topology, per-node firmware, the api/
    service, the two-plane factory→field provisioning sequence, and the dev/production two-stack rule
    (with Mermaid diagrams).
    - DEPLOY_KICKOFF.md — the deploy runbook/kickoff prompt for Fahim's session (recommend Option A:
    redeploy this repo's api/, not the hub cutover; verify the eem400-scanned profile + Pi reachability).
    -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
2026-07-09 chore(deploy): fix Docker build for private siot-lorawan-node component (#20)
    The firmware-service Dockerfile compiles firmware at image-build time
    (idf.py build). Since P7 the LoRaWAN stack moved to the PRIVATE component
    rnd-southerniot/siot-lorawan-node (git: dep in firmware/main/idf_component.yml),
    so a clean `docker build` failed at the compile stage — the ESP-IDF component
    manager cannot clone a private repo without auth. This blocked Option A of the
    Fahim deploy.
    Fix mirrors the CI idf-build job: fetch the component into
    firmware/components/siot-lorawan-node/ as a LOCAL component (which overrides the
    git: managed dep, so `idf.py build` needs no auth). Two paths, one Dockerfile:
    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
2026-07-11 feat(api): careflow provisioning-protocol advertises prov-profile (C6) (#24)
    careflow's /v1/provisioning-protocol advertised prov_command_ids
    ("modbus","creds","show") — missing "profile" (senseflow already had it). A CRM
    that renders WRITE commands from the protocol would silently skip the NVS
    profile write, so the CRM shipped a pinned `prov-profile <blobHex>` fallback as
    a careflow-specific special-case.
    Add "profile" to careflow's prov_command_ids (order: modbus, creds, profile,
    show = write-then-verify) so the profile write comes from the protocol natively
    and the CRM's pinned fallback becomes unnecessary — the flash path is then fully
    protocol-driven for every product. Safe: the ca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
2026-07-11 docs(skills): provision-node-prod — pre-flash prod CRM→ChirpStack smoke test (#25)
    New skill mirroring the dev provision-node flow but PROD-scoped and no-flash:
    register a device in production ChirpStack through the CRM's one-shot
    POST /chirpstack/register-device, verify, and (for a throwaway) delete it — a
    pre-flash write smoke test. Validated end-to-end 2026-07-11 (throwaway
    create→verify→delete, prod left clean).
    Captures the confirmed prod facts so a future session doesn't re-derive them:
    - CRM API base http://10.10.8.168:30400 (scomm-api NodePort, root path); UI is
    crm.siot.solutions (Cloudflare/Next.js only).
    - Tenant-per-client register contract: applicationId+deviceProfi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
2026-07-12 fix(skills): lorawan-provision-device — pre-check existing DevEUI + warn on AppKey mismatch
    CreateKeys is a no-op on an existing device -> a freshly-passed APP_KEY is silently
    ignored (stored key wins) -> join MIC mismatch (RadioLib -1116). provision.py now
    GetKeys-pre-checks + WARNs; SKILL.md documents "always check first / on-node NVS
    AppKey MUST equal CS GetKeys". (Mirrors siot-node-firmware PR #5; hit on careflow fw-6f85dc.)
